TechPaula/LT6502/Case/LT6502_DisplayFront.3mf

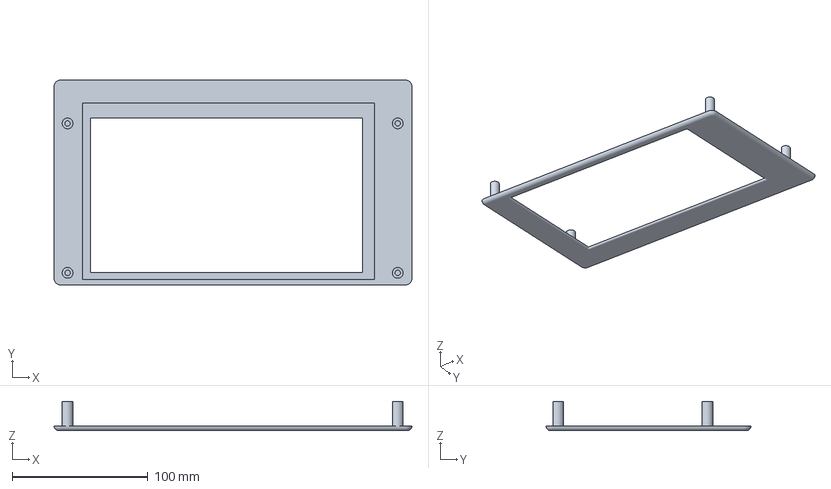
[picture p1: CAD file, 2026-02-14, last stored version]
Case/LT6502_DisplayFront.3mf
263.5 x 151.0 x 21.7 mm
