TechPaula/LT6502/Schematics/EXP-TRANSPUTER/EXP-TRANSPUTER.step

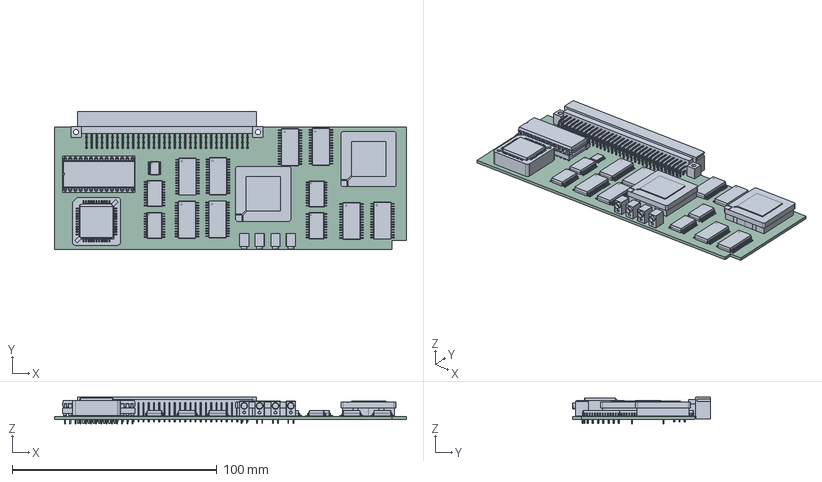
[picture p2: CAD file, 2025-12-27, last stored version]
Schematics/EXP-TRANSPUTER/EXP-TRANSPUTER.step
172.0 x 67.6 x 13.1 mm
SOIC-20W_7.5x12.8mm_P1.27mm x 4
SOP-28_8.4x18.16mm_P1.27mm x 8
PinSocket_1x10_P2.54mm_Vertical x 4
PinSocket_2x03_P2.54mm_Vertical x 8
PinSocket_2x10_P2.54mm_Vertical x 4
Tnn_PGA84 x 2
LTL-4221NHBP x 4
DIN41612_C_3x32_Male_Horizontal_THT
TSSOP-20_4.4x6.5mm_P0.65mm
PLCC-44-AT
plcc44
DIP-28_W15.24mm
DIP-28_W15.24mm_Socket
EXP-TRANSPUTER_PCB
