TechPaula/LT6502/Schematics/Keybed/LT6502_KEYBED.step

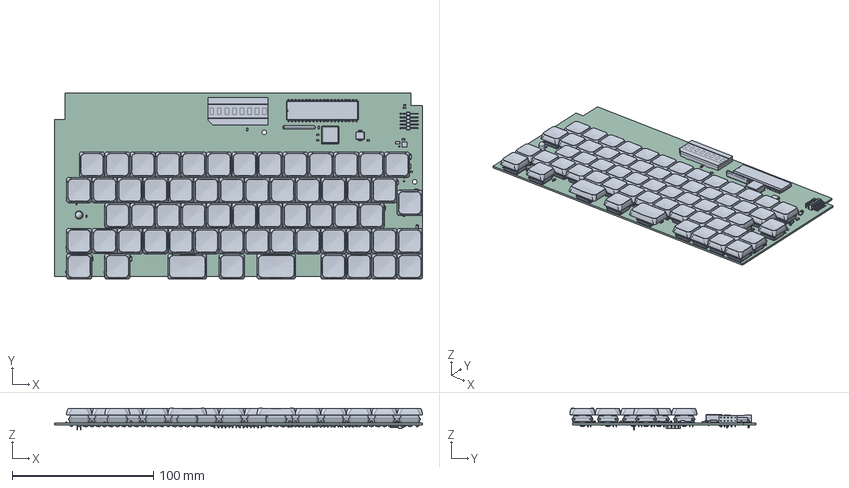
[picture p3: CAD file, 2025-12-19, last stored version]
Schematics/Keybed/LT6502_KEYBED.step
260.5 x 132.0 x 15.3 mm
Kailh Choc FunkMonk 1u x 59
D_SOD-123 x 58
SSOP-16_5.3x6.2mm_P0.65mm
LED_0603_1608Metric x 11
C_0805_2012Metric x 7
R_0603_1608Metric x 14
C_1206_3216Metric x 2
PinHeader_2x05_P2.54mm_Horizontal
Kailh Choc FunkMonk 1.5u x 2
LED_D5.0mm
R_Array_SIP9
HDSP-2502
R_0402_1005Metric
STL9P3LLH6
Oscillator_DIP-8
DIP-40_W15.24mm
PinHeader_1x04_P2.54mm_Horizontal
LT6502_KEYBED_PCB
