TechPaula/LT6502/Schematics/LT6502/LT6502_SIMPLE.step

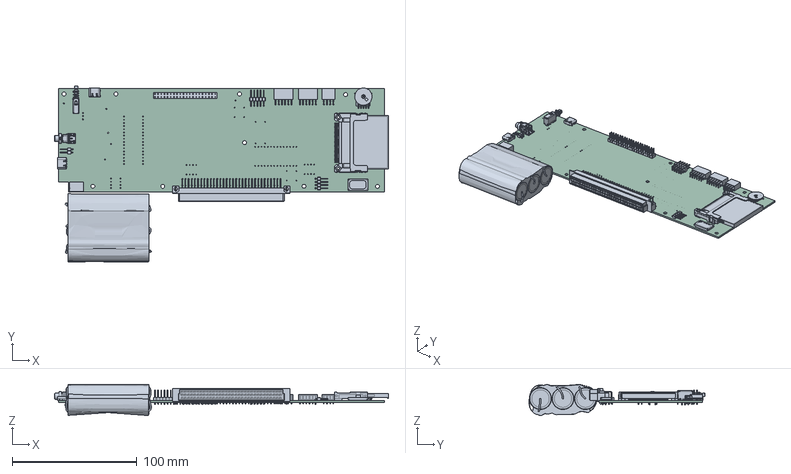
[picture p4: CAD file, 2025-12-17, last stored version]
Schematics/LT6502/LT6502_SIMPLE.step
267.5 x 140.8 x 25.0 mm
LC1258EENP
PinHeader_1x02_P2.54mm_Horizontal
86094648813H55V1LF
CMS-160925-078SP-67
RK10J12R0A0B
PinSocket_2x06_P2.54mm_Horizontal x 2
LeadsArray
3S BMS
Kapton
TL1250F180RQRCLR
UJ20-C-H-G-SMT-1-P16-TR x 2
693120035011_PATTE x 2
693120035011_PIN_HAUT_COURTE
693120035011_PIN_BAS_LONGUE x 3
693120035011_PIN_HAUT_LONGUE x 2
693120035011_PIN_BAS x 22
693120035011_PIN_HAUT x 22
CompactFlash (CF) Memory Card
PinHeader_1x04_P2.54mm_Horizontal
PinSocket_2x04_P2.54mm_Horizontal
PinHeader_2x20_P2.54mm_Vertical
PinHeader_2x05_P2.54mm_Horizontal
LT6502_PCB
