TechPaula/LT6502/Schematics/Multi-Ex/Expansion-Template.step

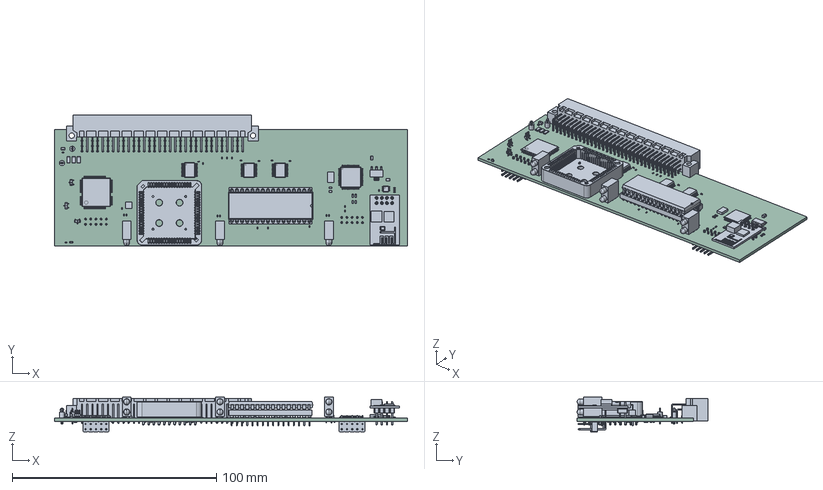
[picture p5: CAD file, 2026-02-22, last stored version]
Schematics/Multi-Ex/Expansion-Template.step
173.0 x 64.2 x 17.0 mm
R_0603_1608Metric x 6
PinHeader_1x03_P1.00mm_Vertical_SMD_Pin1Left x 3
STL9P3LLH6
R_0402_1005Metric x 25
C_0402_1005Metric x 29
SSOP-20_5.3x7.2mm_P0.65mm x 3
TestPoint_Loop_D1.80mm_Drill1.0mm_Beaded x 2
TQFP-44_10x10mm_P0.8mm
PinsArrayLR
PinsArrayTB
LED_0603_1608Metric
C_0805_2012Metric x 3
DIP-32_W15.24mm
DIP-32_W15.24mm_Socket
R_1206_3216Metric x 3
ESP8266-01_ESP-01
LTL-42D1NMHDP1 x 3
SSOP-8_2.95x2.8mm_P0.65mm
SOT-223
Pins
PLCC-68-AT
PinHeader_2x05_P2.54mm_Horizontal x 2
Multi-Ex_PCB
