TechPaula/LT6502/Case/HingeParts.3mf

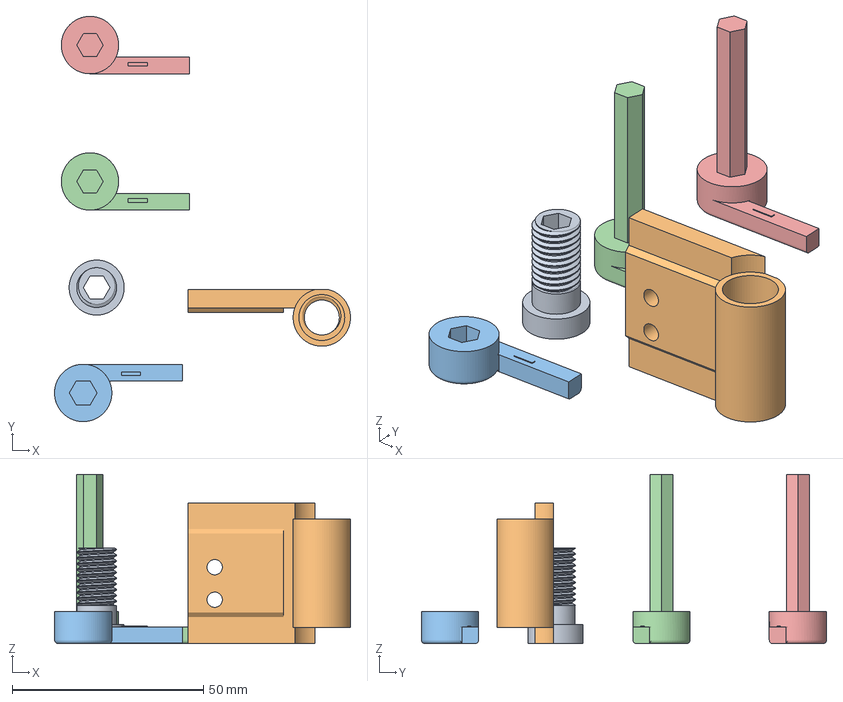
[picture p6: CAD file, 2026-02-14, last stored version]
Case/HingeParts.3mf
77.4 x 105.9 x 44.3 mm
Hinge_ThreadedHollowHex.stl
Hinge_LidPart.stl
Hinge_Base_RHS.stl
Hinge_Base_LHS.stl x 2
