TechPaula/LT6502/Case/Hinge_LidPart.stl

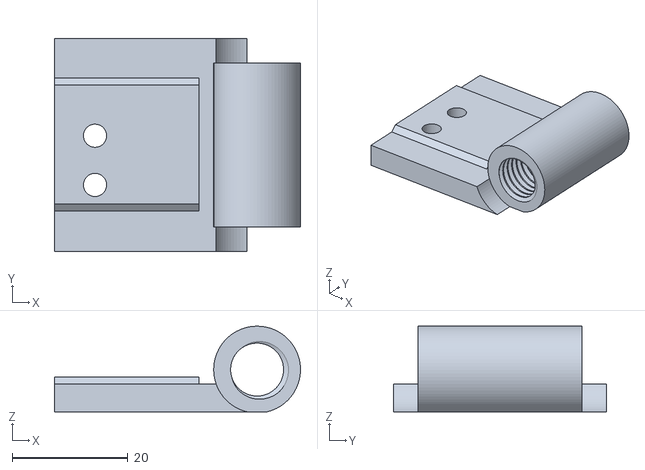
[picture p7: CAD file, 2026-02-11, last stored version]
Case/Hinge_LidPart.stl
42.5 x 36.8 x 14.8
