TechPaula/LT6502/Case/Hinge_Base_RHS.stl

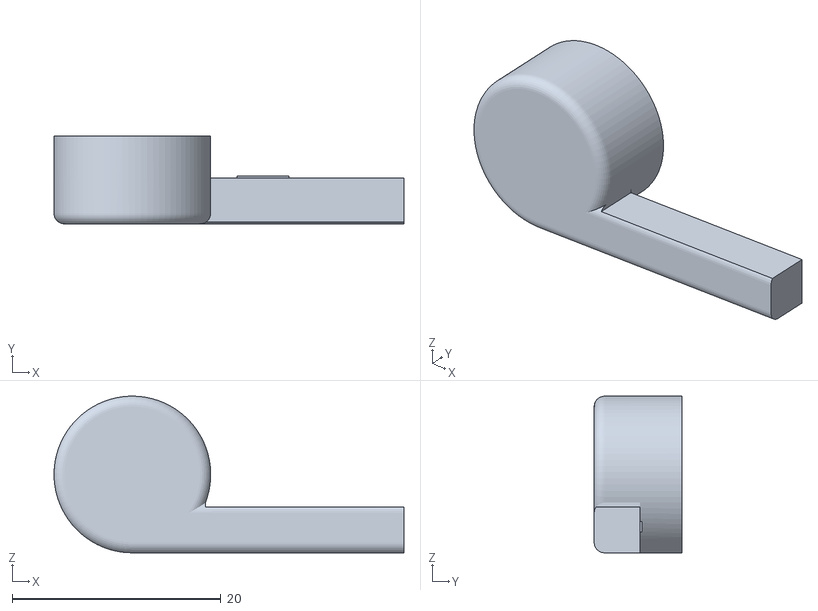
[picture p8: CAD file, 2026-02-11, last stored version]
Case/Hinge_Base_RHS.stl
33.5 x 8.40 x 15.0
