TechPaula/LT6502/Case/Hinge_Base_LHS.stl

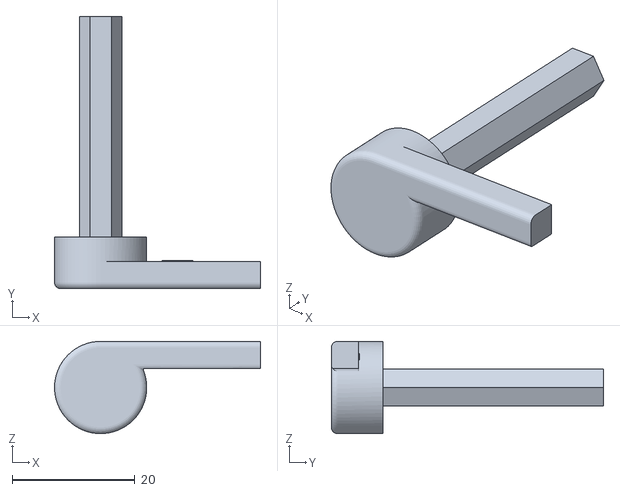
[picture p9: CAD file, 2026-02-11, last stored version]
Case/Hinge_Base_LHS.stl
33.5 x 44.3 x 15.0
