TechPaula/LT6502/Case/Hinge_ThreadedHollowHex.stl

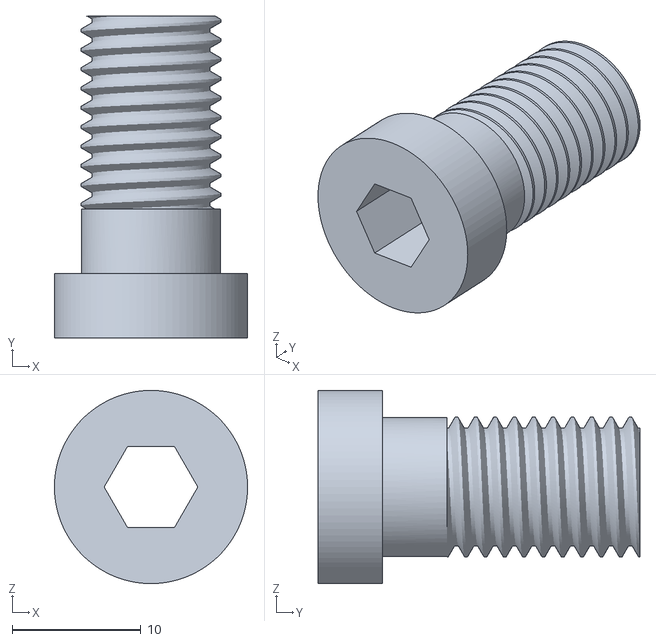
[picture p10: CAD file, 2026-02-11, last stored version]
Case/Hinge_ThreadedHollowHex.stl
15.0 x 25.0 x 15.0
