TechPaula/LT6502/Case/LT6502_DisplayBack.3mf

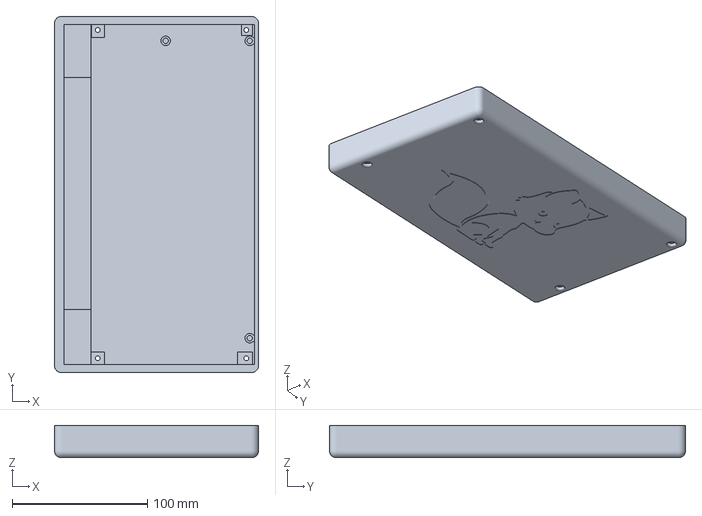
[picture p11: CAD file, 2026-02-08, last stored version]
Case/LT6502_DisplayBack.3mf
151.0 x 263.5 x 24.0 mm
