TechPaula/LT6502/Case/LT6502_BASE_TOP.3mf

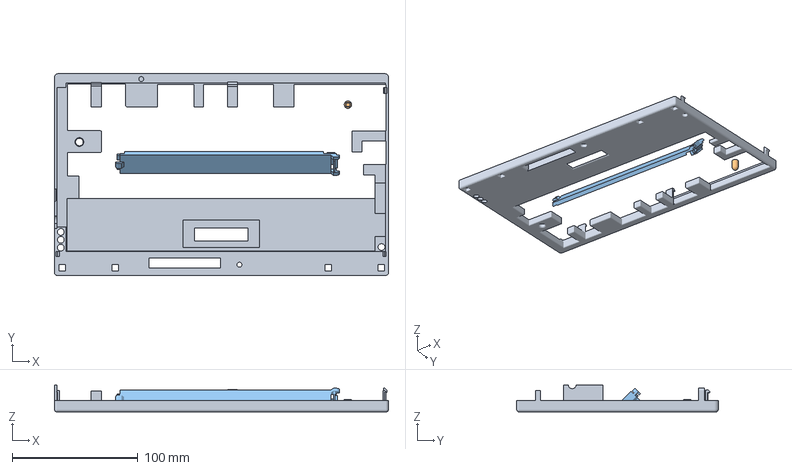
[picture p12: CAD file, 2026-02-08, last stored version]
Case/LT6502_BASE_TOP.3mf
265.5 x 160.4 x 21.5 mm
LT6502_BASE_TOP.stl
PowerButton.stl
ExpansionCover.stl
