TechPaula/LT6502/Case/PowerButton.stl

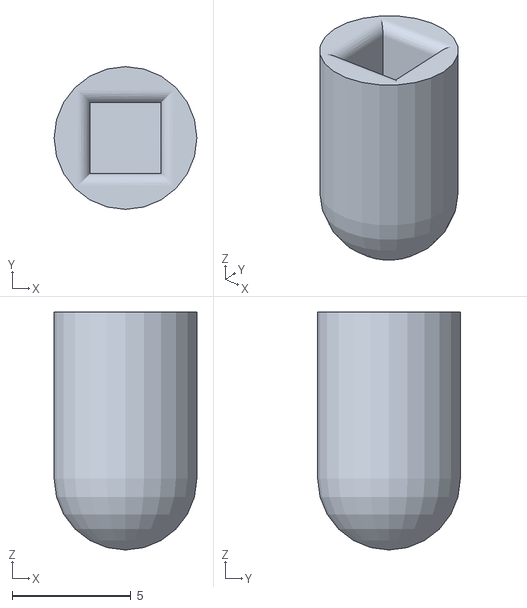
[picture p13: CAD file, 2026-02-04, last stored version]
Case/PowerButton.stl
6.00 x 6.00 x 10.0
