TechPaula/LT6502/Case/ExpansionCover.stl

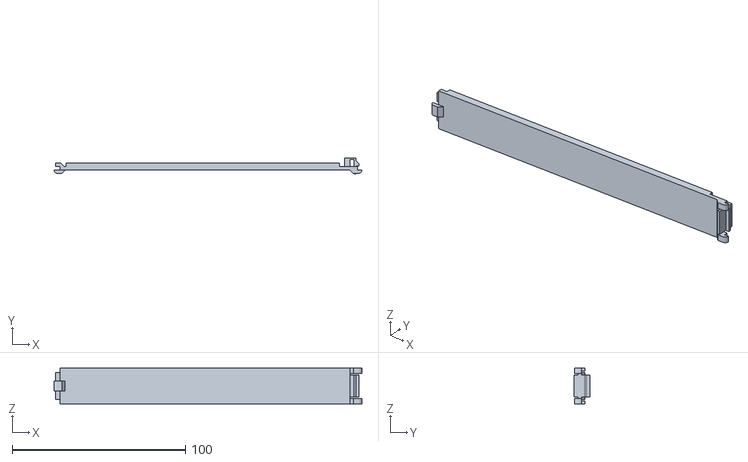
[picture p14: CAD file, 2026-02-04, last stored version]
Case/ExpansionCover.stl
178.0 x 9.50 x 20.7
