TechPaula/LT6502/Case/LT6502_BASE_LOWER.3mf

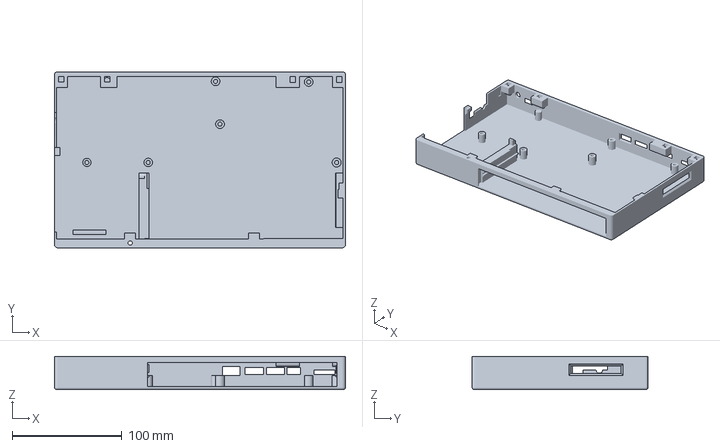
[picture p15: CAD file, 2026-02-02, last stored version]
Case/LT6502_BASE_LOWER.3mf
265.6 x 160.4 x 30.5 mm
