TechPaula/LT6502/Case/LT6502_HINGES_COVERS.3mf

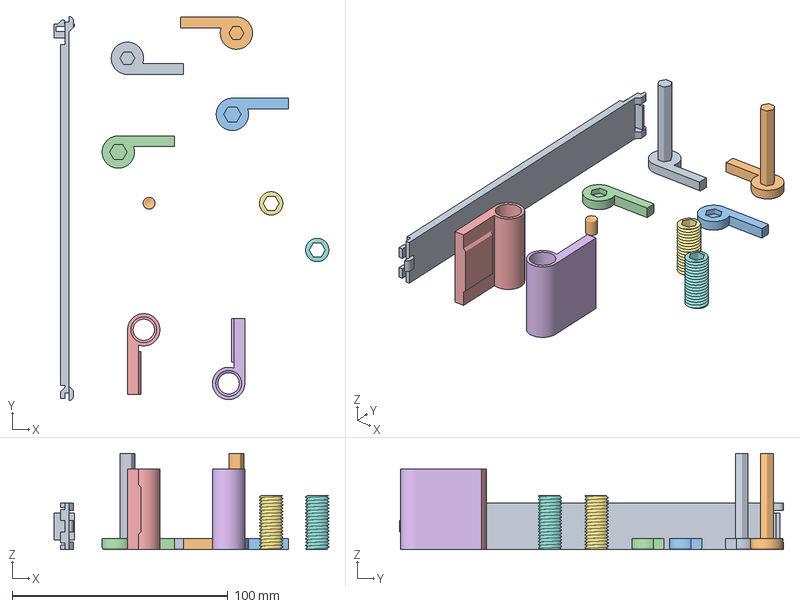
[picture p16: CAD file, 2026-01-03, last stored version]
Case/LT6502_HINGES_COVERS.3mf
127.4 x 178.0 x 44.5 mm
Hinge_Base_LHS.stl x 2
Hinge_Base_RHS.stl x 2
Hinge_LidPart.stl x 2
Hinge_ThreadedHollowHex.stl x 2
ExpansionCover.stl
PowerButton.stl
