TechPaula/LT6502/Case/LT6502_BASETOP_HINGES_COVERS.3mf

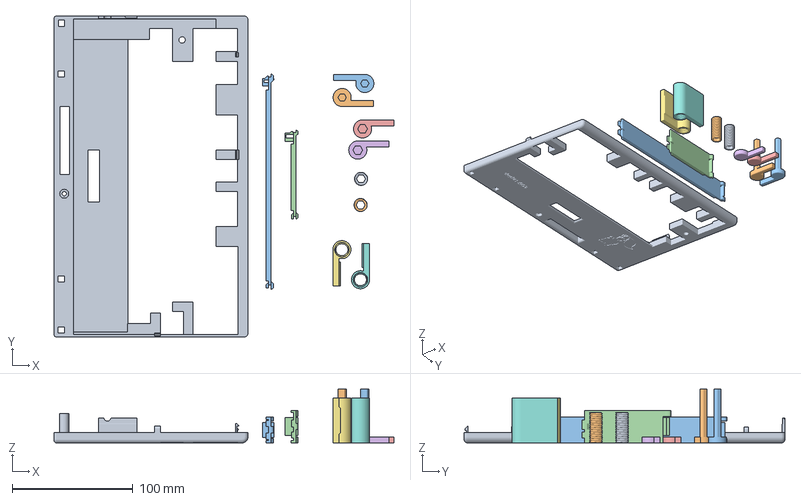
[picture p17: CAD file, 2025-12-30, last stored version]
Case/LT6502_BASETOP_HINGES_COVERS.3mf
281.2 x 265.5 x 44.5 mm
LT6502_BASE_TOP.stl
Hinge_Base_LHS.stl x 2
BatteryCover.stl
Hinge_Base_RHS.stl x 2
Hinge_LidPart.stl x 2
Hinge_ThreadedHollowHex.stl x 2
ExpansionCover.stl
