TechPaula/LT6502/Case/LT6502_DISPLAY_CASE.3mf

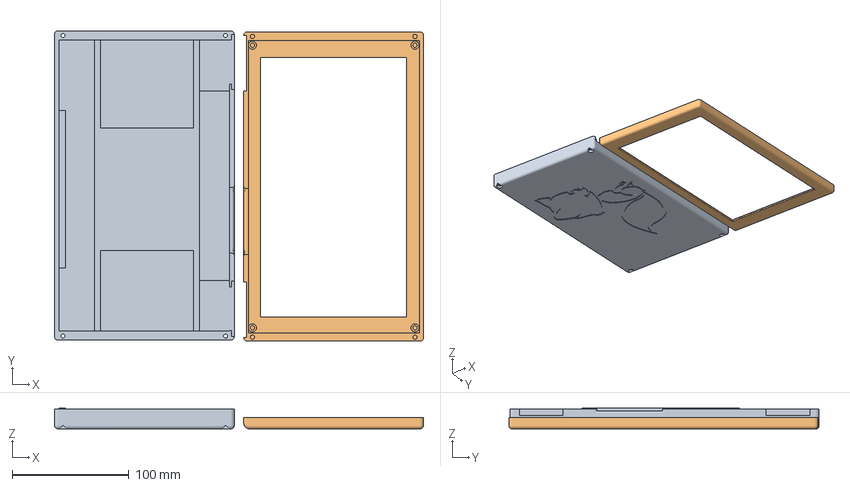
[picture p18: CAD file, 2025-12-30, last stored version]
Case/LT6502_DISPLAY_CASE.3mf
316.6 x 266.4 x 17.9 mm
LT6502_DISPLAY_REAR.stl
LT6502_DISPLAY_FRONT.stl
