TechPaula/LT6502/Case/LT6502_BASE_HINGES_COVERS.3mf

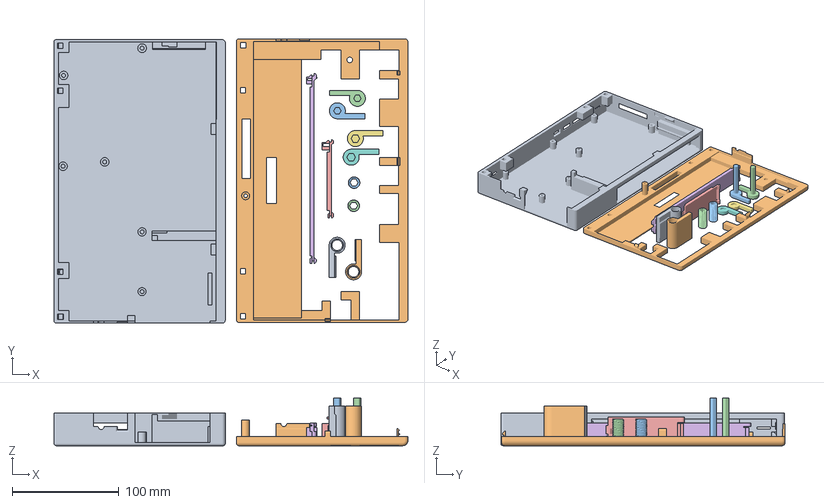
[picture p19: CAD file, 2025-12-28, last stored version]
Case/LT6502_BASE_HINGES_COVERS.3mf
331.5 x 266.3 x 44.5 mm
LT6502_BASE.stl
LT6502_BASE_TOP.stl
Hinge_Base_LHS.stl x 2
BatteryCover.stl
ExpansionCover.stl
Hinge_Base_RHS.stl x 2
Hinge_LidPart.stl x 2
Hinge_ThreadedHollowHex.stl x 2
