TechPaula/LT6502/Case/LT6502_DISPLAY_REAR.stl

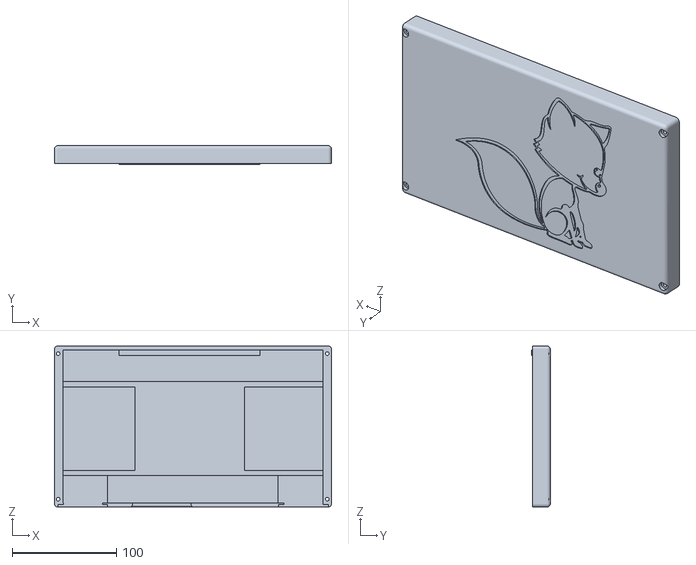
[picture p20: CAD file, 2025-12-27, last stored version]
Case/LT6502_DISPLAY_REAR.stl
265.5 x 17.9 x 154.3
