TechPaula/LT6502/Case/BatteryCover.stl

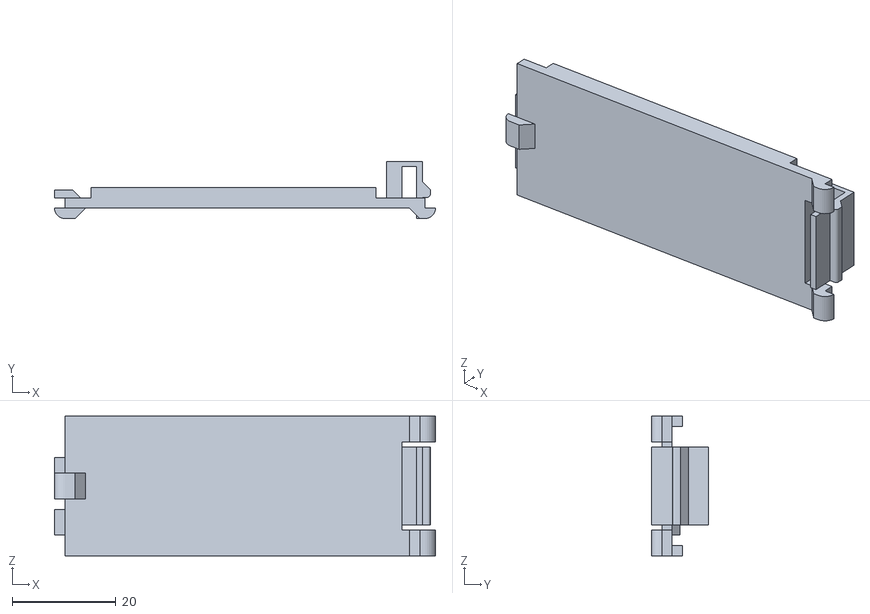
[picture p21: CAD file, 2025-12-27, last stored version]
Case/BatteryCover.stl
73.5 x 11.0 x 27.0
