TechPaula/LT6502/Case/LT6502_HINGE_RHS.stl

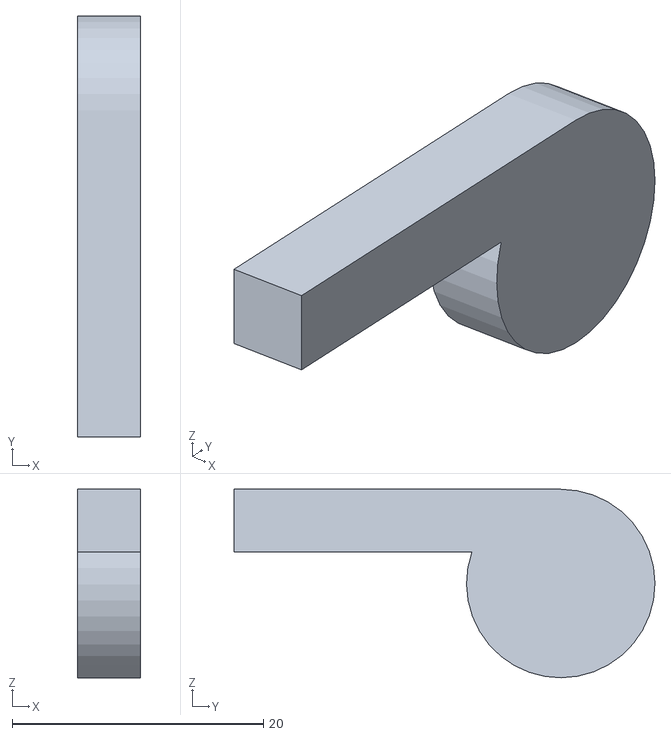
[picture p22: CAD file, 2025-12-26, last stored version]
Case/LT6502_HINGE_RHS.stl
5.00 x 33.5 x 15.0
