TechPaula/LT6502/Case/LT6502_HINGE_LID.stl

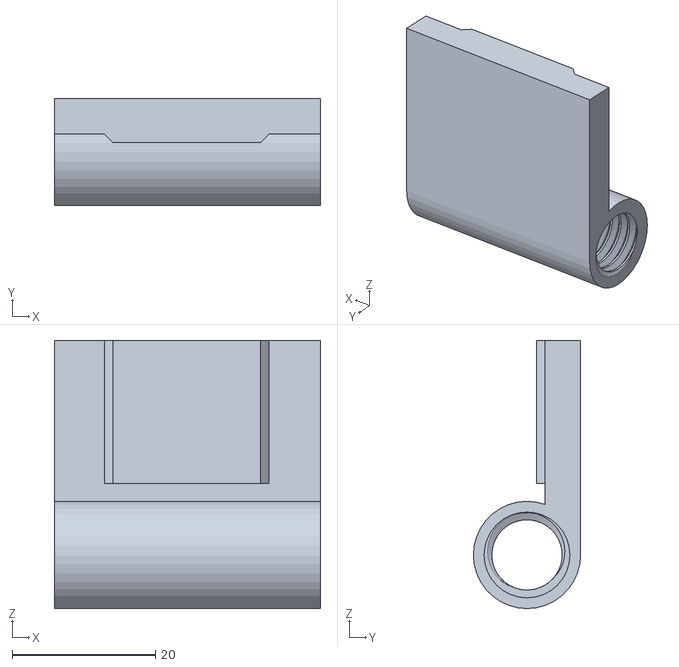
[picture p23: CAD file, 2025-12-26, last stored version]
Case/LT6502_HINGE_LID.stl
37.2 x 15.0 x 37.5
