TechPaula/LT6502/Case/LT6502_THREAD_BARREL.stl

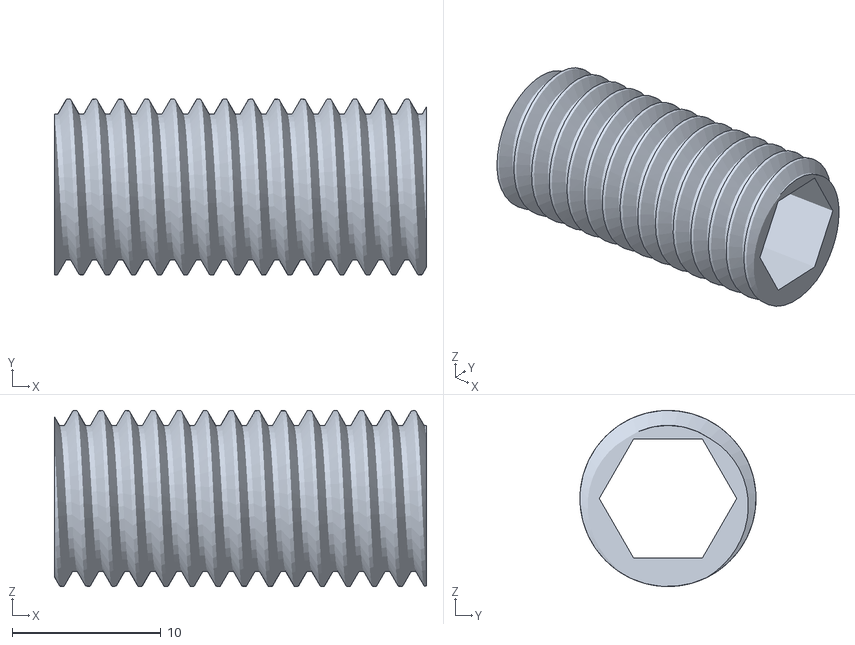
[picture p24: CAD file, 2025-12-26, last stored version]
Case/LT6502_THREAD_BARREL.stl
25.0 x 11.8 x 11.8
