TechPaula/LT6502/Case/LT6502_HINGE_LHS.stl

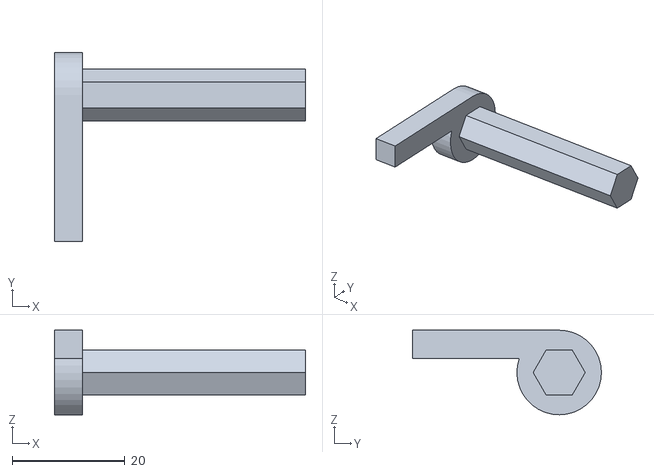
[picture p25: CAD file, 2025-12-26, last stored version]
Case/LT6502_HINGE_LHS.stl
44.5 x 33.5 x 15.0
