TechPaula/LT6502/Case/HingeBody_ptD.stl

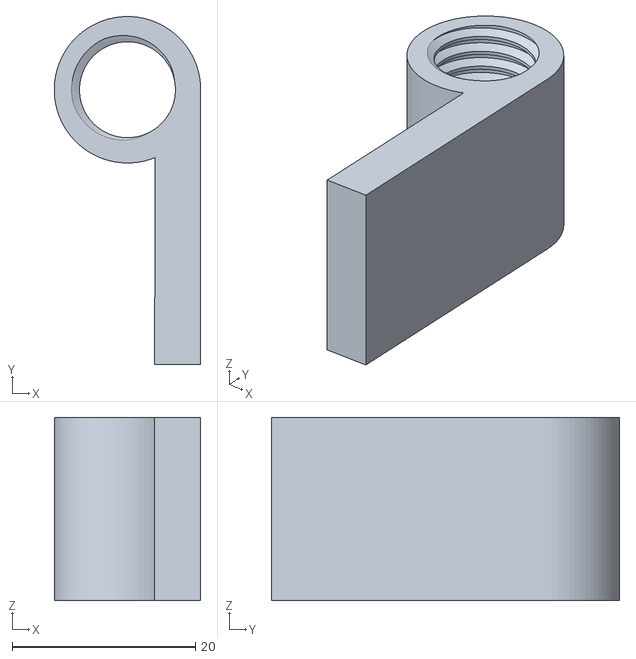
[picture p26: CAD file, 2025-12-26, last stored version]
Case/HingeBody_ptD.stl
16.0 x 38.0 x 20.0
