TechPaula/LT6502/Case/HingeSeatB.stl

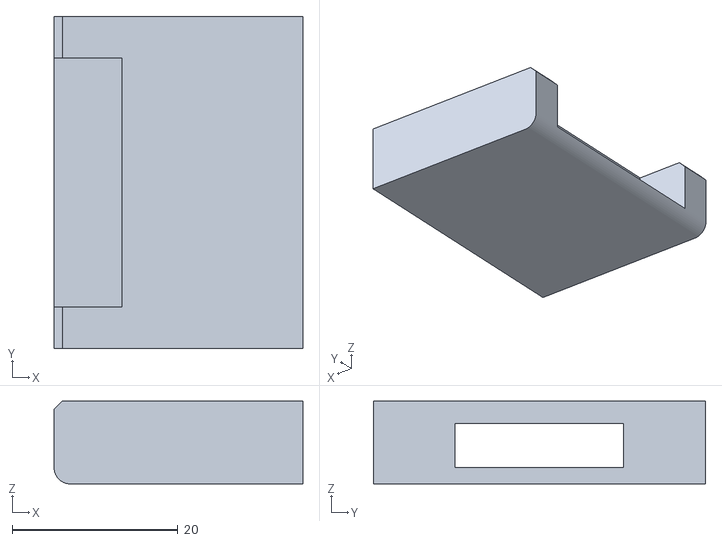
[picture p27: CAD file, 2025-12-26, last stored version]
Case/HingeSeatB.stl
30.0 x 40.0 x 10.0
