TechPaula/LT6502/Case/HingeBody_ptC.stl

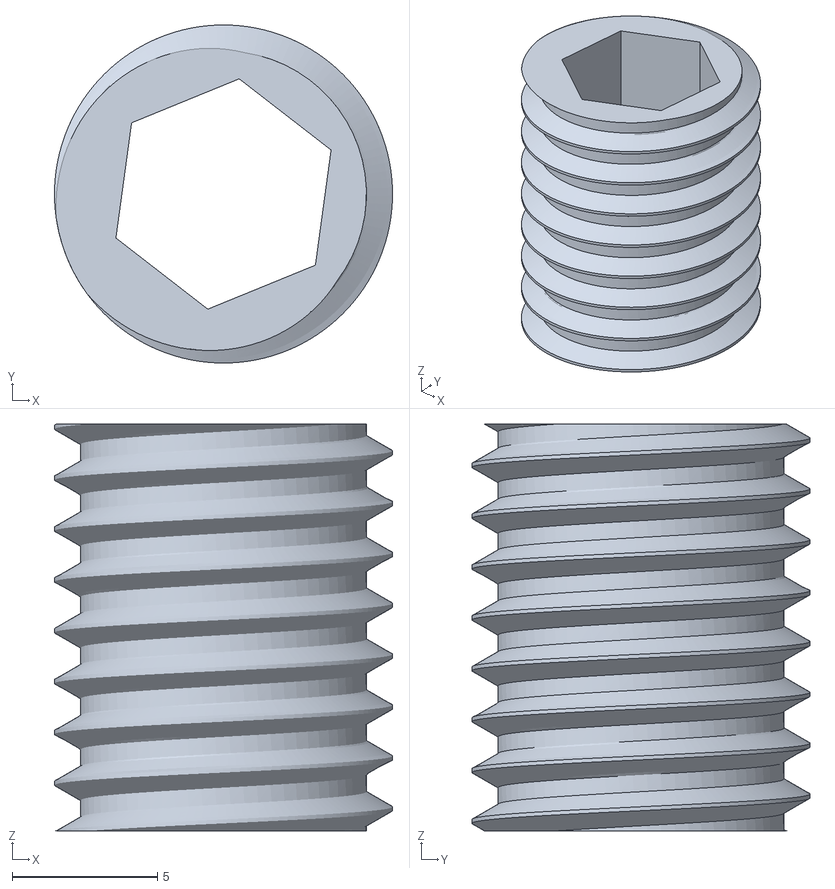
[picture p28: CAD file, 2025-12-26, last stored version]
Case/HingeBody_ptC.stl
11.6 x 11.6 x 14.0
