TechPaula/LT6502/Case/HighBody_ptB.stl

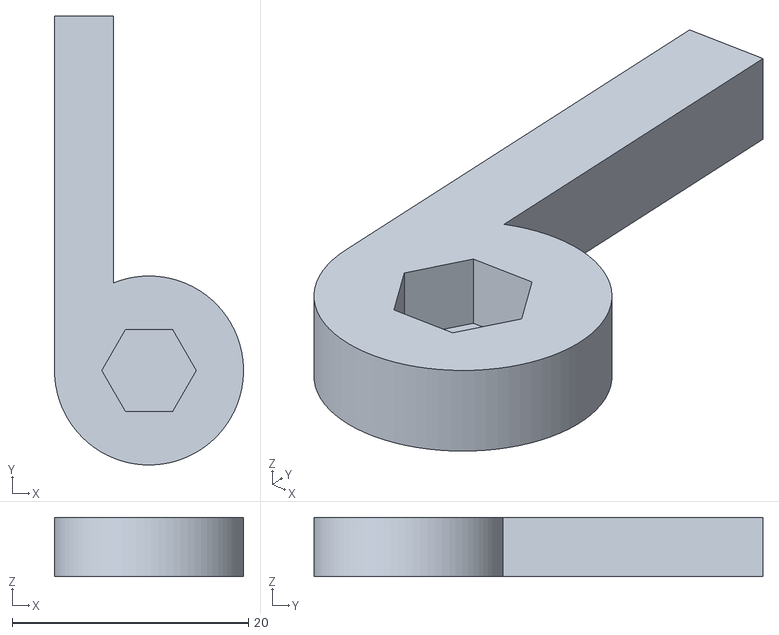
[picture p29: CAD file, 2025-12-26, last stored version]
Case/HighBody_ptB.stl
16.0 x 38.0 x 5.00
