TechPaula/LT6502/Case/HingeSeatA.stl

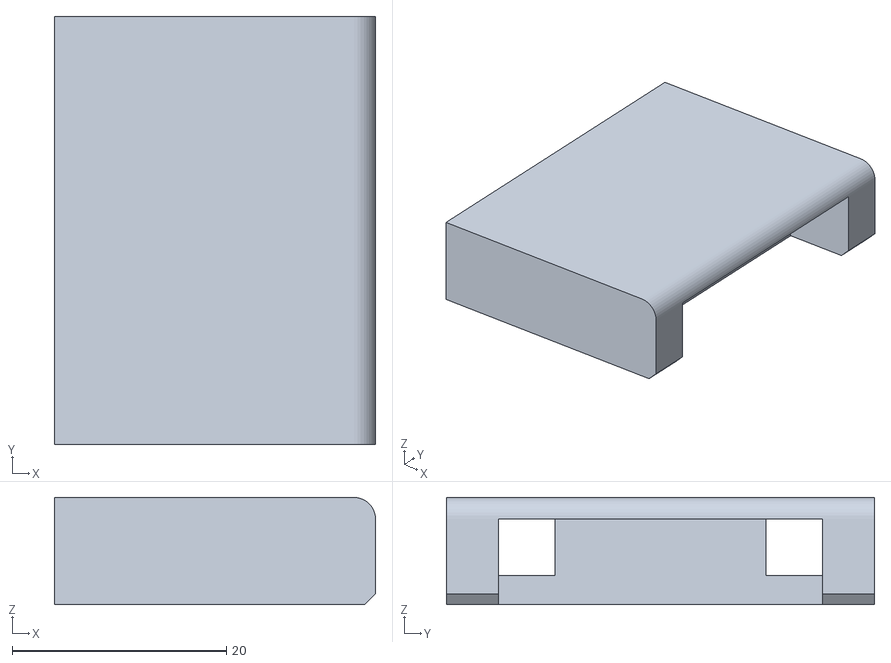
[picture p30: CAD file, 2025-12-26, last stored version]
Case/HingeSeatA.stl
30.0 x 40.0 x 10.0
