TechPaula/LT6502/Case/HingeBody_ptA.stl

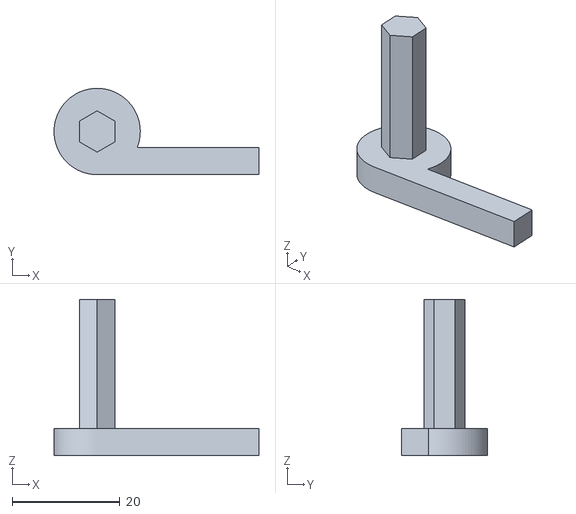
[picture p31: CAD file, 2025-12-26, last stored version]
Case/HingeBody_ptA.stl
38.0 x 16.0 x 29.0
