TechPaula/LT6502/Case/TestHinge.3mf

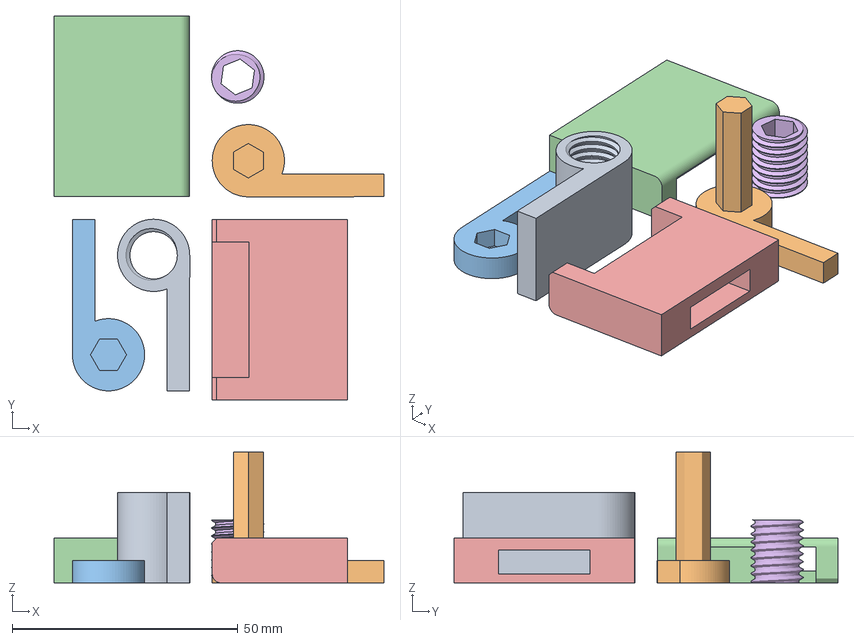
[picture p32: CAD file, 2025-12-26, last stored version]
Case/TestHinge.3mf
73.0 x 85.0 x 29.0 mm
