TechPaula/LT6502/Case/LT6502_Display_Back_20251226.stl

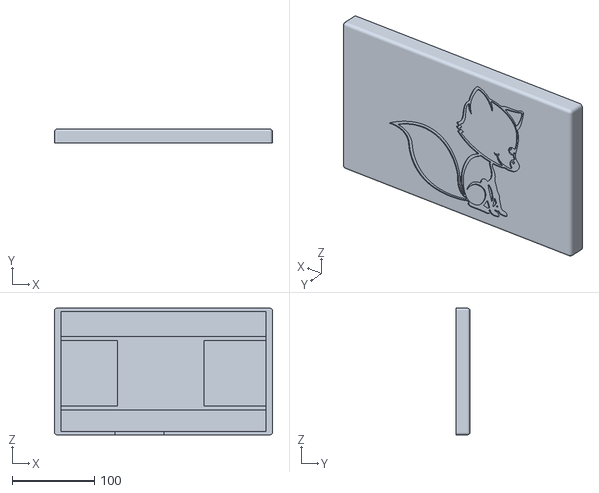
[picture p34: CAD file, 2025-12-26, last stored version]
Case/LT6502_Display_Back_20251226.stl
265.5 x 16.9 x 154.3
