TechPaula/LT6502/Case/LT6502_BaseTop_20251219.stl

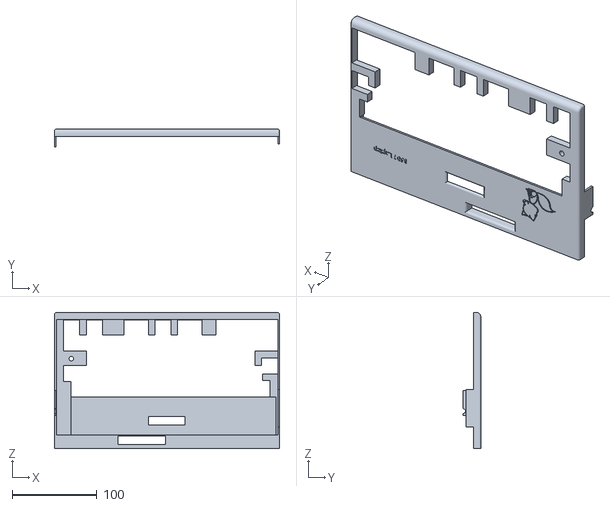
[picture p35: CAD file, 2025-12-19, last stored version]
Case/LT6502_BaseTop_20251219.stl
265.5 x 20.8 x 160.5
