TechPaula/LT6502/Case/LT6502_base_20251219.stl

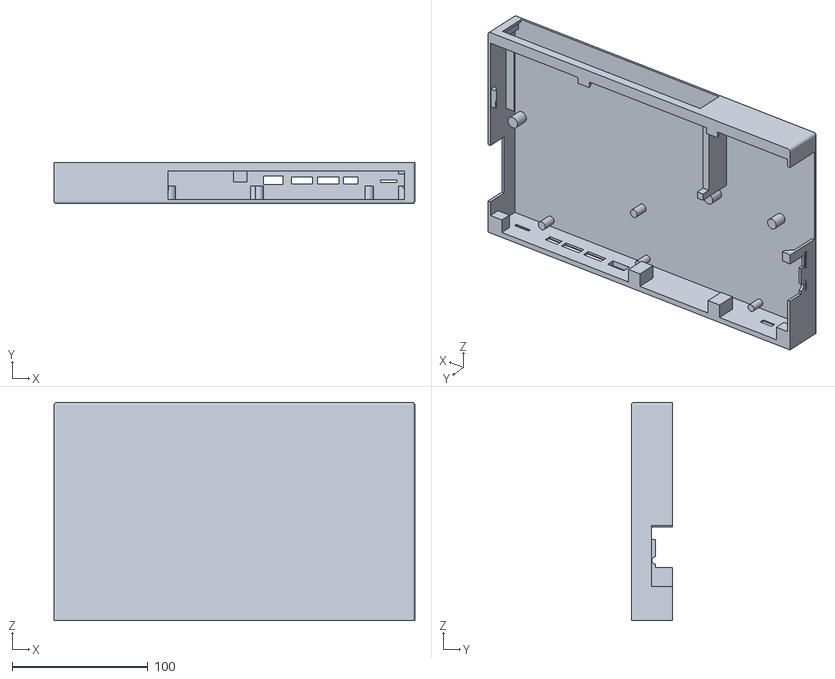
[picture p36: CAD file, 2025-12-19, last stored version]
Case/LT6502_base_20251219.stl
265.6 x 30.5 x 160.4
