TechPaula/LT6502/(list of files, cad)

Other CAD files:
Case/LT6502_BASE.3mf
Case/LT6502_BASE.stl
Case/LT6502_BASETOP.3mf
Case/LT6502_BASE_LOWER.stl
Case/LT6502_BASE_TOP.stl
Case/LT6502_DISPLAY_FRONT.stl
Case/LT6502_DisplayBack.stl
Case/LT6502_DisplayFront.stl
