TechPaula/LT6502/Schematics/Multi-Ex/Multi-Ex.kicad_pcb

## KiCad design Schematics/Multi-Ex/Multi-Ex.kicad_pcb (2026-02-22, last stored version)

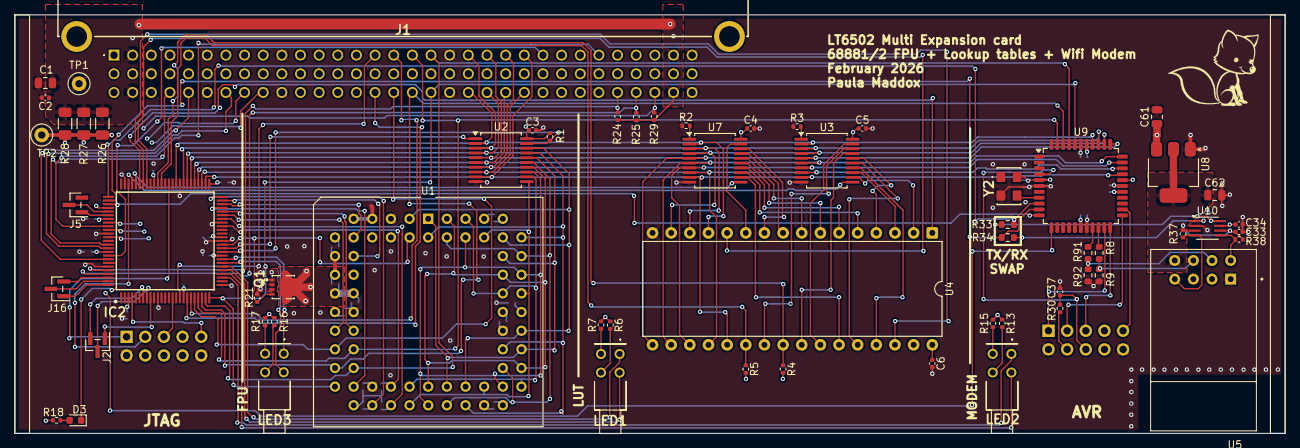
[picture p37: board Multi-Ex.kicad_pcb from above]

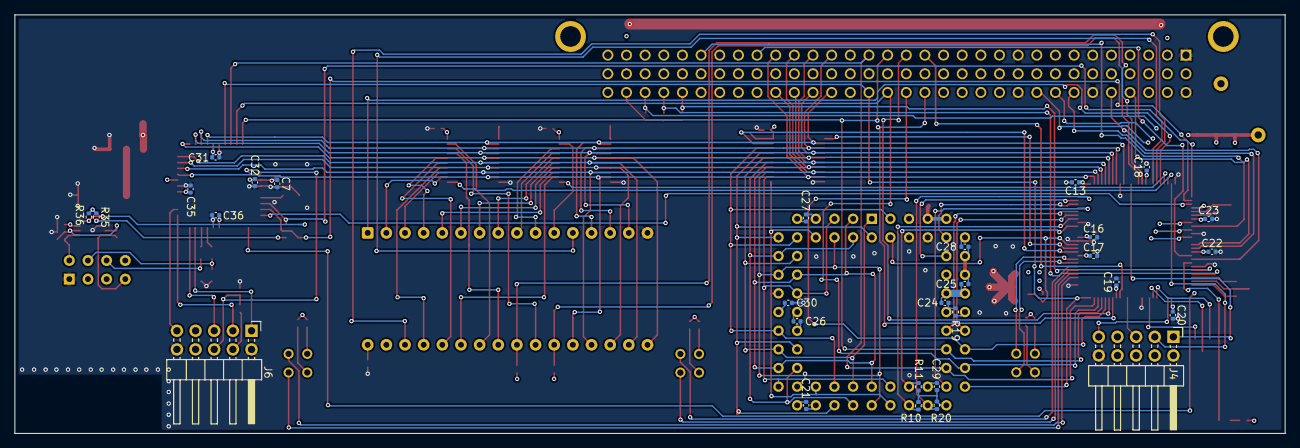
[picture p38: board Multi-Ex.kicad_pcb from below]

Board: 4 copper layers, 173.0 x 57.0 mm, 91 parts (29 on the bottom side), 120 nets.

Parts:
C1: 22uF 25V; C_0805_2012Metric
C2, C3, C4, C5, C6, C7, C13, C16, C17, C18, C19, C20, C21, C22, C23, C24, C25, C26, C27, C28, C29, C30, C31, C32, C33, C34, C35, C36, C37: 100nF; C_0402_1005Metric
C61, C62: 10uF NP; C_0805_2012Metric
D3: LED; LED_0603_1608Metric
FOX1: SYM_Flash_Large; Fox_avatar_18mm
IC2: ATF1508AS-7AX100; QFP50P1600X1600X120-100N
J1: DIN41612_02x32_AC(CAPS); 86093967113745ELF
J2, J5, J16: Conn_01x03; PinHeader_1x03_P1.00mm_Vertical_SMD_Pin1Left
J4, J6: Conn_02x05_Odd_Even; PinHeader_2x05_P2.54mm_Horizontal
LED1, LED2, LED3: LTL-42D1NMHDP1; LTL42D1NMHDP1
Q1: STL9P3LLH6; STL20N6F7
R1, R4, R5, R10, R11, R20, R24, R25, R29, R30, R35, R36, R37, R38: 10K; R_0402_1005Metric
R2, R3, R19: 0R; R_0402_1005Metric
R6, R7, R13, R15, R16, R17, R18: 470R; R_0402_1005Metric
R8, R91: 1K8; R_0603_1608Metric
R9, R92: 3K3; R_0603_1608Metric
R21: 100K; R_0402_1005Metric
R26, R27, R28: 0R; R_1206_3216Metric_Pad1.30x1.75mm_HandSolder
R33, R34: 0R; R_0603_1608Metric
TP1, TP2: TestPoint; TestPoint_Loop_D1.80mm_Drill1.0mm_Beaded
U1: MC68882_PLCC_68; PLCC-68_THT-Socket
U2: 74HC245; SSOP-20_5.3x7.2mm_P0.65mm
U3, U7: 74LS573; SSOP-20_5.3x7.2mm_P0.65mm
U4: SST39SF040; DIP-32_W15.24mm
U5: ESP8266-01_ESP-01; XCVR_ESP8266-01_ESP-01
U8: AMS1117-3.3; SOT-223-3_TabPin2
U9: ATmega644P-20A; TQFP-44_10x10mm_P0.8mm
U10: TXS0102DCT; SSOP-8_2.95x2.8mm_P0.65mm
Y2: ECS-3961-200-AU-TR; ECS3961200AUTR

Connections:
+3.3V: C33.1, C62.1, R37.1, R38.1, U5.8 (VCC), U8.2 (VO), U10.3 (VCCA), U10.6 (OE)
+5V: C3.1, C4.1, C5.1, C6.1, C7.1, C13.1, C16.1, C17.1, C18.1, C19.1, C20.1, C22.1, C23.1, C31.1, C32.1, C34.1, C35.1, C36.1, C61.1, IC2.3 (VCCIO_1), IC2.18 (VCCIO_2), IC2.34 (VCCIO_3), IC2.39 (VCCINT_1), IC2.51 (VCCIO_4), IC2.66 (VCCIO_5), IC2.82 (VCCIO_6), IC2.91 (VCCINT_2), J4.4, J6.4, Q1.1 (S_1), Q1.2 (S_2), Q1.3 (S_3), R1.2, R4.2, R5.2, R6.1, R7.2, R13.1, R15.2, R16.1, R17.2, R18.2, R21.1, R26.2, R27.2, R28.2, R30.1, R35.1, R36.1, TP2.1, U2.20 (VCC), U3.20 (VCC), U4.32 (VCC), U7.20 (VCC), U8.3 (VI), U9.5 (VCC), U9.17 (VCC), U9.27 (AVCC), U9.29 (AREF), U9.38 (VCC), U10.7 (VCCB), Y2.4 (VDD)
/Connector/A0: IC2.25 (I/O_19), J1.C18, U1.26 (A0), U9.40 (PB0)
/Connector/A1: IC2.24 (I/O_18), J1.A18, U1.25 (A1), U9.41 (PB1)
/Connector/A2: IC2.23 (I/O_17), J1.C17, U1.24 (A2), U9.42 (PB2)
/Connector/A3: IC2.22 (I/O_16), J1.A17, U1.23 (A3), U9.43 (PB3)
/Connector/A4: IC2.21 (I/O_15), J1.C16, U1.22 (A4)
/Connector/A5: IC2.20 (I/O_14), J1.A16
/Connector/A6: IC2.19 (I/O_13), J1.C15
/Connector/A7: IC2.17 (I/O_12), J1.A15
/Connector/CLK: IC2.87 (INPUT/GCLK1), J1.C9
/Connector/CLK/2: IC2.85 (I/O/GCLK3), J1.C8
/Connector/CPU_CLK: IC2.90 (INPUT/OE2/GCLK2), J1.C7
/Connector/D0: IC2.60 (I/O_46), J1.C20, U2.2 (A0), U3.2 (D0), U4.13 (D0), U7.2 (D0), U9.37 (PA0)
/Connector/D1: IC2.58 (I/O_45), J1.A20, U2.3 (A1), U3.3 (D1), U4.14 (D1), U7.3 (D1), U9.36 (PA1)
/Connector/D2: IC2.57 (I/O_44), J1.C21, U2.4 (A2), U3.4 (D2), U4.15 (D2), U7.4 (D2), U9.35 (PA2)
/Connector/D3: IC2.56 (I/O_43), J1.A21, U2.5 (A3), U3.5 (D3), U4.17 (D3), U7.5 (D3), U9.34 (PA3)
/Connector/D4: IC2.55 (I/O_42), J1.C22, U2.6 (A4), U3.6 (D4), U4.18 (D4), U7.6 (D4), U9.33 (PA4)
/Connector/D5: IC2.54 (I/O_41), J1.A22, U2.7 (A5), U3.7 (D5), U4.19 (D5), U7.7 (D5), U9.32 (PA5)
/Connector/D6: IC2.53 (I/O_40), J1.C23, U2.8 (A6), U3.8 (D6), U4.20 (D6), U7.8 (D6), U9.31 (PA6)
/Connector/D7: IC2.52 (I/O_39), J1.A23, U2.9 (A7), U3.9 (D7), U4.21 (D7), U7.9 (D7), U9.30 (PA7)
/Connector/EXP_nSEL: IC2.83 (I/O_64), J1.C30, R29.2
/Connector/RDY: IC2.92 (I/O_66), J1.A24
/Connector/RnW: IC2.89 (INPUT/GCLR), J1.C4
/Connector/nIRQ: IC2.84 (I/O_65), J1.A27
/Connector/nRES: IC2.93 (I/O_67), J1.C5
/Connector/nSLOW0: IC2.96 (I/O_69), J1.C28, R24.2
/Connector/nSLOW1: IC2.97 (I/O_70), J1.C29, R25.2
/FPU/Dint0: U1.3 (D0), U1.40 (D24), U1.50 (D16), U1.62 (D8), U2.18 (B0)
/FPU/Dint1: U1.2 (D1), U1.39 (D25), U1.49 (D17), U1.60 (D9), U2.17 (B1)
/FPU/Dint2: U1.1 (D2), U1.38 (D26), U1.48 (D18), U1.59 (D10), U2.16 (B2)
/FPU/Dint3: U1.37 (D27), U1.47 (D19), U1.58 (D11), U1.68 (D3), U2.15 (B3)
/FPU/Dint4: U1.36 (D28), U1.46 (D20), U1.57 (D12), U1.67 (D4), U2.14 (B4)
/FPU/Dint5: U1.35 (D29), U1.45 (D21), U1.56 (D13), U1.66 (D5), U2.13 (B5)
/FPU/Dint6: U1.34 (D30), U1.44 (D22), U1.55 (D14), U1.65 (D6), U2.12 (B6)
/FPU/Dint7: U1.33 (D31), U1.42 (D23), U1.54 (D15), U1.64 (D7), U2.11 (B7)
/FPU/FPU_BUF_DIR: IC2.36 (I/O_28), U2.1 (A->B)
/FPU/FPU_CLK: IC2.48 (I/O_36), U1.11 (CLK)
/FPU/FPU_RnW: IC2.47 (I/O_35), U1.28 (R/*W)
/FPU/FPU_nAS: IC2.46 (I/O_34), U1.21 (*AS)
/FPU/FPU_nBUFEN: IC2.35 (I/O_27), R1.1, U2.19 (CE)
/FPU/FPU_nCS: IC2.50 (I/O_38), R20.2, U1.29 (*CS)
/FPU/FPU_nDS: IC2.45 (I/O_33), U1.20 (*DS)
/FPU/FPU_nDSACK0: IC2.44 (I/O_32), R10.2, U1.31 (*DSACK0)
/FPU/FPU_nDSACK1: IC2.42 (I/O_31), R11.2, U1.32 (*DSACK1)
/FPU/FPU_nRESET: IC2.49 (I/O_37), U1.13 (*RESET)
/GLUE/LUT_BYTE0: IC2.71 (I/O_55), U7.11 (Load)
/GLUE/LUT_BYTE1: IC2.72 (I/O_56), U3.11 (Load)
/GLUE/LUT_FUNC0: IC2.69 (I/O_53), U4.30 (A17)
/GLUE/LUT_FUNC1: IC2.70 (I/O_54), U4.1 (A18)
/GLUE/LUT_RES_HnL: IC2.68 (I/O_52), U4.12 (A0)
/GLUE/LUT_nCS: IC2.64 (I/O_49), R5.1, U4.22 (CE)
/GLUE/LUT_nOE: IC2.65 (I/O_50), R4.1, U4.24 (OE)
/GLUE/MODEM_RX_LED: IC2.29 (I/O_22), LED2.3 (K_2)
/GLUE/MODEM_RnW: IC2.79 (I/O_61), U9.12 (PD3)
/GLUE/MODEM_TX_LED: IC2.28 (I/O_21), LED2.1 (K_1)
/GLUE/MODEM_nCS: IC2.78 (I/O_60), U9.11 (PD2)
/LookUpTable/LUT0: U4.11 (A1), U7.19 (Q0)
/LookUpTable/LUT1: U4.10 (A2), U7.18 (Q1)
/LookUpTable/LUT2: U4.9 (A3), U7.17 (Q2)
/LookUpTable/LUT3: U4.8 (A4), U7.16 (Q3)
/LookUpTable/LUT4: U4.7 (A5), U7.15 (Q4)
/LookUpTable/LUT5: U4.6 (A6), U7.14 (Q5)
/LookUpTable/LUT6: U4.5 (A7), U7.13 (Q6)
/LookUpTable/LUT7: U4.27 (A8), U7.12 (Q7)
/LookUpTable/LUT8: U3.19 (Q0), U4.26 (A9)
/LookUpTable/LUT9: U3.18 (Q1), U4.23 (A10)
/LookUpTable/LUT10: U3.17 (Q2), U4.25 (A11)
/LookUpTable/LUT11: U3.16 (Q3), U4.4 (A12)
/LookUpTable/LUT12: U3.15 (Q4), U4.28 (A13)
/LookUpTable/LUT13: U3.14 (Q5), U4.29 (A14)
/LookUpTable/LUT14: U3.13 (Q6), U4.3 (A15)
/LookUpTable/LUT15: U3.12 (Q7), U4.2 (A16)
/Modem/ESP01_EN: R91.1, U9.19 (PC0)
/Modem/ESP01_nRST: R8.1, U9.20 (PC1)
/Modem/RX_3V3: R37.2, U5.4 (RXD), U10.4 (A2)
/Modem/RX_5V: IC2.76 (I/O_58), R33.2, U9.9 (PD0)
/Modem/TX_3V3: R38.2, U5.5 (TXD), U10.5 (A1)
/Modem/TX_5V: IC2.77 (I/O_59), R34.2, U9.10 (PD1)
AVR_TCK: J6.1, U9.21 (PC2)
AVR_TDI: J6.9, U9.24 (PC5)
AVR_TDO: J6.3, U9.23 (PC4)
AVR_TMS: J6.5, U9.22 (PC3)
AVR_nRST: C37.1, J6.6, R30.2, U9.4 (~RESET)
CONN_5V: C1.1, C2.1, J1.A2, J1.A31, J1.C2, J1.C31, R24.1, R25.1, R26.1, R27.1, R28.1, R29.1, TP1.1
FPU_5V: C21.1, C24.1, C25.1, C26.1, C27.1, C28.1, C29.1, C30.1, Q1.5 (D), Q1.6 (D), Q1.7 (D), R10.1, R11.1, R20.1, U1.10 (VCC), U1.16 (VCC), U1.17 (VCC), U1.27 (VCC), U1.43 (VCC), U1.52 (VCC), U1.53 (VCC), U1.61 (VCC)
FPU_LED0: IC2.33 (I/O_26), LED3.1 (K_1)
FPU_LED1: IC2.32 (I/O_25), LED3.3 (K_2)
FPU_nSENSE: IC2.37 (I/O_29), Q1.4 (G), R21.2, U1.4 (*SENSE)
GND: C1.2, C2.2, C3.2, C4.2, C5.2, C6.2, C7.2, C13.2, C16.2, C17.2, C18.2, C19.2, C20.2, C21.2, C22.2, C23.2, C24.2, C25.2, C26.2, C27.2, C28.2, C29.2, C30.2, C31.2, C32.2, C33.2, C34.2, C35.2, C36.2, C37.2, C61.2, C62.2, IC2.11 (GND_1), IC2.26 (GND_2), IC2.38 (GND_3), IC2.43 (GND_4), IC2.59 (GND_5), IC2.74 (GND_6), IC2.86 (GND_7), IC2.95 (GND_8), J1.A1, J1.A6, J1.A10, J1.A19, J1.A32, J1.C1, J1.C6, J1.C10, J1.C19, J1.C32, J4.2, J4.10, J6.2, J6.10, R2.1, R3.1, R9.2, R19.1, R92.2, U1.5 (GND), U1.6 (GND), U1.7 (GND), U1.8 (GND), U1.9 (GND), U1.12 (GND), U1.14 (GND), U1.19 (GND), U1.30 (GND), U1.41 (GND), U1.51 (GND), U1.63 (GND), U2.10 (GND), U3.10 (GND), U4.16 (GND), U5.1 (GND), U7.10 (GND), U8.1 (GND), U9.6 (GND), U9.18 (GND), U9.28 (GND), U9.39 (GND), U10.2 (GND), Y2.2 (GROUND)
LUT_LED0: IC2.31 (I/O_24), LED1.1 (K_1)
LUT_LED1: IC2.30 (I/O_23), LED1.3 (K_2)
unnamed: D3.2 (A), R18.1
unnamed: D3.1 (K), IC2.94 (I/O_68)
unnamed: IC2.7 (I/O_4), J2.3
unnamed: IC2.8 (I/O_5), J2.2
unnamed: IC2.9 (I/O_6), J2.1
unnamed: IC2.80 (I/O_62), J5.2
unnamed: IC2.81 (I/O_63), J5.1
unnamed: IC2.98 (I/O_71), J16.3
unnamed: IC2.99 (I/O_72), J16.2
unnamed: IC2.100 (I/O_73), J16.1
unnamed: LED1.2 (A_1), R7.1
unnamed: LED1.4 (A_2), R6.2
unnamed: LED2.2 (A_1), R15.1
unnamed: LED2.4 (A_2), R13.2
unnamed: LED3.2 (A_1), R17.1
unnamed: LED3.4 (A_2), R16.2
unnamed: R19.2, U1.18 (SIZE)
unnamed: R3.2, U3.1 (OE)
unnamed: R91.2, R92.1, U5.6 (EN)
unnamed: R8.2, R9.1, U5.7 (~RST)
unnamed: R2.2, U7.1 (OE)
unnamed: U9.8 (XTAL1), Y2.3 (OUTPUT)
unnamed: R33.1, R36.2, U10.8 (B1)
unnamed: R34.1, R35.2, U10.1 (B2)
TCK: IC2.62 (I/O/TCK), J4.1
TDI: IC2.4 (I/O/TDI), J4.9
TDO: IC2.73 (I/O/TDO), J4.3
TMS: IC2.15 (I/O/TMS), J4.5
