TechPaula/LT6502/Schematics/LT6502/LT6502.kicad_pcb

## KiCad design Schematics/LT6502/LT6502.kicad_pcb (continued)

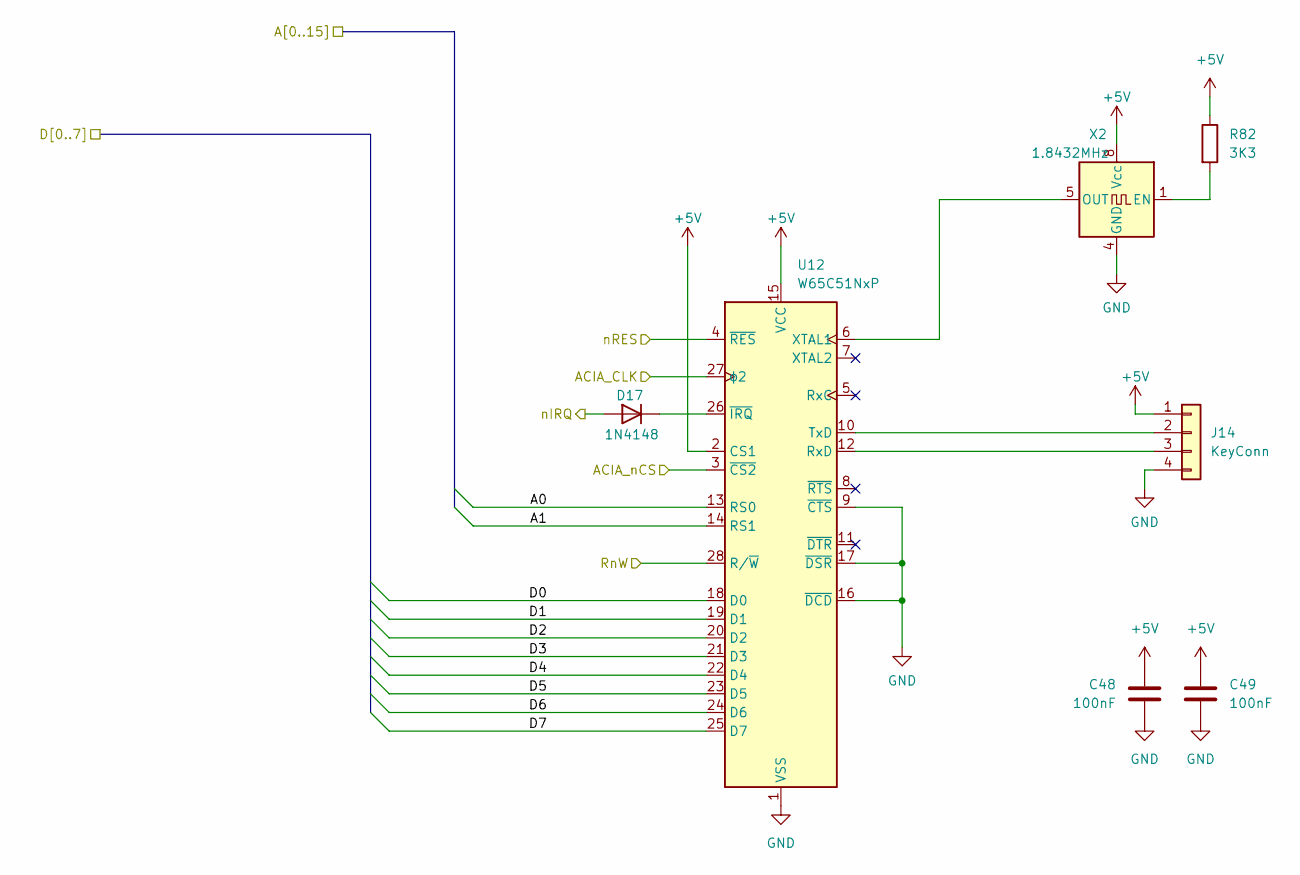
[picture p42: schematic KeyboardIF.kicad_sch]

Parts:
C48, C49: 100nF; C_0603_1608Metric; LCSC C113803
D17: 1N4148; D_DO-35_SOD27_P7.62mm_Horizontal; LCSC DNF
J14: KeyConn; PinHeader_1x04_P2.54mm_Horizontal; LCSC DNF
R82: 3K3; R_0402_1005Metric; LCSC C25890
U12: W65C51NxP; DIP-28_W15.24mm; LCSC DNF
X2: 1.8432MHz; Oscillator_DIP-8; Mouser Part Number 774-MXO45HST-3C-1.8; LCSC DNF

Connections:
+5V: C48.1, C49.1, J14.1, R82.1, U12.2 (CS1), U12.15 (VCC), X2.8 (Vcc); also elsewhere on the board
/A0: U12.13 (RS0); also elsewhere on the board
/A1: U12.14 (RS1); also elsewhere on the board
/D0: U12.18 (D0); also elsewhere on the board
/D1: U12.19 (D1); also elsewhere on the board
/D2: U12.20 (D2); also elsewhere on the board
/D3: U12.21 (D3); also elsewhere on the board
/D4: U12.22 (D4); also elsewhere on the board
/D5: U12.23 (D5); also elsewhere on the board
/D6: U12.24 (D6); also elsewhere on the board
/D7: U12.25 (D7); also elsewhere on the board
ACIA_nCS: U12.3 (~CS2); also elsewhere on the board
CLK: U12.27 (ϕ2); also elsewhere on the board
GND: C48.2, C49.2, J14.4, U12.1 (VSS), U12.9 (~CTS), U12.16 (~DCD), U12.17 (~DSR), X2.4 (GND); also elsewhere on the board
unnamed: D17.1 (K), U12.26 (~IRQ)
unnamed: J14.2, U12.10 (TxD)
unnamed: J14.3, U12.12 (RxD)
unnamed: U12.6 (XTAL1), X2.5 (OUT)
unnamed: R82.2, X2.1 (EN)
RnW: U12.28 (R/~W); also elsewhere on the board
nIRQ: D17.2 (A); also elsewhere on the board
nRES: U12.4 (~RES); also elsewhere on the board

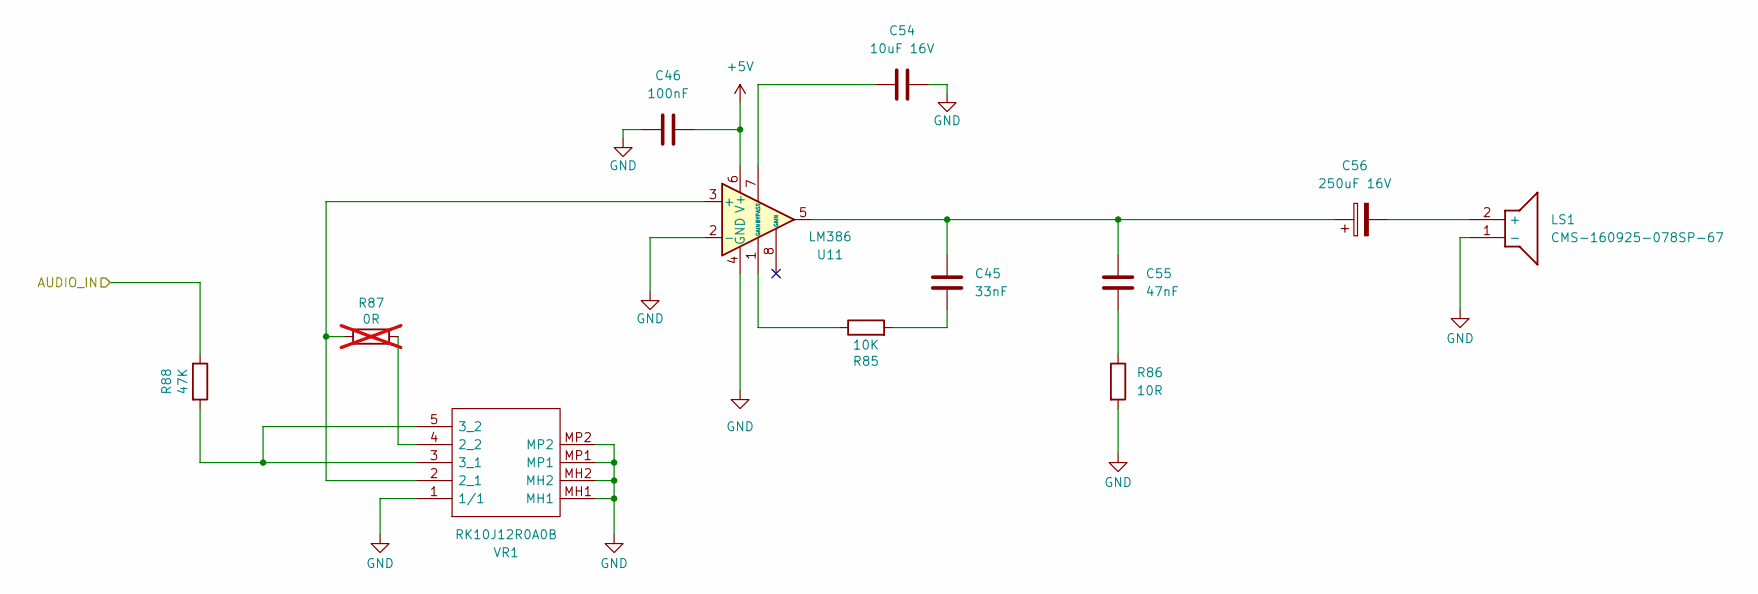
[picture p43: schematic Audio.kicad_sch]

Parts:
C45: 33nF; C_0603_1608Metric; LCSC C21117
C46: 100nF; C_0603_1608Metric; LCSC C113803
C54: 10uF 16V; C_0805_2012Metric; LCSC C15850
C55: 47nF; C_0603_1608Metric; LCSC C1622
C56: 250uF 16V; CP_Elec_10x12.5; Mouser Part Number 667-EEV-FK1V681Q
LS1: CMS-160925-078SP-67; CMS160925078SP67; Mouser Part Number 490-CMS160925078SP67
R85: 10K; R_0402_1005Metric; LCSC C25744
R86: 10R; R_0805_2012Metric; LCSC C844598
R87: 0R; R_0402_1005Metric; LCSC DNF; not fitted
R88: 47K; R_0402_1005Metric; LCSC DNF
U11: LM386; DIP-8_W7.62mm; Mouser Part Number 926-LM386N-3/NOPB
VR1: RK10J12R0A0B; Mouser Part Number 688-RK10J12R0A0B

Connections:
+5V: C46.2, U11.6 (V+); also elsewhere on the board
AUDIO: R88.1; also elsewhere on the board
GND: C46.1, C54.1, LS1.1 (-), R86.2, U11.2 (-), U11.4 (GND), VR1.1 (1/1), VR1.MH1, VR1.MH2, VR1.MP1, VR1.MP2; also elsewhere on the board
unnamed: C45.1, C55.1, C56.1, U11.5
unnamed: C45.2, R85.2
unnamed: C55.2, R86.1
unnamed: C56.2, LS1.2 (+)
unnamed: R85.1, U11.1 (GAIN)
unnamed: R87.2, U11.3 (+), VR1.2 (2_1)
unnamed: C54.2, U11.7 (BYPASS)
unnamed: R87.1, VR1.4 (2_2)
unnamed: R88.2, VR1.3 (3_1), VR1.5 (3_2)

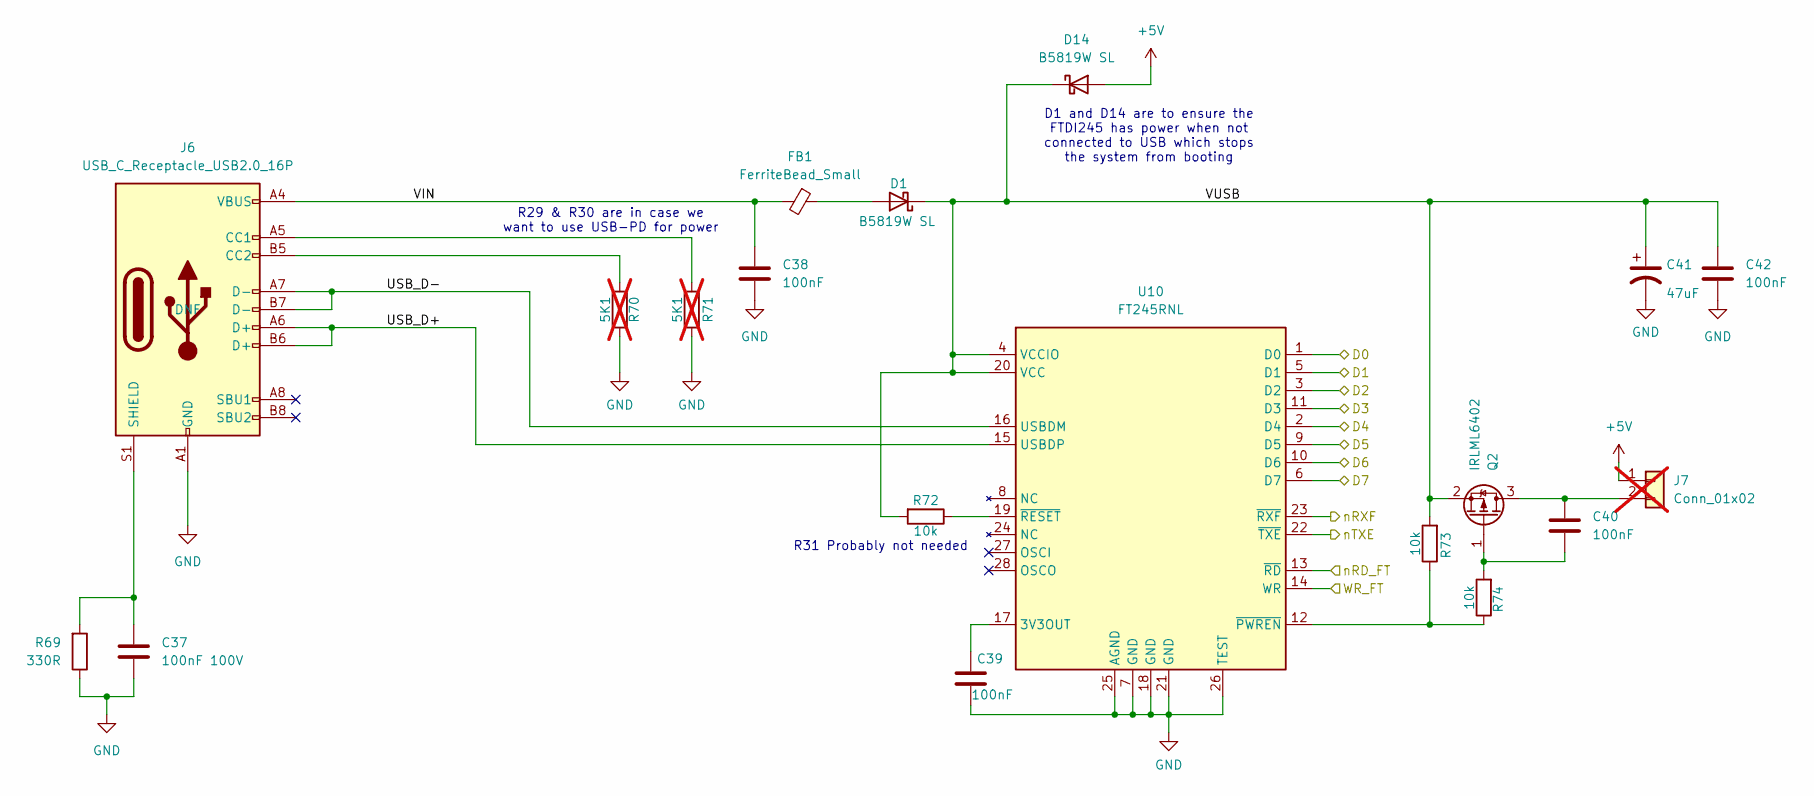
[picture p44: schematic 60FAKE50.kicad_sch]

Parts:
C37: 100nF 100V; C_0603_1608Metric; LCSC C113803
C38, C42: 100nF; C_0805_2012Metric; LCSC C49678
C39, C40: 100nF; C_0603_1608Metric; LCSC C113803
C41: 47uF; C_1206_3216Metric; LCSC C22367835
D1, D14: B5819W SL; D_SOD-123; LCSC C8598
FB1: FerriteBead_Small; L_0805_2012Metric_Pad1.05x1.20mm_HandSolder; LCSC DNF
J6: USB_C_Receptacle_USB2.0_16P; USB_C_Receptacle_HCTL_HC-TYPE-C-16P-01A; LCSC DNF
J7: Conn_01x02; PinHeader_1x02_P2.54mm_Horizontal; LCSC DNF; not fitted
Q2: IRLML6402; SOT-23; Mouser Part Number 942-IRLML6402TRPBF; LCSC C2593
R69: 330R; R_0402_1005Metric; LCSC C25104
R70, R71: 5K1; R_0402_1005Metric; LCSC DNF; not fitted
R72, R73, R74: 10k; R_0402_1005Metric; LCSC C25744
U10: FT245RNL; SSOP-28_5.3x10.2mm_P0.65mm; Mouser Part Number 895-FT245RNL-REEL; LCSC DNF

Connections:
+5V: D14.2 (A), J7.1; also elsewhere on the board
/60FAKE50/USB_D+: J6.A6 (D+), J6.B6 (D+), U10.15 (USBDP)
/60FAKE50/USB_D-: J6.A7 (D-), J6.B7 (D-), U10.16 (USBDM)
/60FAKE50/VIN: C38.1, FB1.2, J6.A4 (VBUS), J6.A9 (VBUS), J6.B4 (VBUS), J6.B9 (VBUS)
/60FAKE50/VUSB: C41.1, C42.1, D1.1 (K), D14.1 (K), Q2.2 (S), R72.2, R73.2, U10.4 (VCCIO), U10.20 (VCC)
/D0: U10.1 (D0); also elsewhere on the board
/D1: U10.5 (D1); also elsewhere on the board
/D2: U10.3 (D2); also elsewhere on the board
/D3: U10.11 (D3); also elsewhere on the board
/D4: U10.2 (D4); also elsewhere on the board
/D5: U10.9 (D5); also elsewhere on the board
/D6: U10.10 (D6); also elsewhere on the board
/D7: U10.6 (D7); also elsewhere on the board
GND: C37.2, C38.2, C39.2, C41.2, C42.2, J6.A1 (GND), J6.A12 (GND), J6.B1 (GND), J6.B12 (GND), R69.1, R70.1, R71.1, U10.7 (GND), U10.18 (GND), U10.21 (GND), U10.25 (AGND), U10.26 (TEST); also elsewhere on the board
unnamed: D1.2 (A), FB1.1
unnamed: J6.A5 (CC1), R71.2
unnamed: J6.B5 (CC2), R70.2
unnamed: C37.1, J6.S1 (SHIELD), R69.2
unnamed: C40.1, J7.2, Q2.3 (D)
unnamed: C40.2, Q2.1 (G), R74.2
unnamed: C39.1, U10.17 (3V3OUT)
unnamed: R73.1, R74.1, U10.12 (~PWREN)
unnamed: R72.1, U10.19 (~RESET)
WR_FT: U10.14 (WR); also elsewhere on the board
nRD_FT: U10.13 (~RD); also elsewhere on the board
nRXF: U10.23 (~RXF); also elsewhere on the board
nTXE: U10.22 (~TXE); also elsewhere on the board

Notes on the sheet:
D1 and D14 are to ensure the FTDI245 has power when not connected to USB which stops the system from booting
R31 Probably not needed
R29 & R30 are in case we want to use USB-PD for power

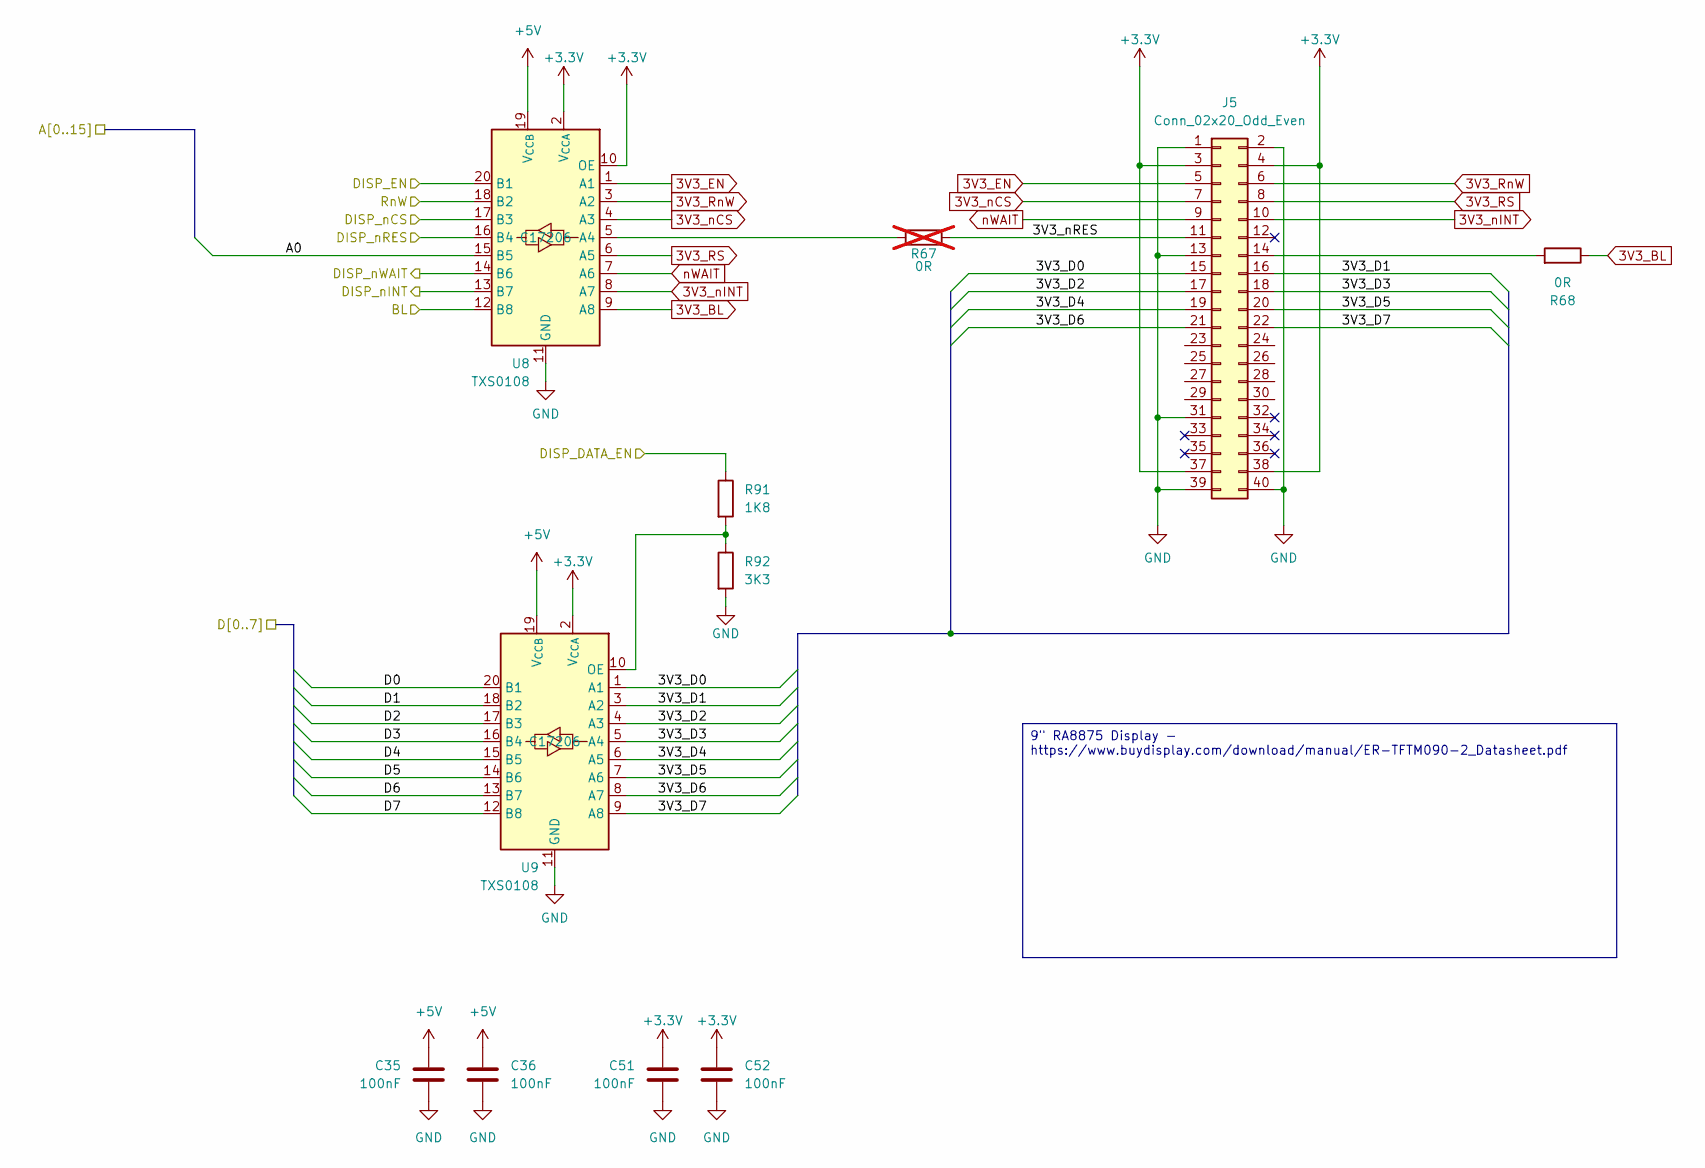
[picture p45: schematic DisplayConnector.kicad_sch]

Parts:
C35, C36, C51, C52: 100nF; C_0603_1608Metric; LCSC C113803
J5: Conn_02x20_Odd_Even; PinHeader_2x20_P2.54mm_Vertical; LCSC DNF
R67: 0R; R_0402_1005Metric; LCSC DNF; not fitted
R68: 0R; R_0402_1005Metric; LCSC DNF
R91: 1K8; R_0603_1608Metric; LCSC C25890
R92: 3K3; R_0603_1608Metric; LCSC C25890
U8, U9: TXS0108; TSSOP-20_4.4x6.5mm_P0.65mm; Mouser Part Number 595-TXB0108PWR; LCSC C17206

Connections:
3V3_BL: R68.1, U8.9 (A8)
3V3_EN: J5.5, U8.1 (A1)
3V3_RS: J5.8, U8.6 (A5)
3V3_RnW: J5.6, U8.3 (A2)
3V3_nCS: J5.7, U8.4 (A3)
3V3_nINT: J5.10, U8.8 (A7)
+3.3V: C51.1, C52.1, J5.3, J5.4, J5.37, J5.38, U8.2 (V_{CCA}), U8.10 (OE), U9.2 (V_{CCA}); also elsewhere on the board
+5V: C35.1, C36.1, U8.19 (V_{CCB}), U9.19 (V_{CCB}); also elsewhere on the board
/A0: U8.15 (B5); also elsewhere on the board
/D0: U9.20 (B1); also elsewhere on the board
/D1: U9.18 (B2); also elsewhere on the board
/D2: U9.17 (B3); also elsewhere on the board
/D3: U9.16 (B4); also elsewhere on the board
/D4: U9.15 (B5); also elsewhere on the board
/D5: U9.14 (B6); also elsewhere on the board
/D6: U9.13 (B7); also elsewhere on the board
/D7: U9.12 (B8); also elsewhere on the board
/Display Connector/3V3_D0: J5.15, U9.1 (A1)
/Display Connector/3V3_D1: J5.16, U9.3 (A2)
/Display Connector/3V3_D2: J5.17, U9.4 (A3)
/Display Connector/3V3_D3: J5.18, U9.5 (A4)
/Display Connector/3V3_D4: J5.19, U9.6 (A5)
/Display Connector/3V3_D5: J5.20, U9.7 (A6)
/Display Connector/3V3_D6: J5.21, U9.8 (A7)
/Display Connector/3V3_D7: J5.22, U9.9 (A8)
/Display Connector/3V3_nRES: J5.11, R67.2
/Display Connector/BL: U8.12 (B8); also elsewhere on the board
/Display Connector/DISP_DATA_EN: R91.1; also elsewhere on the board
/Display Connector/DISP_EN: U8.20 (B1); also elsewhere on the board
/Display Connector/DISP_nCS: U8.17 (B3); also elsewhere on the board
/Display Connector/DISP_nINT: U8.13 (B7); also elsewhere on the board
/Display Connector/DISP_nRES: U8.16 (B4); also elsewhere on the board
/Display Connector/DISP_nWAIT: U8.14 (B6); also elsewhere on the board
GND: C35.2, C36.2, C51.2, C52.2, J5.1, J5.2, J5.13, J5.31, J5.39, J5.40, R92.2, U8.11 (GND), U9.11 (GND); also elsewhere on the board
unnamed: J5.14, R68.2
unnamed: R67.1, U8.5 (A4)
unnamed: R91.2, R92.1, U9.10 (OE)
RnW: U8.18 (B2); also elsewhere on the board
nWAIT: J5.9, U8.7 (A6)

Notes on the sheet:
9" RA8875 Display - https://www.buydisplay.com/download/manual/ER-TFTM090-2_Datasheet.pdf

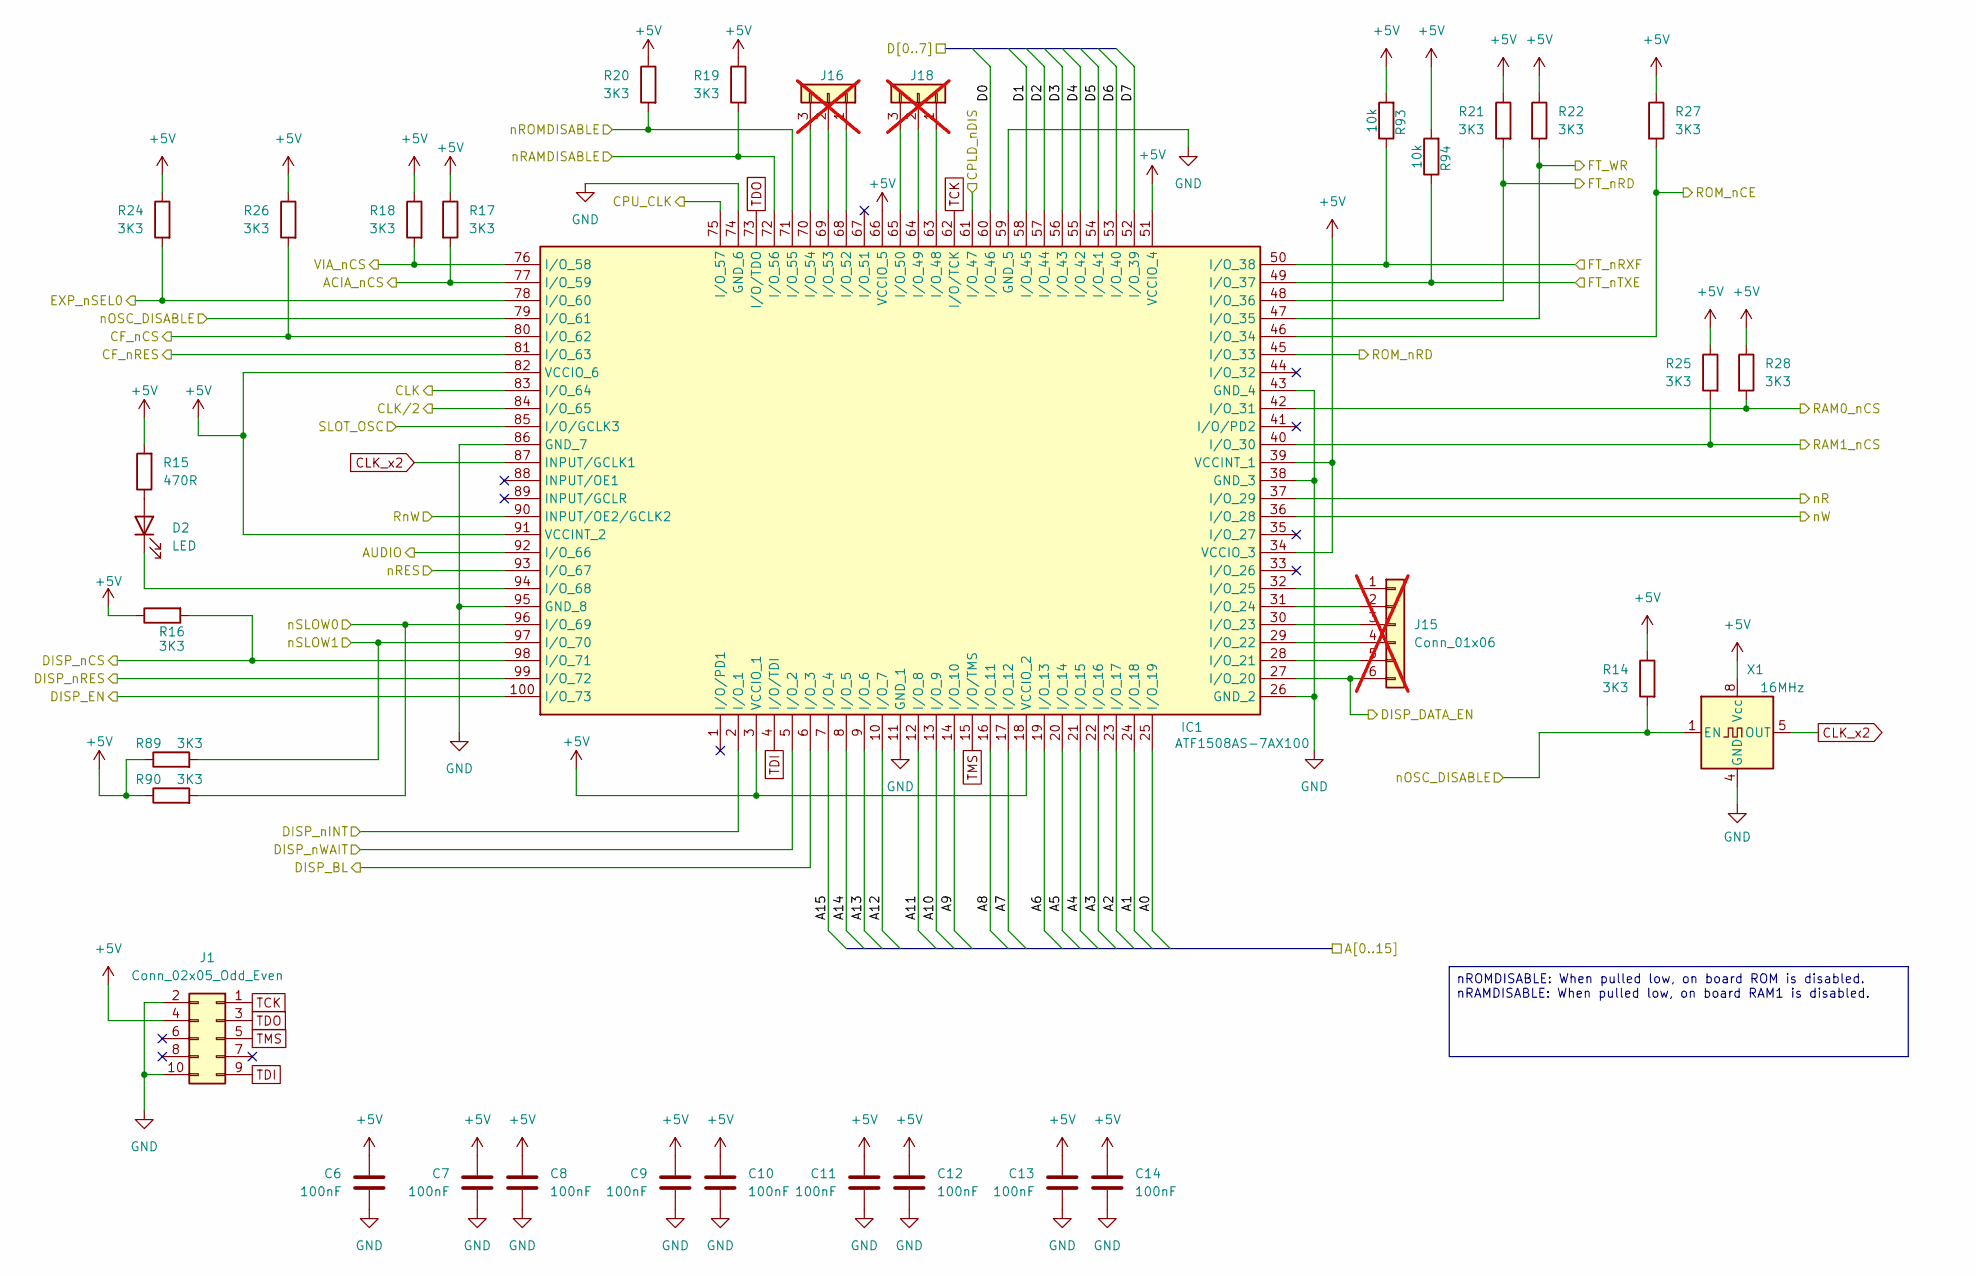
[picture p46: schematic Glue_Addr.kicad_sch]

Parts:
C6, C7, C8, C9, C11, C12, C13, C14: 100nF; C_0603_1608Metric; LCSC C113803
C10: 100nF; C_0402_1005Metric; LCSC C1581
D2: LED; LED_0603_1608Metric; LCSC DNF
IC1: ATF1508AS-7AX100; QFP50P1600X1600X120-100N; Mouser Part Number 556-AF1508AS7AX100
J1: Conn_02x05_Odd_Even; PinHeader_2x05_P2.54mm_Horizontal; LCSC DNF
J15: Conn_01x06; PinHeader_1x06_P1.00mm_Vertical_SMD_Pin1Left; LCSC DNF; not fitted
J16, J18: Conn_01x03; PinHeader_1x03_P1.00mm_Vertical_SMD_Pin1Left; LCSC DNF; not fitted
R14, R16, R17, R18, R19, R20, R21, R22, R24, R25, R26, R27, R28, R89, R90: 3K3; R_0402_1005Metric; LCSC C25890
R15: 470R; R_0402_1005Metric; LCSC C25117
R93, R94: 10k; R_0402_1005Metric; LCSC C25744
X1: 16MHz; Oscillator_DIP-8; Mouser Part Number 520-2100AX-283.2; LCSC DNF

Connections:
+5V: C6.1, C7.1, C8.1, C9.1, C10.1, C11.1, C12.1, C13.1, C14.1, IC1.3 (VCCIO_1), IC1.18 (VCCIO_2), IC1.34 (VCCIO_3), IC1.39 (VCCINT_1), IC1.51 (VCCIO_4), IC1.66 (VCCIO_5), IC1.82 (VCCIO_6), IC1.91 (VCCINT_2), J1.4, R14.1, R15.2, R16.1, R17.1, R18.1, R19.1, R20.1, R21.1, R22.1, R24.1, R25.1, R26.1, R27.1, R28.1, R89.1, R90.1, R93.2, R94.2, X1.8 (Vcc); also elsewhere on the board
/A0: IC1.25 (I/O_19); also elsewhere on the board
/A1: IC1.24 (I/O_18); also elsewhere on the board
/A2: IC1.23 (I/O_17); also elsewhere on the board
/A3: IC1.22 (I/O_16); also elsewhere on the board
/A4: IC1.21 (I/O_15); also elsewhere on the board
/A5: IC1.20 (I/O_14); also elsewhere on the board
/A6: IC1.19 (I/O_13); also elsewhere on the board
/A7: IC1.17 (I/O_12); also elsewhere on the board
/A8: IC1.16 (I/O_11); also elsewhere on the board
/A9: IC1.14 (I/O_10); also elsewhere on the board
/A10: IC1.13 (I/O_9); also elsewhere on the board
/A11: IC1.12 (I/O_8); also elsewhere on the board
/A12: IC1.10 (I/O_7); also elsewhere on the board
/A13: IC1.9 (I/O_6); also elsewhere on the board
/A14: IC1.8 (I/O_5); also elsewhere on the board
/A15: IC1.7 (I/O_4); also elsewhere on the board
/D0: IC1.60 (I/O_46); also elsewhere on the board
/D1: IC1.58 (I/O_45); also elsewhere on the board
/D2: IC1.57 (I/O_44); also elsewhere on the board
/D3: IC1.56 (I/O_43); also elsewhere on the board
/D4: IC1.55 (I/O_42); also elsewhere on the board
/D5: IC1.54 (I/O_41); also elsewhere on the board
/D6: IC1.53 (I/O_40); also elsewhere on the board
/D7: IC1.52 (I/O_39); also elsewhere on the board
/Display Connector/BL: IC1.6 (I/O_3); also elsewhere on the board
/Display Connector/DISP_DATA_EN: IC1.27 (I/O_20), J15.6; also elsewhere on the board
/Display Connector/DISP_EN: IC1.100 (I/O_73); also elsewhere on the board
/Display Connector/DISP_nCS: IC1.98 (I/O_71), R16.2; also elsewhere on the board
/Display Connector/DISP_nINT: IC1.2 (I/O_1); also elsewhere on the board
/Display Connector/DISP_nRES: IC1.99 (I/O_72); also elsewhere on the board
/Display Connector/DISP_nWAIT: IC1.5 (I/O_2); also elsewhere on the board
/ExpansionSlot0/CPLD_nDIS: IC1.61 (I/O_47); also elsewhere on the board
ACIA_nCS: IC1.77 (I/O_59), R17.2; also elsewhere on the board
AUDIO: IC1.92 (I/O_66); also elsewhere on the board
CFnRES: IC1.80 (I/O_62), R26.2; also elsewhere on the board
CLK: IC1.83 (I/O_64); also elsewhere on the board
CLK_x2: IC1.87 (INPUT/GCLK1), X1.5 (OUT)
CLK/2: IC1.84 (I/O_65); also elsewhere on the board
CPU_CLK: IC1.75 (I/O_57); also elsewhere on the board
EXP_nSEL0: IC1.78 (I/O_60), R24.2; also elsewhere on the board
GND: C6.2, C7.2, C8.2, C9.2, C10.2, C11.2, C12.2, C13.2, C14.2, IC1.11 (GND_1), IC1.26 (GND_2), IC1.38 (GND_3), IC1.43 (GND_4), IC1.59 (GND_5), IC1.74 (GND_6), IC1.86 (GND_7), IC1.95 (GND_8), J1.2, J1.10, X1.4 (GND); also elsewhere on the board
unnamed: D2.2 (A), R15.1
unnamed: D2.1 (K), IC1.94 (I/O_68)
unnamed: IC1.28 (I/O_21), J15.5
unnamed: IC1.29 (I/O_22), J15.4
unnamed: IC1.30 (I/O_23), J15.3
unnamed: IC1.31 (I/O_24), J15.2
unnamed: IC1.32 (I/O_25), J15.1
unnamed: IC1.63 (I/O_48), J18.1
unnamed: IC1.64 (I/O_49), J18.2
unnamed: IC1.65 (I/O_50), J18.3
unnamed: IC1.68 (I/O_52), J16.1
unnamed: IC1.69 (I/O_53), J16.2
unnamed: IC1.70 (I/O_54), J16.3
ROM_nCE: IC1.46 (I/O_34), R27.2; also elsewhere on the board
ROM_nR: IC1.45 (I/O_33); also elsewhere on the board
RnW: IC1.90 (INPUT/OE2/GCLK2); also elsewhere on the board
SLOT_OSC: IC1.85 (I/O/GCLK3); also elsewhere on the board
TCK: IC1.62 (I/O/TCK), J1.1
TDI: IC1.4 (I/O/TDI), J1.9
TDO: IC1.73 (I/O/TDO), J1.3
TMS: IC1.15 (I/O/TMS), J1.5
VIA_nCS: IC1.76 (I/O_58), R18.2; also elsewhere on the board
WR_FT: IC1.47 (I/O_35), R22.2; also elsewhere on the board
nCF_CS0: IC1.81 (I/O_63); also elsewhere on the board
nOSC_DISABLE: IC1.79 (I/O_61), R14.2, X1.1 (EN); also elsewhere on the board
nR: IC1.37 (I/O_29); also elsewhere on the board
nRAM0_CS: IC1.42 (I/O_31), R28.2; also elsewhere on the board
nRAM1_CS: IC1.40 (I/O_30), R25.2; also elsewhere on the board
nRAMDISABLE: IC1.72 (I/O_56), R19.2; also elsewhere on the board
nRD_FT: IC1.48 (I/O_36), R21.2; also elsewhere on the board
nRES: IC1.93 (I/O_67); also elsewhere on the board
nROMDISABLE: IC1.71 (I/O_55), R20.2; also elsewhere on the board
nRXF: IC1.49 (I/O_37), R94.1; also elsewhere on the board
nSLOW0: IC1.96 (I/O_69), R90.2; also elsewhere on the board
nSLOW1: IC1.97 (I/O_70), R89.2; also elsewhere on the board
nTXE: IC1.50 (I/O_38), R93.1; also elsewhere on the board
nW: IC1.36 (I/O_28); also elsewhere on the board

Notes on the sheet:
nROMDISABLE: When pulled low, on board ROM is disabled. nRAMDISABLE: When pulled low, on board RAM1 is disabled.

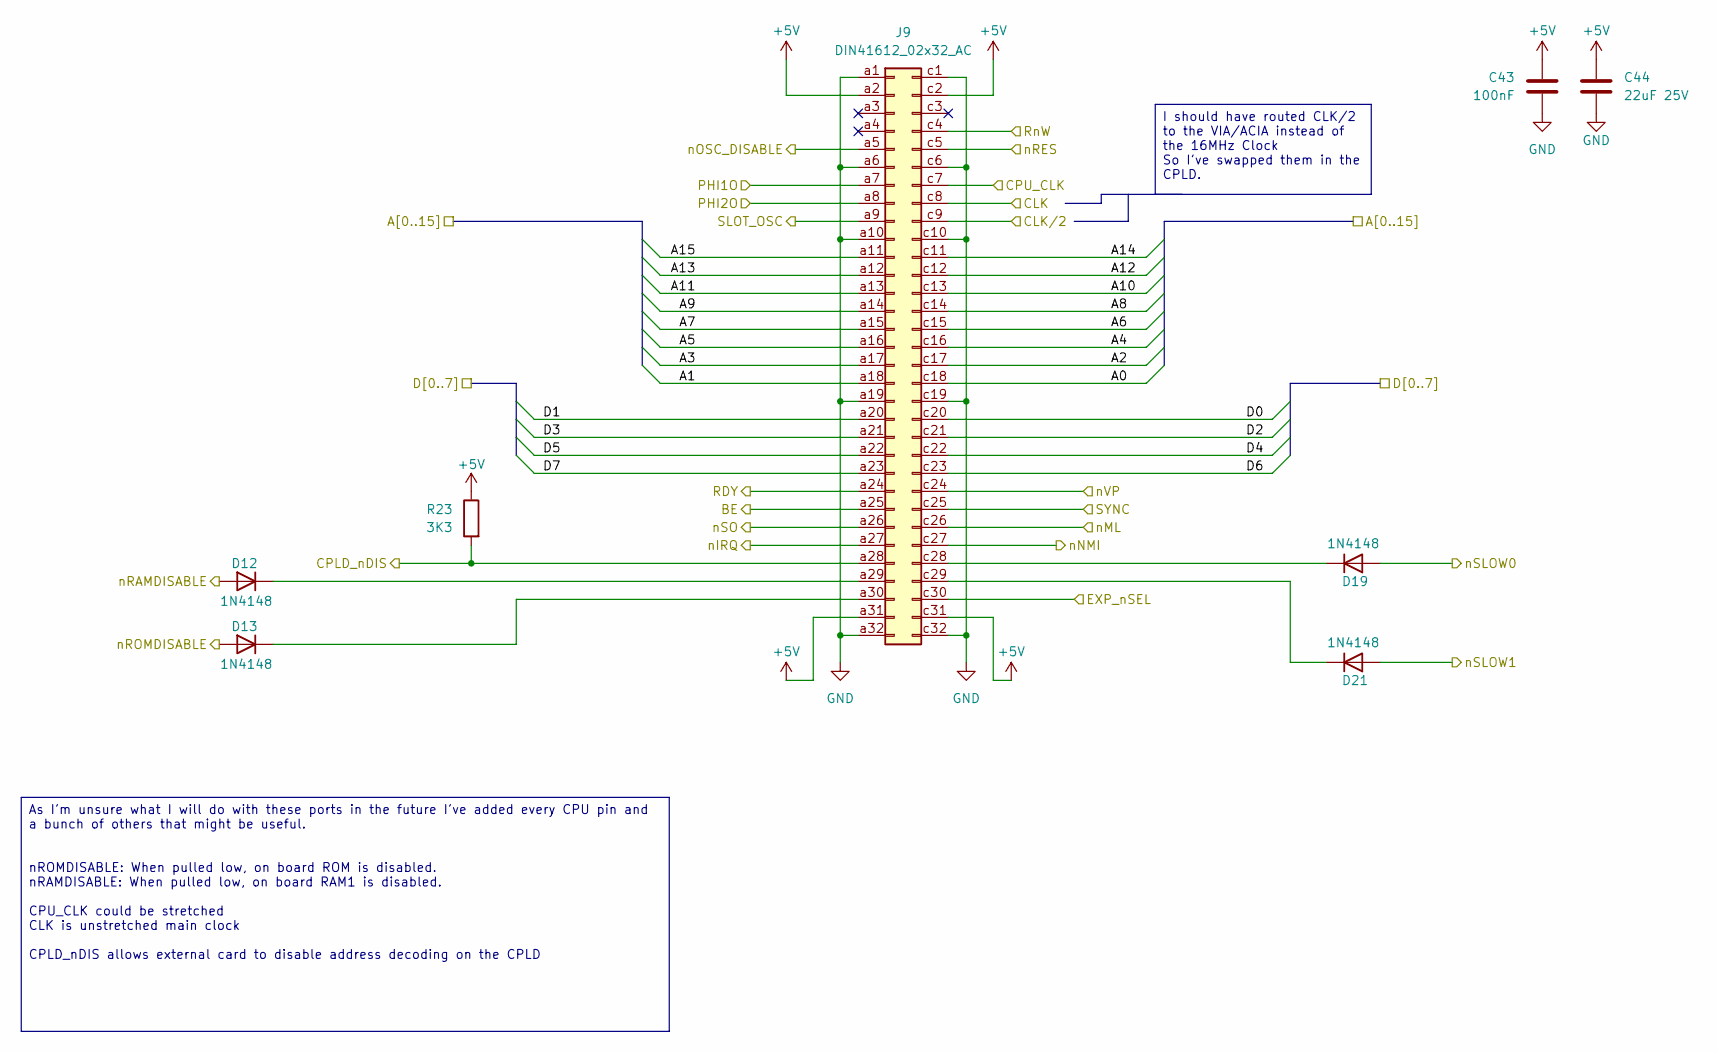
[picture p47: schematic Expansion.kicad_sch]

Parts:
C43: 100nF; C_0603_1608Metric; LCSC C113803
C44: 22uF 25V; C_0805_2012Metric; LCSC C45783
D12, D13, D19, D21: 1N4148; D_DO-35_SOD27_P7.62mm_Horizontal; LCSC DNF
J9: DIN41612_02x32_AC; DIN41612_R_2x32_Female_Horizontal_THT; Mouser Part Number 649-864648813H55V1LF
R23: 3K3; R_0402_1005Metric; LCSC C25890

Connections:
+5V: C43.1, C44.1, J9.a2, J9.a31, J9.c2, J9.c31, R23.1; also elsewhere on the board
/A0: J9.c18; also elsewhere on the board
/A1: J9.a18; also elsewhere on the board
/A2: J9.c17; also elsewhere on the board
/A3: J9.a17; also elsewhere on the board
/A4: J9.c16; also elsewhere on the board
/A5: J9.a16; also elsewhere on the board
/A6: J9.c15; also elsewhere on the board
/A7: J9.a15; also elsewhere on the board
/A8: J9.c14; also elsewhere on the board
/A9: J9.a14; also elsewhere on the board
/A10: J9.c13; also elsewhere on the board
/A11: J9.a13; also elsewhere on the board
/A12: J9.c12; also elsewhere on the board
/A13: J9.a12; also elsewhere on the board
/A14: J9.c11; also elsewhere on the board
/A15: J9.a11; also elsewhere on the board
/D0: J9.c20; also elsewhere on the board
/D1: J9.a20; also elsewhere on the board
/D2: J9.c21; also elsewhere on the board
/D3: J9.a21; also elsewhere on the board
/D4: J9.c22; also elsewhere on the board
/D5: J9.a22; also elsewhere on the board
/D6: J9.c23; also elsewhere on the board
/D7: J9.a23; also elsewhere on the board
/ExpansionSlot0/CPLD_nDIS: J9.a28, R23.2; also elsewhere on the board
BE: J9.a25; also elsewhere on the board
CLK: J9.c8; also elsewhere on the board
CLK/2: J9.c9; also elsewhere on the board
CPU_CLK: J9.c7; also elsewhere on the board
EXP_nSEL0: J9.c30; also elsewhere on the board
GND: C43.2, C44.2, J9.a1, J9.a6, J9.a10, J9.a19, J9.a32, J9.c1, J9.c6, J9.c10, J9.c19, J9.c32; also elsewhere on the board
unnamed: D12.1 (K), J9.a29
unnamed: D13.1 (K), J9.a30
unnamed: D19.1 (K), J9.c28
unnamed: D21.1 (K), J9.c29
PHI1O: J9.a7; also elsewhere on the board
PHI2O: J9.a8; also elsewhere on the board
RDY: J9.a24; also elsewhere on the board
RnW: J9.c4; also elsewhere on the board
SLOT_OSC: J9.a9; also elsewhere on the board
SYNQ: J9.c25; also elsewhere on the board
nIRQ: J9.a27; also elsewhere on the board
nML: J9.c26; also elsewhere on the board
nNMI: J9.c27; also elsewhere on the board
nOSC_DISABLE: J9.a5; also elsewhere on the board
nRAMDISABLE: D12.2 (A); also elsewhere on the board
nRES: J9.c5; also elsewhere on the board
nROMDISABLE: D13.2 (A); also elsewhere on the board
nSLOW0: D19.2 (A); also elsewhere on the board
nSLOW1: D21.2 (A); also elsewhere on the board
nSO: J9.a26; also elsewhere on the board
nVP: J9.c24; also elsewhere on the board

Notes on the sheet:
I should have routed CLK/2 to the VIA/ACIA instead of the 16MHz Clock So I've swapped them in the CPLD.
As I'm unsure what I will do with these ports in the future I've added every CPU pin and a bunch of others that might be useful. nROMDISABLE: When pulled low, on board ROM is disabled. nRAMDISABLE: When pulled low, on board RAM1 is disabled. CPU_CLK could be stretched CLK is unstretched main clock 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

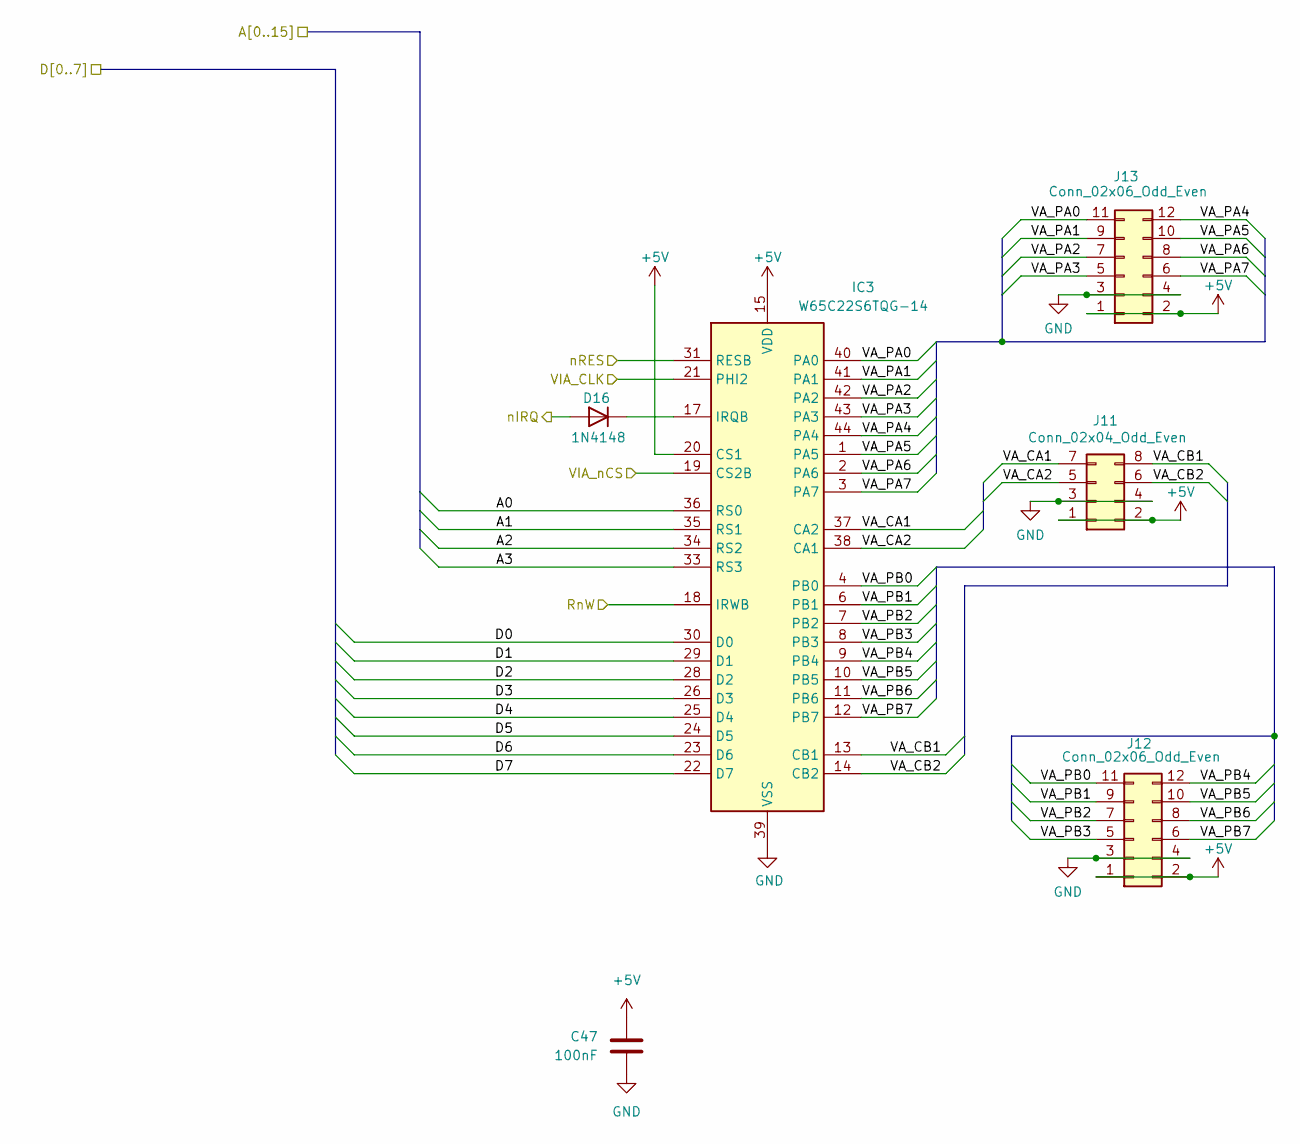
[picture p48: schematic VIA.kicad_sch]

Parts:
C47: 100nF; C_0603_1608Metric; LCSC C113803
D16: 1N4148; D_DO-35_SOD27_P7.62mm_Horizontal; LCSC DNF
IC3: W65C22S6TQG-14; QFP80P1320X1320X270-44N; Mouser Part Number 955-W65C22S6TQG-14
J11: Conn_02x04_Odd_Even; PinSocket_2x04_P2.54mm_Horizontal; LCSC DNF
J12, J13: Conn_02x06_Odd_Even; PinSocket_2x06_P2.54mm_Horizontal; LCSC DNF

Connections:
+5V: C47.1, IC3.15 (VDD), IC3.20 (CS1), J11.1, J11.2, J12.1, J12.2, J13.1, J13.2; also elsewhere on the board
/A0: IC3.36 (RS0); also elsewhere on the board
/A1: IC3.35 (RS1); also elsewhere on the board
/A2: IC3.34 (RS2); also elsewhere on the board
/A3: IC3.33 (RS3); also elsewhere on the board
/D0: IC3.30 (D0); also elsewhere on the board
/D1: IC3.29 (D1); also elsewhere on the board
/D2: IC3.28 (D2); also elsewhere on the board
/D3: IC3.26 (D3); also elsewhere on the board
/D4: IC3.25 (D4); also elsewhere on the board
/D5: IC3.24 (D5); also elsewhere on the board
/D6: IC3.23 (D6); also elsewhere on the board
/D7: IC3.22 (D7); also elsewhere on the board
/VIA/VA_CA1: IC3.37 (CA2), J11.7
/VIA/VA_CA2: IC3.38 (CA1), J11.5
/VIA/VA_CB1: IC3.13 (CB1), J11.8
/VIA/VA_CB2: IC3.14 (CB2), J11.6
/VIA/VA_PA0: IC3.40 (PA0), J13.11
/VIA/VA_PA1: IC3.41 (PA1), J13.9
/VIA/VA_PA2: IC3.42 (PA2), J13.7
/VIA/VA_PA3: IC3.43 (PA3), J13.5
/VIA/VA_PA4: IC3.44 (PA4), J13.12
/VIA/VA_PA5: IC3.1 (PA5), J13.10
/VIA/VA_PA6: IC3.2 (PA6), J13.8
/VIA/VA_PA7: IC3.3 (PA7), J13.6
/VIA/VA_PB0: IC3.4 (PB0), J12.11
/VIA/VA_PB1: IC3.6 (PB1), J12.9
/VIA/VA_PB2: IC3.7 (PB2), J12.7
/VIA/VA_PB3: IC3.8 (PB3), J12.5
/VIA/VA_PB4: IC3.9 (PB4), J12.12
/VIA/VA_PB5: IC3.10 (PB5), J12.10
/VIA/VA_PB6: IC3.11 (PB6), J12.8
/VIA/VA_PB7: IC3.12 (PB7), J12.6
CLK: IC3.21 (PHI2); also elsewhere on the board
GND: C47.2, IC3.39 (VSS), J11.3, J11.4, J12.3, J12.4, J13.3, J13.4; also elsewhere on the board
unnamed: D16.1 (K), IC3.17 (IRQB)
RnW: IC3.18 (IRWB); also elsewhere on the board
VIA_nCS: IC3.19 (CS2B); also elsewhere on the board
nIRQ: D16.2 (A); also elsewhere on the board
nRES: IC3.31 (RESB); also elsewhere on the board
