TechPaula/LT6502/Schematics/LT6502/LT6502.kicad_pcb

## KiCad design Schematics/LT6502/LT6502.kicad_pcb (continued)

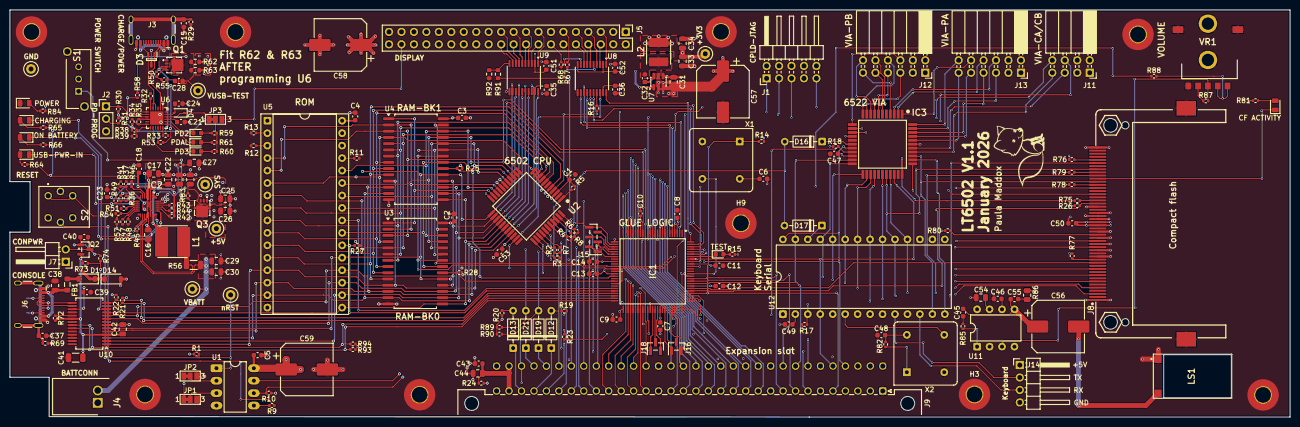
[picture p49: board LT6502.kicad_pcb from above]

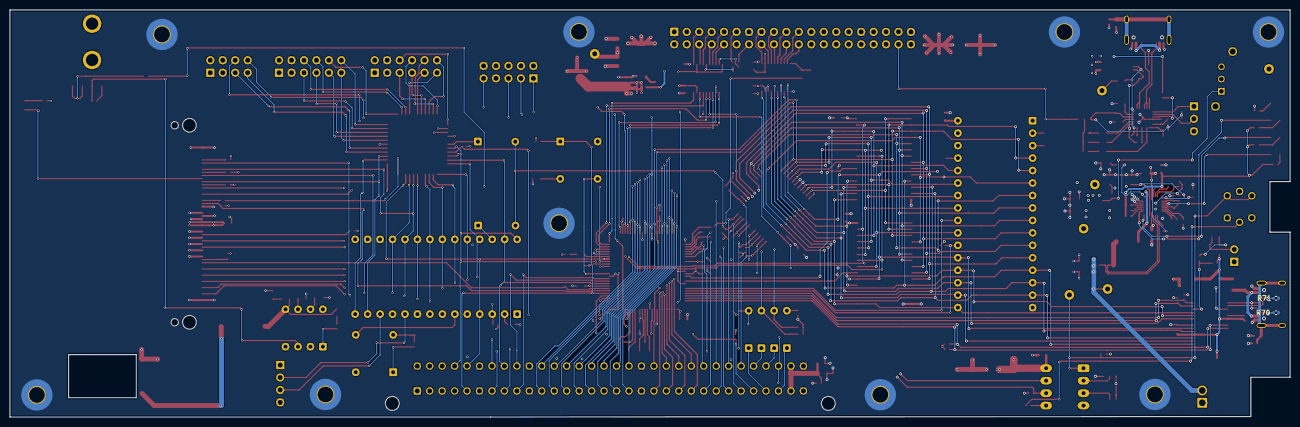
[picture p50: board LT6502.kicad_pcb from below]

Board: 4 copper layers, 261.0 x 83.0 mm, 235 parts (2 on the bottom side), 232 nets.
