TechPaula/LT6502/Schematics/EXP-TRANSPUTER/EXP-TRANSPUTER.kicad_pcb

## KiCad design Schematics/EXP-TRANSPUTER/EXP-TRANSPUTER.kicad_pcb (2026-01-18, last stored version)

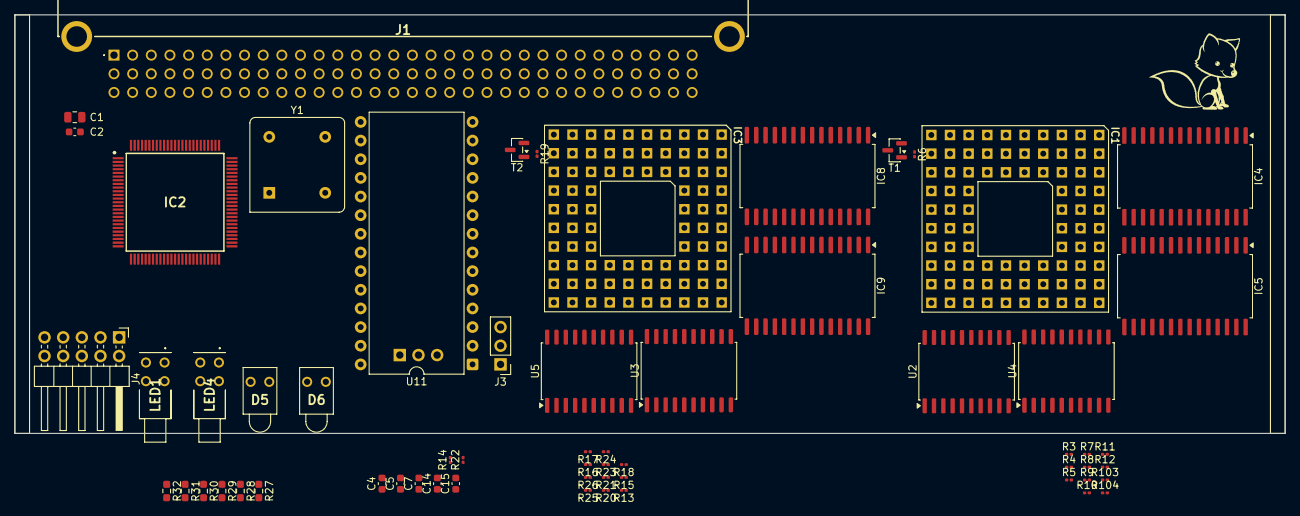
[picture p51: board EXP-TRANSPUTER.kicad_pcb from above]

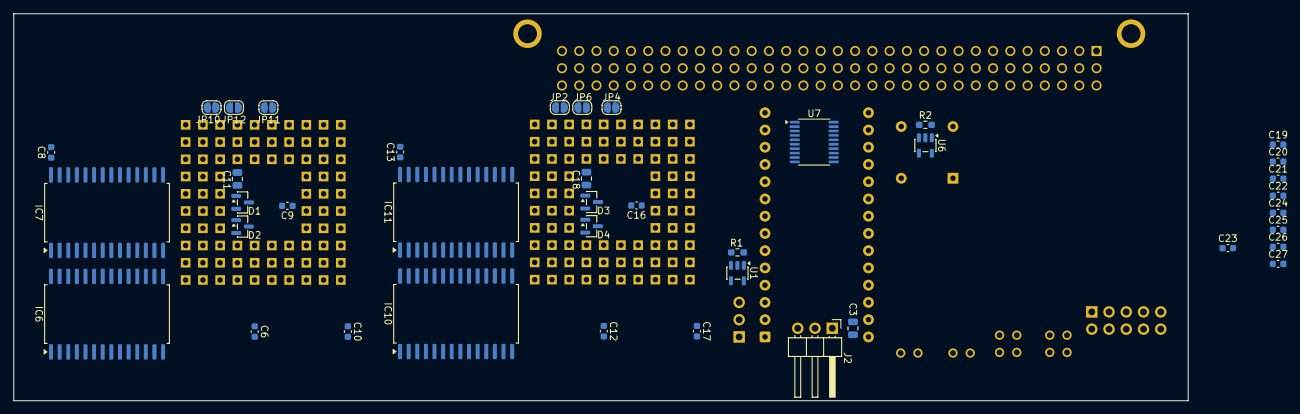
[picture p52: board EXP-TRANSPUTER.kicad_pcb from below]

Board: 2 copper layers, 173.0 x 57.0 mm, 102 parts (40 on the bottom side), 177 nets, no tracks yet.

Parts:
C1: 22uF 25V; C_0805_2012Metric
C2, C4, C5, C7, C14, C15, C19, C20, C21, C22, C23, C24, C25, C26, C27: 100nF; C_0603_1608Metric
C3: 1uF 10V; C_0805_2012Metric
C6, C8, C9, C10, C12, C13, C16, C17: 100n; C_0603_1608Metric
C11, C18: 1u; C_0805_2012Metric
D1, D2, D3, D4: BAV70; SOT-23
D5, D6: LED; LTL4221NHBP
FOX1: SYM_Flash_Large; Fox_avatar_18mm
IC1, IC3: IMST800; PGA84
IC2: ATF1508AS-7AX100; QFP50P1600X1600X120-100N
IC4, IC5, IC6, IC7, IC8, IC9, IC10, IC11: CY62256N; SOP-28_8.4x18.16mm_P1.27mm
J1: DIN41612_02x32_AC(CAPS); 86093967113745ELF
J2: Conn_01x03; PinHeader_1x03_P2.54mm_Horizontal
J3: Conn_01x03; PinHeader_1x03_P2.54mm_Vertical
J4: Conn_02x05_Odd_Even; PinHeader_2x05_P2.54mm_Horizontal
JP2, JP4, JP6, JP10, JP11, JP12: Jumper_2_Open; SolderJumper-2_P1.3mm_Open_RoundedPad1.0x1.5mm
LED1, LED4: LTL-42D1NMHDP1; LTL42D1NMHDP1
R1, R2: 10K; R_0603_1608Metric_Pad0.98x0.95mm_HandSolder
R3, R4, R5, R6, R7, R8, R13, R15, R16, R17, R18, R19, R20, R21, R103, R104: 10k; R_0201_0603Metric
R9, R10, R11, R12, R23, R24, R25, R26: 56; R_0201_0603Metric
R14: 10K; R_0201_0603Metric
R22: 3K3; R_0201_0603Metric
R27, R28, R29, R30, R31, R32: 470R; R_0603_1608Metric_Pad0.98x0.95mm_HandSolder
T1, T2: BC847; SOT-23
U1, U6: SN74LVC1G125DBV; SOT-23-5
U2, U3, U4, U5: 74HC373; SOIC-20W_7.5x12.8mm_P1.27mm
U7: SN74LV245APW; TSSOP-20_4.4x6.5mm_P0.65mm
U11: IMSC011; DIP-28_W15.24mm
Y1: CXO_DIP8; Oscillator_DIP-8

Connections:
5MHz_INT: U6.2, U11.15 (ClockIn), Y1.5 (OUT)
+5V: C1.1, C2.1, C3.1, C4.1, C5.1, C6.1, C7.1, C8.1, C9.1, C10.1, C12.1, C13.1, C14.1, C15.1, C16.1, C17.1, C19.1, C20.1, C21.1, C22.1, C23.1, C24.1, C25.1, C26.1, C27.1, D1.3 (C), D2.3 (C), D3.3 (C), D4.3 (C), IC1.A2 (LINKSPECIAL), IC1.C2 (VCC@0), IC1.C5 (VCC@1), IC1.E10 (VCC@2), IC1.H4 (VCC@3), IC3.A2 (LINKSPECIAL), IC3.C2 (VCC@0), IC3.C5 (VCC@1), IC3.E10 (VCC@2), IC3.H4 (VCC@3), IC4.28 (VCC), IC5.28 (VCC), IC6.28 (VCC), IC7.28 (VCC), IC8.28 (VCC), IC9.28 (VCC), IC10.28 (VCC), IC11.28 (VCC), J1.A2, J1.A31, J1.C2, J1.C31, J2.1, J4.4, R8.1, R16.1, R17.1, R21.1, R22.1, R29.1, R30.2, R31.1, R32.2, R103.1, R104.1, U1.5 (VCC), U2.20 (VCC), U3.20 (VCC), U4.20 (VCC), U5.20 (VCC), U6.5 (VCC), U7.20 (VCC), U11.28 (VCC), Y1.8 (Vcc)
/Connector/A0: J1.C18, U11.5 (RS0)
/Connector/A1: J1.A18, U11.6 (RS1)
/Connector/D0: J1.C20, U7.2 (A1)
/Connector/D1: J1.A20, U7.3 (A2)
/Connector/D2: J1.C21, U7.4 (A3)
/Connector/D3: J1.A21, U7.5 (A4)
/Connector/D4: J1.C22, U7.6 (A5)
/Connector/D5: J1.A22, U7.7 (A6)
/Connector/D6: J1.C23, U7.8 (A7)
/Connector/D7: J1.A23, U7.9 (A8)
/LinkAdapter/5MHz_OUT: IC1.B2 (CLKIN), IC3.B2 (CLKIN), U6.4
/LinkAdapter/LINKADAP_nCS: R22.2, U7.19 (~OE), U11.25 (notCS)
/LinkAdapter/SPEED_OUT: IC1.A4 (LINKSPEED123), IC1.B4 (LINKSPEED0), IC3.A4 (LINKSPEED123), IC3.B4 (LINKSPEED0), J2.2, U11.17 (LinkSpeed)
/TRAMOnBoard1/A2: IC8.10 (A0), IC9.10 (A0), IC10.10 (A0), IC11.10 (A0), U3.2 (O0)
/TRAMOnBoard1/A3: IC8.9 (A1), IC9.9 (A1), IC10.9 (A1), IC11.9 (A1), U3.12 (O4)
/TRAMOnBoard1/A4: IC8.8 (A2), IC9.8 (A2), IC10.8 (A2), IC11.8 (A2), U5.16 (O6)
/TRAMOnBoard1/A5: IC8.7 (A3), IC9.7 (A3), IC10.7 (A3), IC11.7 (A3), U3.6 (O2)
/TRAMOnBoard1/A6: IC8.6 (A4), IC9.6 (A4), IC10.6 (A4), IC11.6 (A4), U3.9 (O3)
/TRAMOnBoard1/A7: IC8.5 (A5), IC9.5 (A5), IC10.5 (A5), IC11.5 (A5), U3.19 (O7)
/TRAMOnBoard1/A8: IC8.4 (A6), IC9.4 (A6), IC10.4 (A6), IC11.4 (A6), U3.16 (O6)
/TRAMOnBoard1/A9: IC8.3 (A7), IC9.3 (A7), IC10.3 (A7), IC11.3 (A7), U3.15 (O5)
/TRAMOnBoard1/A10: IC8.25 (A8), IC9.25 (A8), IC10.25 (A8), IC11.25 (A8), U3.5 (O1)
/TRAMOnBoard1/A11: IC8.24 (A9), IC9.24 (A9), IC10.24 (A9), IC11.24 (A9), U5.15 (O5)
/TRAMOnBoard1/A12: IC8.21 (A10), IC9.21 (A10), IC10.21 (A10), IC11.21 (A10), U5.2 (O0)
/TRAMOnBoard1/A13: IC8.23 (A11), IC9.23 (A11), IC10.23 (A11), IC11.23 (A11), U5.5 (O1)
/TRAMOnBoard1/A14: IC8.2 (A12), IC9.2 (A12), IC10.2 (A12), IC11.2 (A12), U5.12 (O4)
/TRAMOnBoard1/A15: IC8.26 (A13), IC9.26 (A13), IC10.26 (A13), IC11.26 (A13), U5.6 (O2)
/TRAMOnBoard1/A16: IC8.1 (A14), IC9.1 (A14), IC10.1 (A14), IC11.1 (A14), U5.9 (O3)
/TRAMOnBoard1/AD0: IC3.G8 (NOTMEMWRD0), IC8.17 (I/O5)
/TRAMOnBoard1/AD1: IC3.H10 (NOTMEMRFD1), IC8.13 (I/O2)
/TRAMOnBoard1/AD2: IC3.J10 (MEMAD2), IC8.12 (I/O1), U3.3 (D0)
/TRAMOnBoard1/AD3: IC3.H9 (MEMAD3), IC8.18 (I/O6), U3.13 (D4)
/TRAMOnBoard1/AD4: IC3.H8 (MEMAD4), IC8.15 (I/O3), U5.17 (D6)
/TRAMOnBoard1/AD5: IC3.J9 (MEMAD5), IC8.19 (I/O7), U3.7 (D2)
/TRAMOnBoard1/AD6: IC3.J8 (MEMAD6), IC8.16 (I/O4), U3.8 (D3)
/TRAMOnBoard1/AD7: IC3.K10 (MEMAD7), IC8.11 (I/O0), U3.18 (D7)
/TRAMOnBoard1/AD8: IC3.C8 (MEMCONFIG), IC3.H7 (MEMAD8), IC9.11 (I/O0), U3.17 (D6)
/TRAMOnBoard1/AD9: IC3.K9 (MEMAD9), IC9.13 (I/O2), U3.14 (D5)
/TRAMOnBoard1/AD10: IC3.K8 (MEMAD10), IC9.12 (I/O1), U3.4 (D1)
/TRAMOnBoard1/AD11: IC3.K7 (MEMAD11), IC9.15 (I/O3), U5.14 (D5)
/TRAMOnBoard1/AD12: IC3.H6 (MEMAD12), IC9.16 (I/O4), U5.3 (D0)
/TRAMOnBoard1/AD13: IC3.J6 (MEMAD13), IC9.17 (I/O5), U5.4 (D1)
/TRAMOnBoard1/AD14: IC3.K6 (MEMAD14), IC9.18 (I/O6), U5.13 (D4)
/TRAMOnBoard1/AD15: IC3.K5 (MEMAD15), IC9.19 (I/O7), U5.7 (D2)
/TRAMOnBoard1/AD16: IC3.H5 (MEMAD16), IC10.12 (I/O1), U5.8 (D3)
/TRAMOnBoard1/AD17: IC3.J5 (MEMAD17), IC10.11 (I/O0)
/TRAMOnBoard1/AD18: IC3.K4 (MEMAD18), IC10.13 (I/O2)
/TRAMOnBoard1/AD19: IC3.J4 (MEMAD19), IC10.19 (I/O7)
/TRAMOnBoard1/AD20: IC3.K3 (MEMAD20), IC10.16 (I/O4)
/TRAMOnBoard1/AD21: IC3.K2 (MEMAD21), IC10.15 (I/O3)
/TRAMOnBoard1/AD22: IC3.J3 (MEMAD22), IC10.17 (I/O5)
/TRAMOnBoard1/AD23: IC3.H3 (MEMAD23), IC10.18 (I/O6)
/TRAMOnBoard1/AD24: IC3.J2 (MEMAD24), IC11.11 (I/O0)
/TRAMOnBoard1/AD25: IC3.H2 (MEMAD25), IC11.12 (I/O1)
/TRAMOnBoard1/AD26: IC3.K1 (MEMAD26), IC11.15 (I/O3)
/TRAMOnBoard1/AD27: IC3.G3 (MEMAD27), IC11.13 (I/O2)
/TRAMOnBoard1/AD28: IC3.J1 (MEMAD28), IC11.16 (I/O4)
/TRAMOnBoard1/AD29: IC3.H1 (MEMAD29), IC11.17 (I/O5)
/TRAMOnBoard1/AD30: IC3.G1 (MEMAD30), IC11.18 (I/O6)
/TRAMOnBoard1/AD31: IC3.F3 (MEMAD31), IC11.19 (I/O7)
/TRAMOnBoard1/E: IC3.E9 (NOTMEMS0), IC8.20 (~CS), IC9.20 (~CS), IC10.20 (~CS), IC11.20 (~CS)
/TRAMOnBoard1/LINK1_IN: D4.1 (A1), IC3.C6 (LINKIN1), R15.2
/TRAMOnBoard1/LINK2_IN: D4.2 (A2), IC3.A7 (LINKIN2), R20.2
/TRAMOnBoard1/LINK3_IN: D3.2 (A2), IC3.C7 (LINKIN3), R18.2
/TRAMOnBoard1/RD: IC3.E8 (NOTMEMRD), IC8.22 (~OE), IC9.22 (~OE), IC10.22 (~OE), IC11.22 (~OE)
/TRAMOnBoard1/WR0: IC3.D10 (NOTMEMWRB0), IC8.27 (~WE)
/TRAMOnBoard1/WR1: IC3.C10 (NOTMEMWRB1), IC9.27 (~WE)
/TRAMOnBoard1/WR2: IC3.D9 (NOTMEMWRB2), IC10.27 (~WE)
/TRAMOnBoard1/WR3: IC3.B10 (NOTMEMWRB3), IC11.27 (~WE)
/TRAMOnBoard/A2: IC4.10 (A0), IC5.10 (A0), IC6.10 (A0), IC7.10 (A0), U4.2 (O0)
/TRAMOnBoard/A3: IC4.9 (A1), IC5.9 (A1), IC6.9 (A1), IC7.9 (A1), U4.12 (O4)
/TRAMOnBoard/A4: IC4.8 (A2), IC5.8 (A2), IC6.8 (A2), IC7.8 (A2), U2.16 (O6)
/TRAMOnBoard/A5: IC4.7 (A3), IC5.7 (A3), IC6.7 (A3), IC7.7 (A3), U4.6 (O2)
/TRAMOnBoard/A6: IC4.6 (A4), IC5.6 (A4), IC6.6 (A4), IC7.6 (A4), U4.9 (O3)
/TRAMOnBoard/A7: IC4.5 (A5), IC5.5 (A5), IC6.5 (A5), IC7.5 (A5), U4.19 (O7)
/TRAMOnBoard/A8: IC4.4 (A6), IC5.4 (A6), IC6.4 (A6), IC7.4 (A6), U4.16 (O6)
/TRAMOnBoard/A9: IC4.3 (A7), IC5.3 (A7), IC6.3 (A7), IC7.3 (A7), U4.15 (O5)
/TRAMOnBoard/A10: IC4.25 (A8), IC5.25 (A8), IC6.25 (A8), IC7.25 (A8), U4.5 (O1)
/TRAMOnBoard/A11: IC4.24 (A9), IC5.24 (A9), IC6.24 (A9), IC7.24 (A9), U2.15 (O5)
/TRAMOnBoard/A12: IC4.21 (A10), IC5.21 (A10), IC6.21 (A10), IC7.21 (A10), U2.2 (O0)
/TRAMOnBoard/A13: IC4.23 (A11), IC5.23 (A11), IC6.23 (A11), IC7.23 (A11), U2.5 (O1)
/TRAMOnBoard/A14: IC4.2 (A12), IC5.2 (A12), IC6.2 (A12), IC7.2 (A12), U2.12 (O4)
/TRAMOnBoard/A15: IC4.26 (A13), IC5.26 (A13), IC6.26 (A13), IC7.26 (A13), U2.6 (O2)
/TRAMOnBoard/A16: IC4.1 (A14), IC5.1 (A14), IC6.1 (A14), IC7.1 (A14), U2.9 (O3)
/TRAMOnBoard/AD0: IC1.G8 (NOTMEMWRD0), IC4.17 (I/O5)
/TRAMOnBoard/AD1: IC1.H10 (NOTMEMRFD1), IC4.13 (I/O2)
/TRAMOnBoard/AD2: IC1.J10 (MEMAD2), IC4.12 (I/O1), U4.3 (D0)
/TRAMOnBoard/AD3: IC1.H9 (MEMAD3), IC4.18 (I/O6), U4.13 (D4)
/TRAMOnBoard/AD4: IC1.H8 (MEMAD4), IC4.15 (I/O3), U2.17 (D6)
/TRAMOnBoard/AD5: IC1.J9 (MEMAD5), IC4.19 (I/O7), U4.7 (D2)
/TRAMOnBoard/AD6: IC1.J8 (MEMAD6), IC4.16 (I/O4), U4.8 (D3)
/TRAMOnBoard/AD7: IC1.K10 (MEMAD7), IC4.11 (I/O0), U4.18 (D7)
/TRAMOnBoard/AD8: IC1.C8 (MEMCONFIG), IC1.H7 (MEMAD8), IC5.11 (I/O0), U4.17 (D6)
/TRAMOnBoard/AD9: IC1.K9 (MEMAD9), IC5.13 (I/O2), U4.14 (D5)
/TRAMOnBoard/AD10: IC1.K8 (MEMAD10), IC5.12 (I/O1), U4.4 (D1)
/TRAMOnBoard/AD11: IC1.K7 (MEMAD11), IC5.15 (I/O3), U2.14 (D5)
/TRAMOnBoard/AD12: IC1.H6 (MEMAD12), IC5.16 (I/O4), U2.3 (D0)
/TRAMOnBoard/AD13: IC1.J6 (MEMAD13), IC5.17 (I/O5), U2.4 (D1)
/TRAMOnBoard/AD14: IC1.K6 (MEMAD14), IC5.18 (I/O6), U2.13 (D4)
/TRAMOnBoard/AD15: IC1.K5 (MEMAD15), IC5.19 (I/O7), U2.7 (D2)
/TRAMOnBoard/AD16: IC1.H5 (MEMAD16), IC6.12 (I/O1), U2.8 (D3)
/TRAMOnBoard/AD17: IC1.J5 (MEMAD17), IC6.11 (I/O0)
/TRAMOnBoard/AD18: IC1.K4 (MEMAD18), IC6.13 (I/O2)
/TRAMOnBoard/AD19: IC1.J4 (MEMAD19), IC6.19 (I/O7)
/TRAMOnBoard/AD20: IC1.K3 (MEMAD20), IC6.16 (I/O4)
/TRAMOnBoard/AD21: IC1.K2 (MEMAD21), IC6.15 (I/O3)
/TRAMOnBoard/AD22: IC1.J3 (MEMAD22), IC6.17 (I/O5)
/TRAMOnBoard/AD23: IC1.H3 (MEMAD23), IC6.18 (I/O6)
/TRAMOnBoard/AD24: IC1.J2 (MEMAD24), IC7.11 (I/O0)
/TRAMOnBoard/AD25: IC1.H2 (MEMAD25), IC7.12 (I/O1)
/TRAMOnBoard/AD26: IC1.K1 (MEMAD26), IC7.15 (I/O3)
/TRAMOnBoard/AD27: IC1.G3 (MEMAD27), IC7.13 (I/O2)
/TRAMOnBoard/AD28: IC1.J1 (MEMAD28), IC7.16 (I/O4)
/TRAMOnBoard/AD29: IC1.H1 (MEMAD29), IC7.17 (I/O5)
/TRAMOnBoard/AD30: IC1.G1 (MEMAD30), IC7.18 (I/O6)
/TRAMOnBoard/AD31: IC1.F3 (MEMAD31), IC7.19 (I/O7)
/TRAMOnBoard/E: IC1.E9 (NOTMEMS0), IC4.20 (~CS), IC5.20 (~CS), IC6.20 (~CS), IC7.20 (~CS)
/TRAMOnBoard/LINK2_IN: D2.2 (A2), IC1.A7 (LINKIN2), R7.2
/TRAMOnBoard/LINK3_IN: D1.2 (A2), IC1.C7 (LINKIN3), R5.2
/TRAMOnBoard/RD: IC1.E8 (NOTMEMRD), IC4.22 (~OE), IC5.22 (~OE), IC6.22 (~OE), IC7.22 (~OE)
/TRAMOnBoard/WR0: IC1.D10 (NOTMEMWRB0), IC4.27 (~WE)
/TRAMOnBoard/WR1: IC1.C10 (NOTMEMWRB1), IC5.27 (~WE)
/TRAMOnBoard/WR2: IC1.D9 (NOTMEMWRB2), IC6.27 (~WE)
/TRAMOnBoard/WR3: IC1.B10 (NOTMEMWRB3), IC7.27 (~WE)
GND: C1.2, C2.2, C4.2, C5.2, C6.2, C7.2, C8.2, C9.2, C10.2, C12.2, C13.2, C14.2, C15.2, C16.2, C17.2, C19.2, C20.2, C21.2, C22.2, C23.2, C24.2, C25.2, C26.2, C27.2, IC1.A9 (GND@0), IC1.A10 (MEMWAIT), IC1.B8 (EVENTREQ), IC1.B9 (MEMREQ), IC1.C1 (GND@1), IC1.D3 (ERRIN), IC1.E1 (DISABLEINTRAM), IC1.E2 (BOOTFROMROM), IC1.G2 (GND@2), IC1.G9 (GND@3), IC1.J7 (GND@4), IC3.A9 (GND@0), IC3.A10 (MEMWAIT), IC3.B8 (EVENTREQ), IC3.B9 (MEMREQ), IC3.C1 (GND@1), IC3.D3 (ERRIN), IC3.E1 (DISABLEINTRAM), IC3.E2 (BOOTFROMROM), IC3.G2 (GND@2), IC3.G9 (GND@3), IC3.J7 (GND@4), IC4.14 (VSS), IC5.14 (VSS), IC6.14 (VSS), IC7.14 (VSS), IC8.14 (VSS), IC9.14 (VSS), IC10.14 (VSS), IC11.14 (VSS), J1.A1, J1.A6, J1.A10, J1.A19, J1.A32, J1.C1, J1.C6, J1.C10, J1.C19, J1.C32, J2.3, J3.1, J4.2, J4.10, JP2.2 (B), JP4.2 (B), JP6.2 (B), JP10.2 (B), JP11.2 (B), JP12.2 (B), R1.2, R2.2, R3.1, R4.1, R5.1, R7.1, R13.1, R14.2, R15.1, R18.1, R20.1, T1.2 (E), T2.2 (E), U1.3 (GND), U2.1 (OE), U2.10 (GND), U2.18 (D7), U3.1 (OE), U3.10 (GND), U4.1 (OE), U4.10 (GND), U5.1 (OE), U5.10 (GND), U5.18 (D7), U6.3 (GND), U7.10 (GND), U11.11 (HoldToGND), U11.14 (GND), U11.16 (SeparateIQ), Y1.4 (GND)
LA_LINK_IN: J3.2, R9.2, R14.1, U11.2 (LinkIn)
LA_LINK_OUT: D1.1 (A1), IC1.A5 (LINKIN0), J3.3, R3.2, U1.4
LA_TRAM0_IN: D2.1 (A1), IC1.C6 (LINKIN1), R4.2, R23.2
LA_TRAM0_OUT: D3.1 (A1), IC3.A5 (LINKIN0), R10.2, R13.2
unnamed: D5.2 (A), R27.1
unnamed: D6.2 (A), R28.1
unnamed: C11.1, IC1.C4 (CAP+)
unnamed: C11.2, IC1.C3 (CAP-)
unnamed: IC1.D1 (ERROUT), R6.1
unnamed: IC1.B5 (LINKOUT0), R9.1
unnamed: IC1.A6 (LINKOUT1), R10.1
unnamed: IC1.B6 (LINKOUT2), R11.1
unnamed: IC1.B7 (LINKOUT3), R12.1
unnamed: IC1.G10 (NOTMEMS1), U2.11 (LE), U4.11 (LE)
unnamed: IC1.B1 (PROCSPEED0), JP10.1 (A), R103.2
unnamed: IC1.F1 (PROCSPEED1), JP11.1 (A), R104.2
unnamed: IC1.D2 (PROCSPEED2), JP12.1 (A), R8.2
unnamed: C18.1, IC3.C4 (CAP+)
unnamed: C18.2, IC3.C3 (CAP-)
unnamed: IC3.D1 (ERROUT), R19.1
unnamed: IC3.B5 (LINKOUT0), R23.1
unnamed: IC3.A6 (LINKOUT1), R24.1
unnamed: IC3.B6 (LINKOUT2), R25.1
unnamed: IC3.B7 (LINKOUT3), R26.1
unnamed: IC3.G10 (NOTMEMS1), U3.11 (LE), U5.11 (LE)
unnamed: IC3.B1 (PROCSPEED0), JP2.1 (A), R16.2
unnamed: IC3.F1 (PROCSPEED1), JP4.1 (A), R17.2
unnamed: IC3.D2 (PROCSPEED2), JP6.1 (A), R21.2
unnamed: LED1.2 (A_1), R32.1
unnamed: LED1.4 (A_2), R31.2
unnamed: LED4.2 (A_1), R30.1
unnamed: LED4.4 (A_2), R29.2
unnamed: R1.1, U1.1
unnamed: R2.1, U6.1
unnamed: R27.2, R28.2
unnamed: R6.2, T1.1 (B)
unnamed: R19.2, T2.1 (B)
unnamed: C3.2, U11.27 (CapMinus)
unnamed: U7.18 (B1), U11.24 (D0)
unnamed: U7.17 (B2), U11.23 (D1)
unnamed: U7.16 (B3), U11.22 (D2)
unnamed: U7.15 (B4), U11.8 (D3)
unnamed: U7.14 (B5), U11.20 (D4)
unnamed: U7.13 (B6), U11.10 (D5)
unnamed: U7.12 (B7), U11.18 (D6)
unnamed: U7.11 (B8), U11.12 (D7)
unnamed: U1.2, U11.1 (LinkOut)
TRAM_nANALYSE: D6.1 (K), IC1.F2 (ANALYSE), IC3.F2 (ANALYSE)
TRAM_nERROR: D5.1 (K), T1.3 (C), T2.3 (C)
TRAM_nRESET: IC1.E3 (RESET), IC3.E3 (RESET)
