TechPaula/LT6502/Schematics/Expansion-Template/Expansion-Template.kicad_pcb

## KiCad design Schematics/Expansion-Template/Expansion-Template.kicad_pcb (2026-01-05, last stored version)

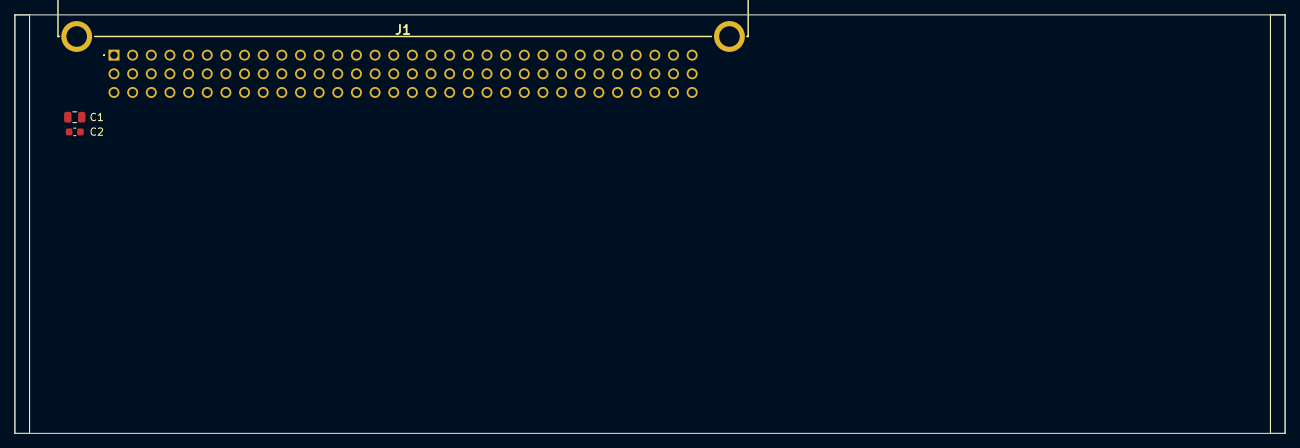
[picture p53: board Expansion-Template.kicad_pcb from above]

Board: 2 copper layers, 173.0 x 57.0 mm, 3 parts (0 on the bottom side), 2 nets, no tracks yet.

Parts:
C1: 22uF 25V; C_0805_2012Metric
C2: 100nF; C_0603_1608Metric
J1: DIN41612_02x32_AC(CAPS); 86093967113745ELF

Connections:
+5V: C1.1, C2.1, J1.A2, J1.A31, J1.C2, J1.C31
GND: C1.2, C2.2, J1.A1, J1.A6, J1.A10, J1.A19, J1.A32, J1.C1, J1.C6, J1.C10, J1.C19, J1.C32
