TechPaula/LT6502/Schematics/Keybed/LT6502_KEYBED.kicad_pcb

## KiCad design Schematics/Keybed/LT6502_KEYBED.kicad_pcb (2025-12-20, last stored version)

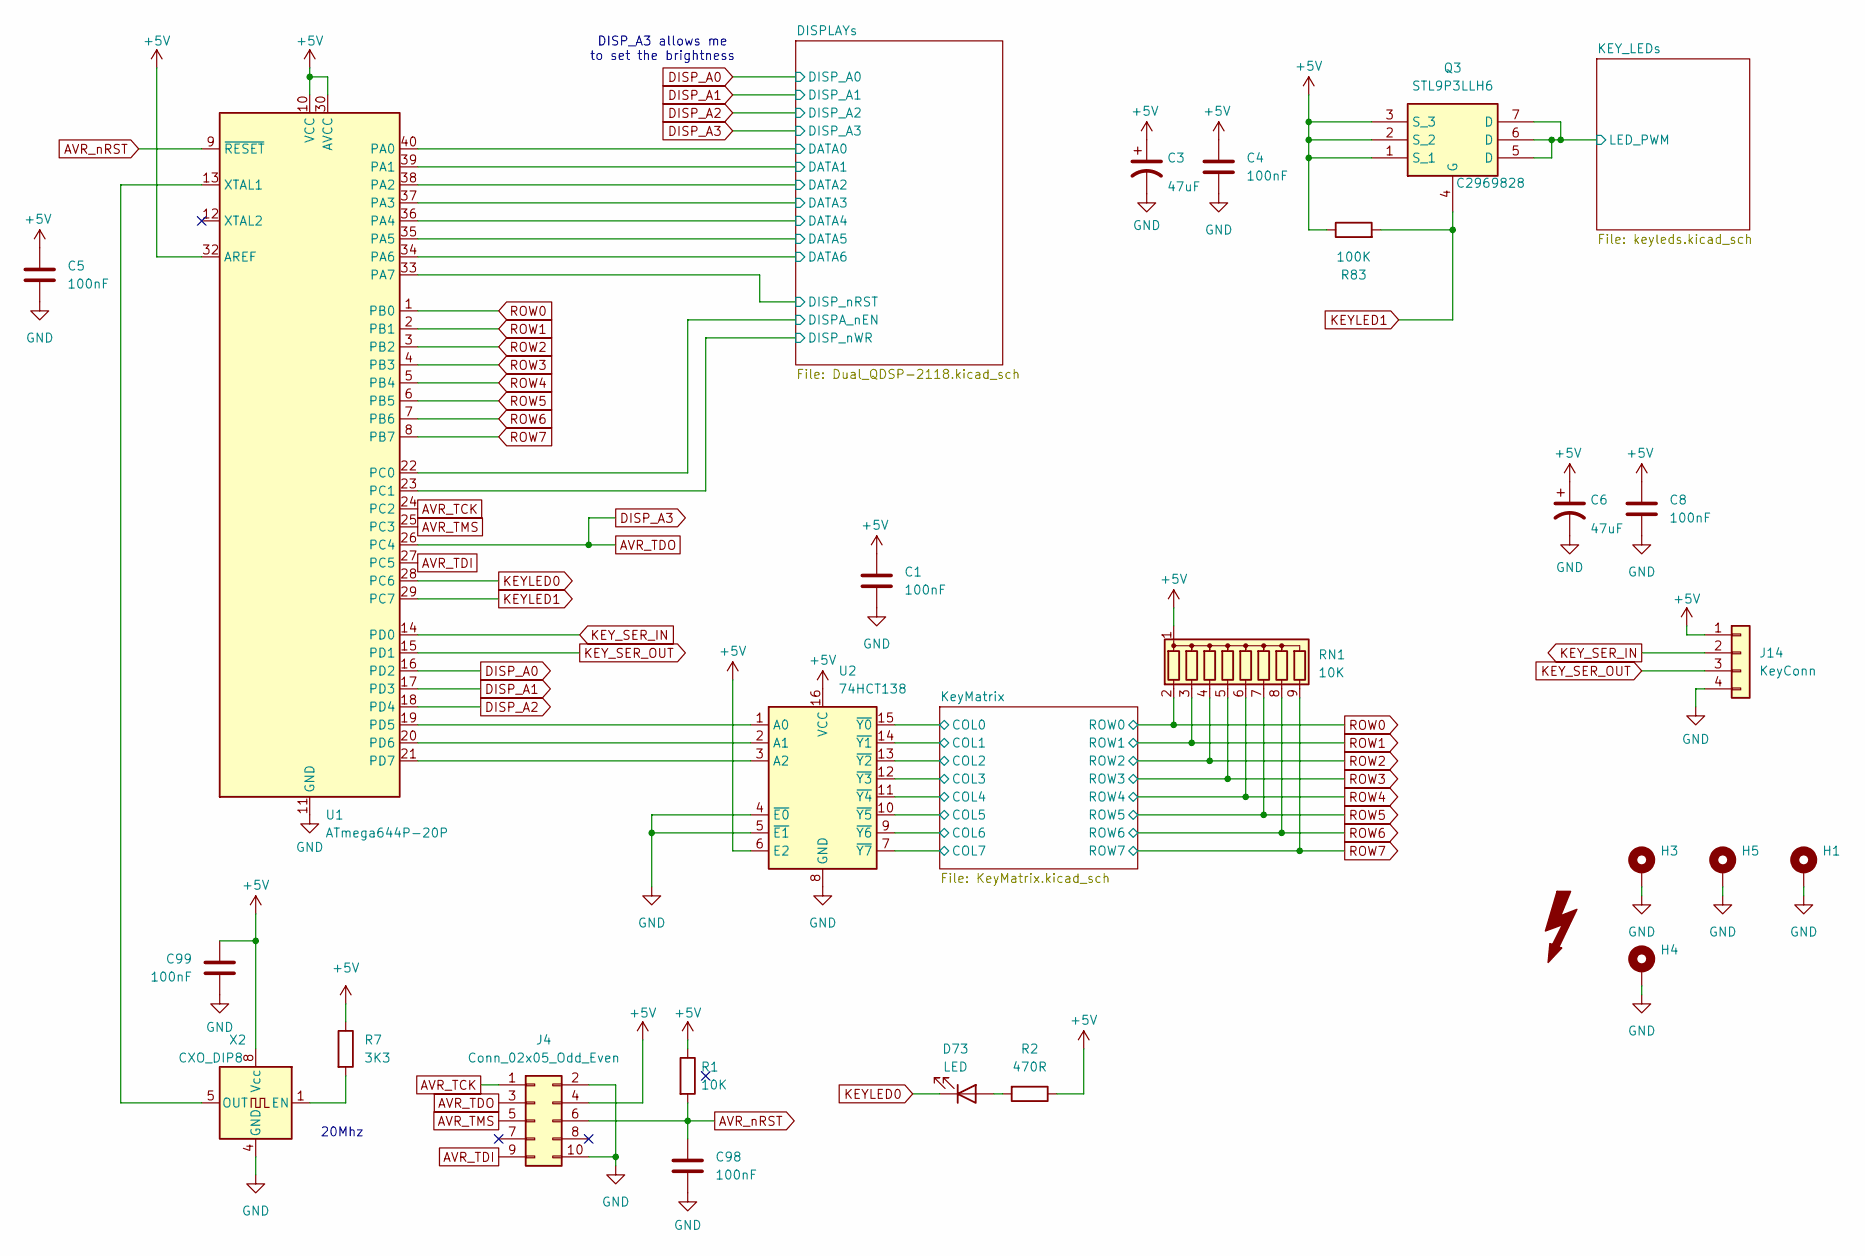
[picture p54: schematic LT6502_KEYBED.kicad_sch]

Parts:
C1, C4, C5, C8, C98, C99: 100nF; C_0805_2012Metric; LCSC C49678
C3, C6: 47uF; C_1206_3216Metric; LCSC C96123
D73: LED; LED_D5.0mm; LCSC DNF
FOX1: SYM_Flash_Large; Fox_avatar_18mm; LCSC DNF
H1, H3, H4, H5: MountingHole_Pad; MountingHole_3.2mm_M3_Pad_TopBottom; LCSC DNF
J4: Conn_02x05_Odd_Even; PinHeader_2x05_P2.54mm_Horizontal; LCSC DNF
J14: KeyConn; PinHeader_1x04_P2.54mm_Horizontal; LCSC DNF
Q3: STL9P3LLH6; STL20N6F7; Manufacturer_Part_Number STL9P3LLH6; Mouser Part Number 511-STL9P3LLH6
R1: 10K; R_0603_1608Metric_Pad0.98x0.95mm_HandSolder; LCSC DNF
R2: 470R; R_0603_1608Metric_Pad0.98x0.95mm_HandSolder; LCSC DNF
R7: 3K3; R_0603_1608Metric_Pad0.98x0.95mm_HandSolder; LCSC DNF
R83: 100K; R_0402_1005Metric; LCSC DNF
RN1: 10K; R_Array_SIP9; LCSC DNF
U1: ATmega644P-20P; DIP-40_W15.24mm; LCSC DNF
U2: 74HCT138; SSOP-16_5.3x6.2mm_P0.65mm; LCSC C8115
X2: CXO_DIP8; Oscillator_DIP-8; LCSC DNF

Connections:
+5V: C1.1, C3.1, C4.1, C5.1, C6.1, C8.1, C99.1, J4.4, J14.1, Q3.1 (S_1), Q3.2 (S_2), Q3.3 (S_3), R1.1, R2.1, R7.1, R83.1, RN1.1 (common), U1.10 (VCC), U1.30 (AVCC), U1.32 (AREF), U2.6 (E2), U2.16 (VCC), X2.8 (Vcc); also elsewhere on the board
/DISPLAYs/DATA0: U1.40 (PA0); also elsewhere on the board
/DISPLAYs/DATA1: U1.39 (PA1); also elsewhere on the board
/DISPLAYs/DATA2: U1.38 (PA2); also elsewhere on the board
/DISPLAYs/DATA3: U1.37 (PA3); also elsewhere on the board
/DISPLAYs/DATA4: U1.36 (PA4); also elsewhere on the board
/DISPLAYs/DATA5: U1.35 (PA5); also elsewhere on the board
/DISPLAYs/DATA6: U1.34 (PA6); also elsewhere on the board
/DISPLAYs/DISPA_nEN: U1.22 (PC0); also elsewhere on the board
/DISPLAYs/DISP_nRST: U1.33 (PA7); also elsewhere on the board
/DISPLAYs/DISP_nWR: U1.23 (PC1); also elsewhere on the board
/KEY_LEDs/LED_PWM: Q3.5 (D), Q3.6 (D), Q3.7 (D); also elsewhere on the board
/KeyMatrix/COL0: U2.15 (~Y0); also elsewhere on the board
/KeyMatrix/COL1: U2.14 (~Y1); also elsewhere on the board
/KeyMatrix/COL2: U2.13 (~Y2); also elsewhere on the board
/KeyMatrix/COL3: U2.12 (~Y3); also elsewhere on the board
/KeyMatrix/COL4: U2.11 (~Y4); also elsewhere on the board
/KeyMatrix/COL5: U2.10 (~Y5); also elsewhere on the board
/KeyMatrix/COL6: U2.9 (~Y6); also elsewhere on the board
/KeyMatrix/COL7: U2.7 (~Y7); also elsewhere on the board
AVR_TCK: J4.1, U1.24 (PC2)
AVR_TDI: J4.9, U1.27 (PC5)
AVR_TDO: J4.3, U1.26 (PC4); also elsewhere on the board
AVR_TMS: J4.5, U1.25 (PC3)
AVR_nRST: C98.1, J4.6, R1.2, U1.9 (~RESET)
DISP_A0: U1.16 (PD2); also elsewhere on the board
DISP_A1: U1.17 (PD3); also elsewhere on the board
DISP_A2: U1.18 (PD4); also elsewhere on the board
GND: C1.2, C3.2, C4.2, C5.2, C6.2, C8.2, C98.2, C99.2, H1.1, H3.1, H4.1, H5.1, J4.2, J4.10, J14.4, U1.11 (GND), U1.31 (GND), U2.4 (~E0), U2.5 (~E1), U2.8 (GND), X2.4 (GND); also elsewhere on the board
KEYLED0: D73.1 (K), U1.28 (PC6)
KEYLED1: Q3.4 (G), R83.2, U1.29 (PC7)
KEY_SER_IN: J14.2, U1.14 (PD0)
KEY_SER_OUT: J14.3, U1.15 (PD1)
unnamed: D73.2 (A), R2.2
unnamed: U1.19 (PD5), U2.1 (A0)
unnamed: U1.20 (PD6), U2.2 (A1)
unnamed: U1.21 (PD7), U2.3 (A2)
unnamed: U1.13 (XTAL1), X2.5 (OUT)
unnamed: R7.2, X2.1 (EN)
ROW0: RN1.2 (R1), U1.1 (PB0); also elsewhere on the board
ROW1: RN1.3 (R2), U1.2 (PB1); also elsewhere on the board
ROW2: RN1.4 (R3), U1.3 (PB2); also elsewhere on the board
ROW3: RN1.5 (R4), U1.4 (PB3); also elsewhere on the board
ROW4: RN1.6 (R5), U1.5 (PB4); also elsewhere on the board
ROW5: RN1.7 (R6), U1.6 (PB5); also elsewhere on the board
ROW6: RN1.8 (R7), U1.7 (PB6); also elsewhere on the board
ROW7: RN1.9 (R8), U1.8 (PB7); also elsewhere on the board

Notes on the sheet:
20Mhz
DISP_A3 allows me to set the brightness

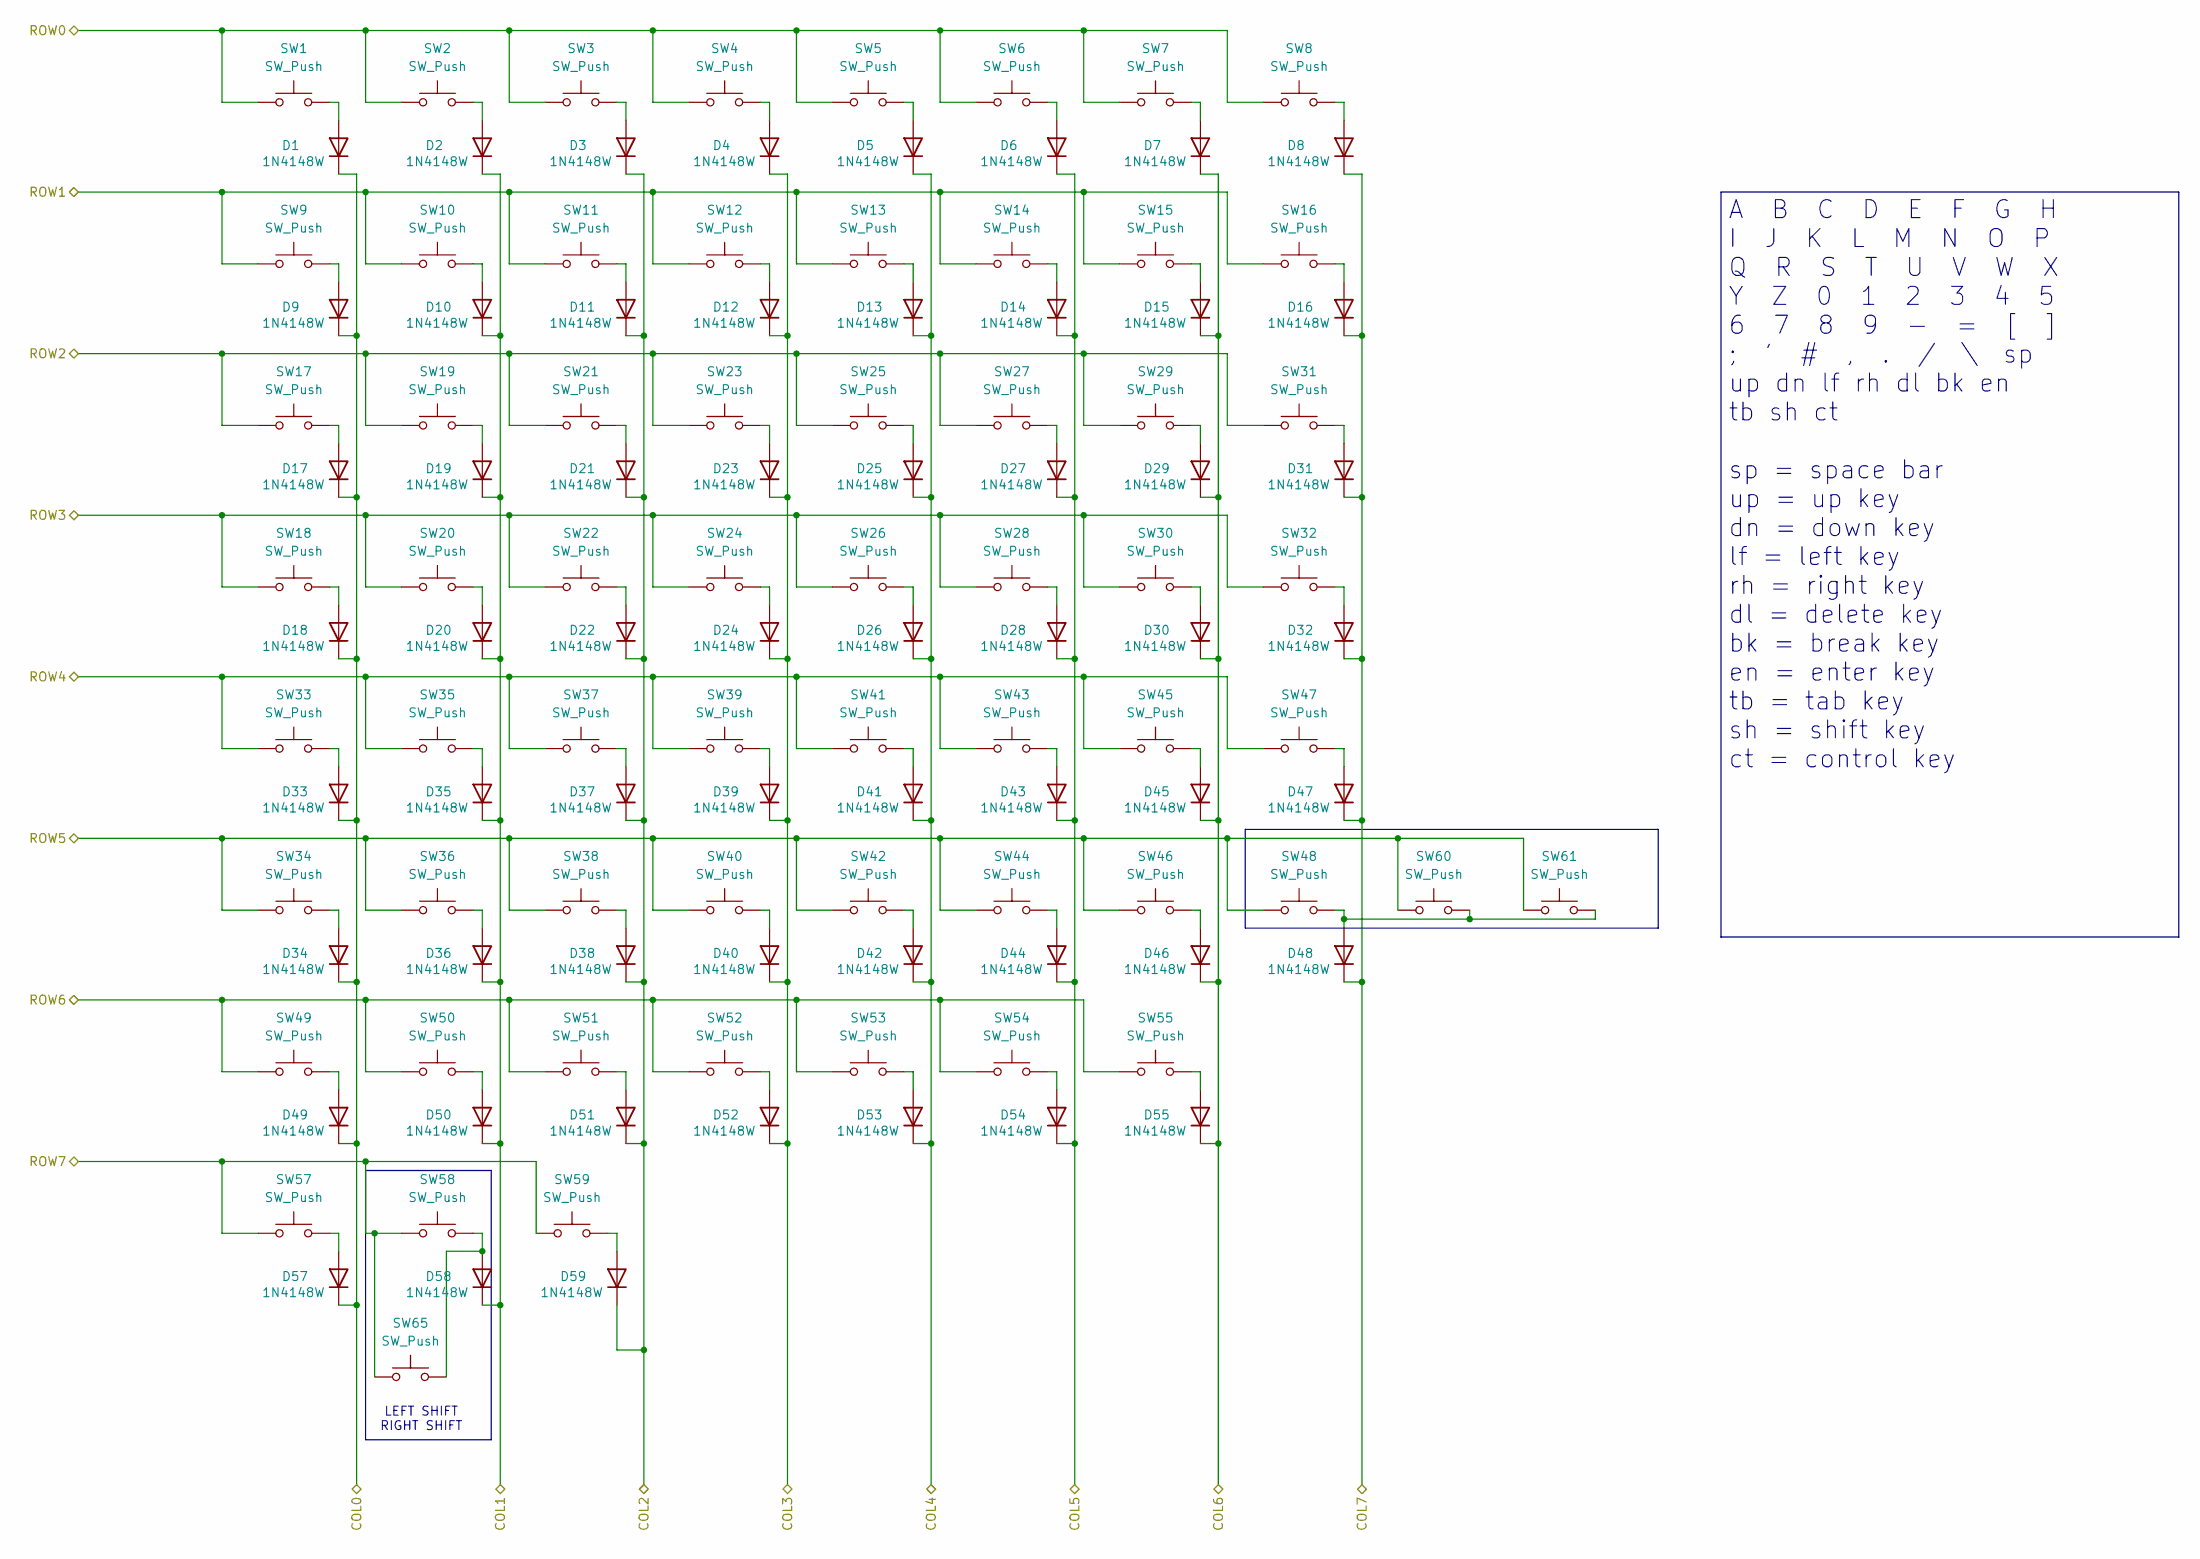
[picture p55: schematic KeyMatrix.kicad_sch]

Parts:
D1, D2, D3, D4, D5, D6, D7, D8, D9, D10, D11, D12, D13, D14, D15, D16, D17, D18, D19, D20, D21, D22, D23, D24, D25, D26, D27, D28, D29, D30, D31, D32, D33, D34, D35, D36, D37, D38, D39, D40, D41, D42, D43, D44, D45, D46, D47, D48, D49, D50, D51, D52, D53, D54, D55, D57, D58, D59: 1N4148W; D_SOD-123; LCSC C2099
SW1, SW2, SW3, SW4, SW5, SW6, SW7, SW8, SW9, SW10, SW11, SW12, SW13, SW14, SW15, SW16, SW17, SW18, SW19, SW20, SW21, SW22, SW23, SW24, SW25, SW26, SW27, SW28, SW29, SW30, SW31, SW32, SW33, SW34, SW35, SW36, SW37, SW38, SW39, SW40, SW41, SW42, SW43, SW44, SW45, SW46, SW47, SW48, SW49, SW50, SW51, SW52, SW53, SW54, SW55, SW57, SW58, SW59, SW60, SW61, SW65: SW_Push; SW_PG1350; LCSC DNF

Connections:
/KeyMatrix/COL0: D1.1 (K), D9.1 (K), D17.1 (K), D18.1 (K), D33.1 (K), D34.1 (K), D49.1 (K), D57.1 (K); also elsewhere on the board
/KeyMatrix/COL1: D2.1 (K), D10.1 (K), D19.1 (K), D20.1 (K), D35.1 (K), D36.1 (K), D50.1 (K), D58.1 (K); also elsewhere on the board
/KeyMatrix/COL2: D3.1 (K), D11.1 (K), D21.1 (K), D22.1 (K), D37.1 (K), D38.1 (K), D51.1 (K), D59.1 (K); also elsewhere on the board
/KeyMatrix/COL3: D4.1 (K), D12.1 (K), D23.1 (K), D24.1 (K), D39.1 (K), D40.1 (K), D52.1 (K); also elsewhere on the board
/KeyMatrix/COL4: D5.1 (K), D13.1 (K), D25.1 (K), D26.1 (K), D41.1 (K), D42.1 (K), D53.1 (K); also elsewhere on the board
/KeyMatrix/COL5: D6.1 (K), D14.1 (K), D27.1 (K), D28.1 (K), D43.1 (K), D44.1 (K), D54.1 (K); also elsewhere on the board
/KeyMatrix/COL6: D7.1 (K), D15.1 (K), D29.1 (K), D30.1 (K), D45.1 (K), D46.1 (K), D55.1 (K); also elsewhere on the board
/KeyMatrix/COL7: D8.1 (K), D16.1 (K), D31.1 (K), D32.1 (K), D47.1 (K), D48.1 (K); also elsewhere on the board
unnamed: D1.2 (A), SW1.2
unnamed: D2.2 (A), SW2.2
unnamed: D3.2 (A), SW3.2
unnamed: D4.2 (A), SW4.2
unnamed: D5.2 (A), SW5.2
unnamed: D6.2 (A), SW6.2
unnamed: D7.2 (A), SW7.2
unnamed: D8.2 (A), SW8.2
unnamed: D9.2 (A), SW9.2
unnamed: D10.2 (A), SW10.2
unnamed: D11.2 (A), SW11.2
unnamed: D12.2 (A), SW12.2
unnamed: D13.2 (A), SW13.2
unnamed: D14.2 (A), SW14.2
unnamed: D15.2 (A), SW15.2
unnamed: D16.2 (A), SW16.2
unnamed: D17.2 (A), SW17.2
unnamed: D18.2 (A), SW18.2
unnamed: D19.2 (A), SW19.2
unnamed: D20.2 (A), SW20.2
unnamed: D21.2 (A), SW21.2
unnamed: D22.2 (A), SW22.2
unnamed: D23.2 (A), SW23.2
unnamed: D24.2 (A), SW24.2
unnamed: D25.2 (A), SW25.2
unnamed: D26.2 (A), SW26.2
unnamed: D27.2 (A), SW27.2
unnamed: D28.2 (A), SW28.2
unnamed: D29.2 (A), SW29.2
unnamed: D30.2 (A), SW30.2
unnamed: D31.2 (A), SW31.2
unnamed: D32.2 (A), SW32.2
unnamed: D33.2 (A), SW33.2
unnamed: D34.2 (A), SW34.2
unnamed: D35.2 (A), SW35.2
unnamed: D36.2 (A), SW36.2
unnamed: D37.2 (A), SW37.2
unnamed: D38.2 (A), SW38.2
unnamed: D39.2 (A), SW39.2
unnamed: D40.2 (A), SW40.2
unnamed: D41.2 (A), SW41.2
unnamed: D42.2 (A), SW42.2
unnamed: D43.2 (A), SW43.2
unnamed: D44.2 (A), SW44.2
unnamed: D45.2 (A), SW45.2
unnamed: D46.2 (A), SW46.2
unnamed: D47.2 (A), SW47.2
unnamed: D48.2 (A), SW48.2, SW60.2, SW61.2
unnamed: D49.2 (A), SW49.2
unnamed: D50.2 (A), SW50.2
unnamed: D51.2 (A), SW51.2
unnamed: D52.2 (A), SW52.2
unnamed: D53.2 (A), SW53.2
unnamed: D54.2 (A), SW54.2
unnamed: D55.2 (A), SW55.2
unnamed: D57.2 (A), SW57.2
unnamed: D58.2 (A), SW58.2, SW65.2
unnamed: D59.2 (A), SW59.2
ROW0: SW1.1, SW2.1, SW3.1, SW4.1, SW5.1, SW6.1, SW7.1, SW8.1; also elsewhere on the board
ROW1: SW9.1, SW10.1, SW11.1, SW12.1, SW13.1, SW14.1, SW15.1, SW16.1; also elsewhere on the board
ROW2: SW17.1, SW19.1, SW21.1, SW23.1, SW25.1, SW27.1, SW29.1, SW31.1; also elsewhere on the board
ROW3: SW18.1, SW20.1, SW22.1, SW24.1, SW26.1, SW28.1, SW30.1, SW32.1; also elsewhere on the board
ROW4: SW33.1, SW35.1, SW37.1, SW39.1, SW41.1, SW43.1, SW45.1, SW47.1; also elsewhere on the board
ROW5: SW34.1, SW36.1, SW38.1, SW40.1, SW42.1, SW44.1, SW46.1, SW48.1, SW60.1, SW61.1; also elsewhere on the board
ROW6: SW49.1, SW50.1, SW51.1, SW52.1, SW53.1, SW54.1, SW55.1; also elsewhere on the board
ROW7: SW57.1, SW58.1, SW59.1, SW65.1; also elsewhere on the board

Notes on the sheet:
LEFT SHIFT RIGHT SHIFT
A B C D E F G H I J K L M N O P Q R S T U V W X Y Z 0 1 2 3 4 5 6 7 8 9 - = [ ] ; ' # , . / \ sp up dn lf rh dl bk en tb sh ct sp = space bar up = up key dn = down key lf = left key rh = right key dl = delete key bk = break key en = enter key tb = tab key sh = shift key ct = control key
