TechPaula/LT6502/Schematics/Keybed/LT6502_KEYBED.kicad_pcb

## KiCad design Schematics/Keybed/LT6502_KEYBED.kicad_pcb (continued)

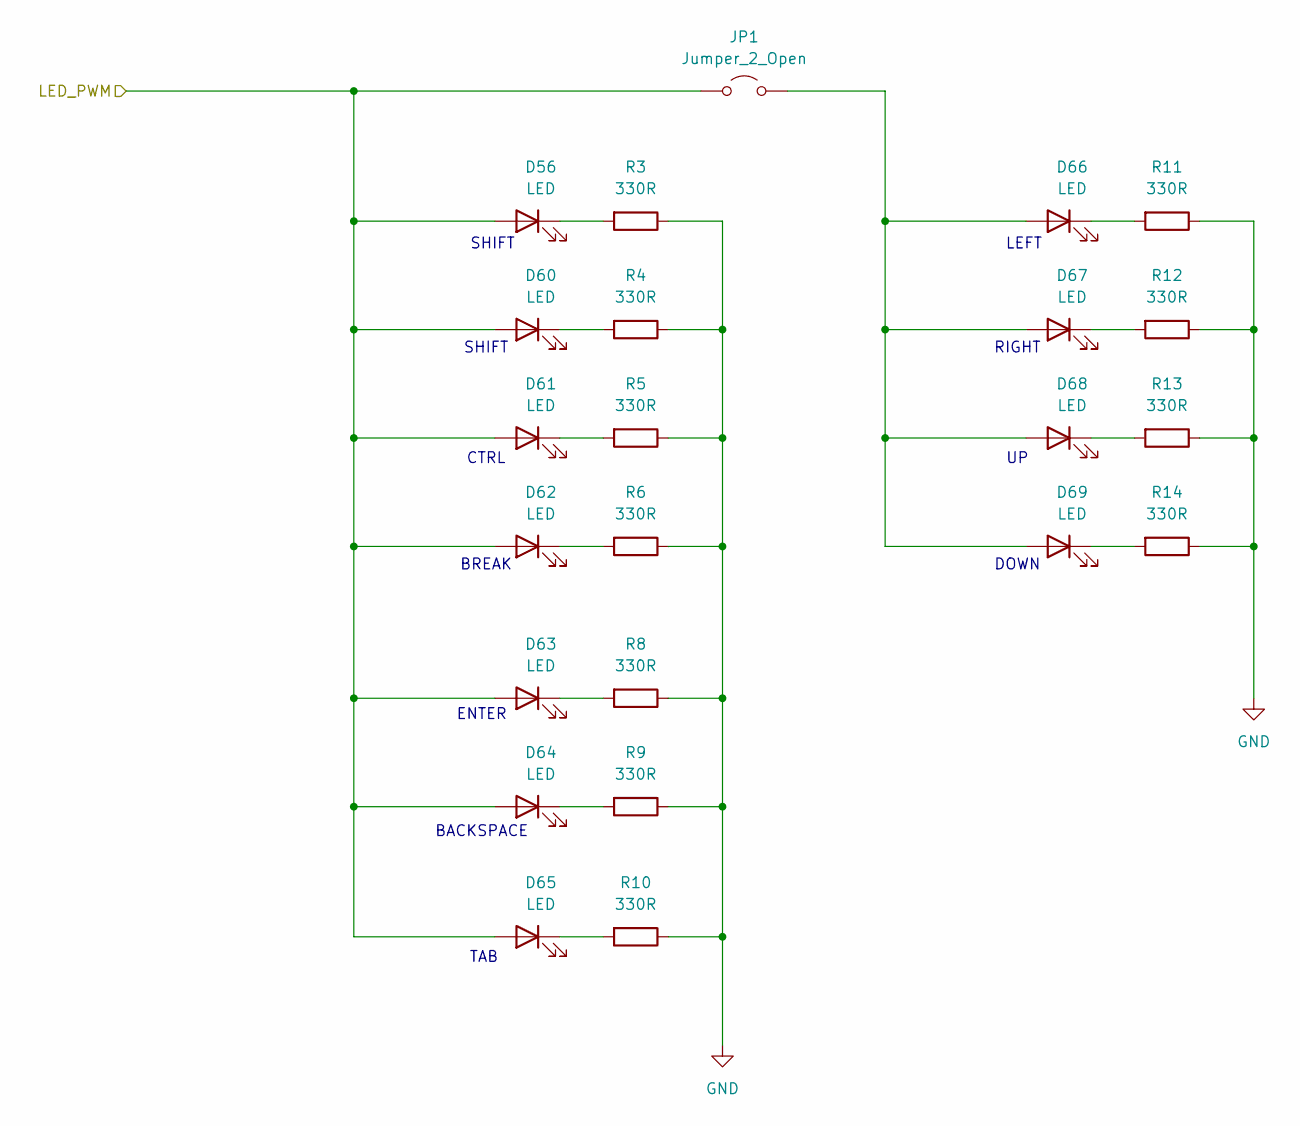
[picture p56: schematic keyleds.kicad_sch]

Parts:
D56, D60, D61, D62, D63, D64, D65, D66, D67, D68, D69: LED; LED_0603_1608Metric; LCSC C3030991
JP1: Jumper_2_Open; SolderJumper-2_P1.3mm_Open_TrianglePad1.0x1.5mm; LCSC DNF
R3, R4, R5, R6, R8, R9, R10, R11, R12, R13, R14: 330R; R_0603_1608Metric_Pad0.98x0.95mm_HandSolder; LCSC DNF

Connections:
/KEY_LEDs/LED_PWM: D56.2 (A), D60.2 (A), D61.2 (A), D62.2 (A), D63.2 (A), D64.2 (A), D65.2 (A), JP1.1 (A); also elsewhere on the board
GND: R3.1, R4.1, R5.1, R6.1, R8.1, R9.1, R10.1, R11.1, R12.1, R13.1, R14.1; also elsewhere on the board
unnamed: D56.1 (K), R3.2
unnamed: D60.1 (K), R4.2
unnamed: D61.1 (K), R5.2
unnamed: D62.1 (K), R6.2
unnamed: D63.1 (K), R8.2
unnamed: D64.1 (K), R9.2
unnamed: D65.1 (K), R10.2
unnamed: D66.2 (A), D67.2 (A), D68.2 (A), D69.2 (A), JP1.2 (B)
unnamed: D66.1 (K), R11.2
unnamed: D67.1 (K), R12.2
unnamed: D68.1 (K), R13.2
unnamed: D69.1 (K), R14.2

Notes on the sheet:
BREAK
TAB
SHIFT
DOWN
CTRL
LEFT
RIGHT
BACKSPACE
ENTER

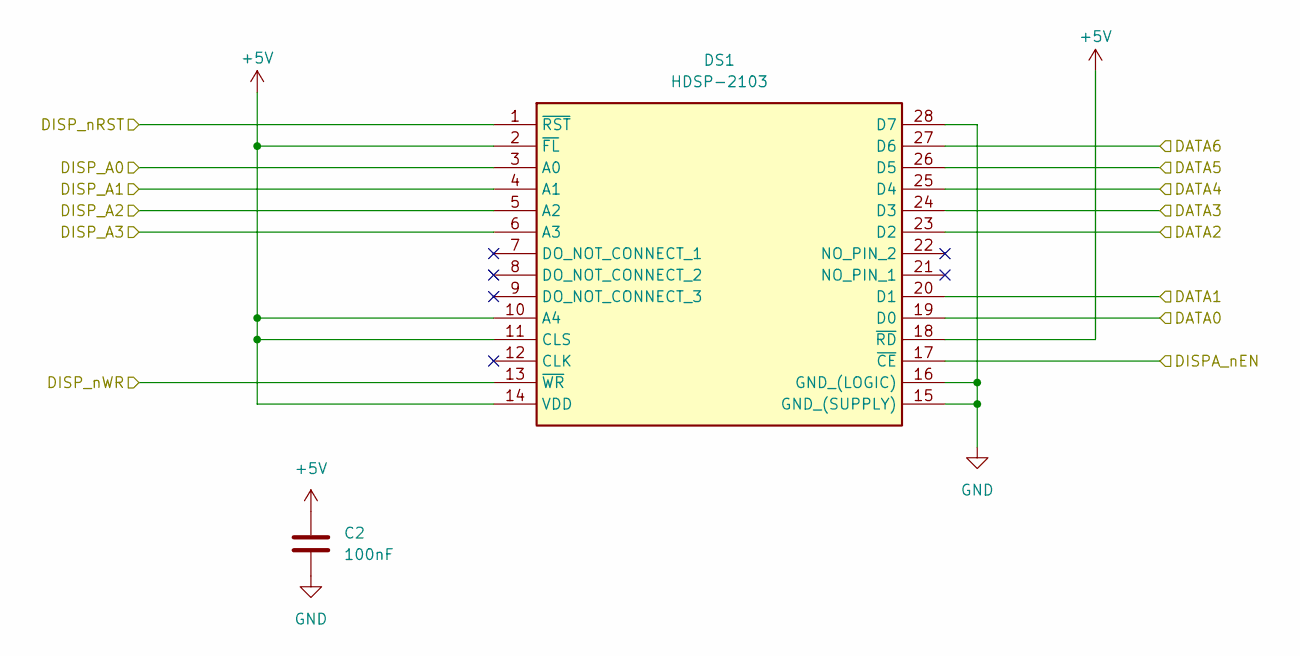
[picture p57: schematic Dual_QDSP-2118.kicad_sch]

Parts:
C2: 100nF; C_0805_2012Metric; LCSC C49678
DS1: HDSP-2103; DIPS1524W64P254L7087H685Q28N; Manufacturer_Part_Number HDSP-2503; Mouser Part Number 630-HDSP-2503

Connections:
+5V: C2.1, DS1.2 (~FL), DS1.10 (A4), DS1.11 (CLS), DS1.14 (VDD), DS1.18 (~RD); also elsewhere on the board
/DISPLAYs/DATA0: DS1.19 (D0); also elsewhere on the board
/DISPLAYs/DATA1: DS1.20 (D1); also elsewhere on the board
/DISPLAYs/DATA2: DS1.23 (D2); also elsewhere on the board
/DISPLAYs/DATA3: DS1.24 (D3); also elsewhere on the board
/DISPLAYs/DATA4: DS1.25 (D4); also elsewhere on the board
/DISPLAYs/DATA5: DS1.26 (D5); also elsewhere on the board
/DISPLAYs/DATA6: DS1.27 (D6); also elsewhere on the board
/DISPLAYs/DISPA_nEN: DS1.17 (~CE); also elsewhere on the board
/DISPLAYs/DISP_nRST: DS1.1 (~RST); also elsewhere on the board
/DISPLAYs/DISP_nWR: DS1.13 (~WR); also elsewhere on the board
AVR_TDO: DS1.6 (A3); also elsewhere on the board
DISP_A0: DS1.3 (A0); also elsewhere on the board
DISP_A1: DS1.4 (A1); also elsewhere on the board
DISP_A2: DS1.5 (A2); also elsewhere on the board
GND: C2.2, DS1.15 (GND_(SUPPLY)), DS1.16 (GND_(LOGIC)), DS1.28 (D7); also elsewhere on the board

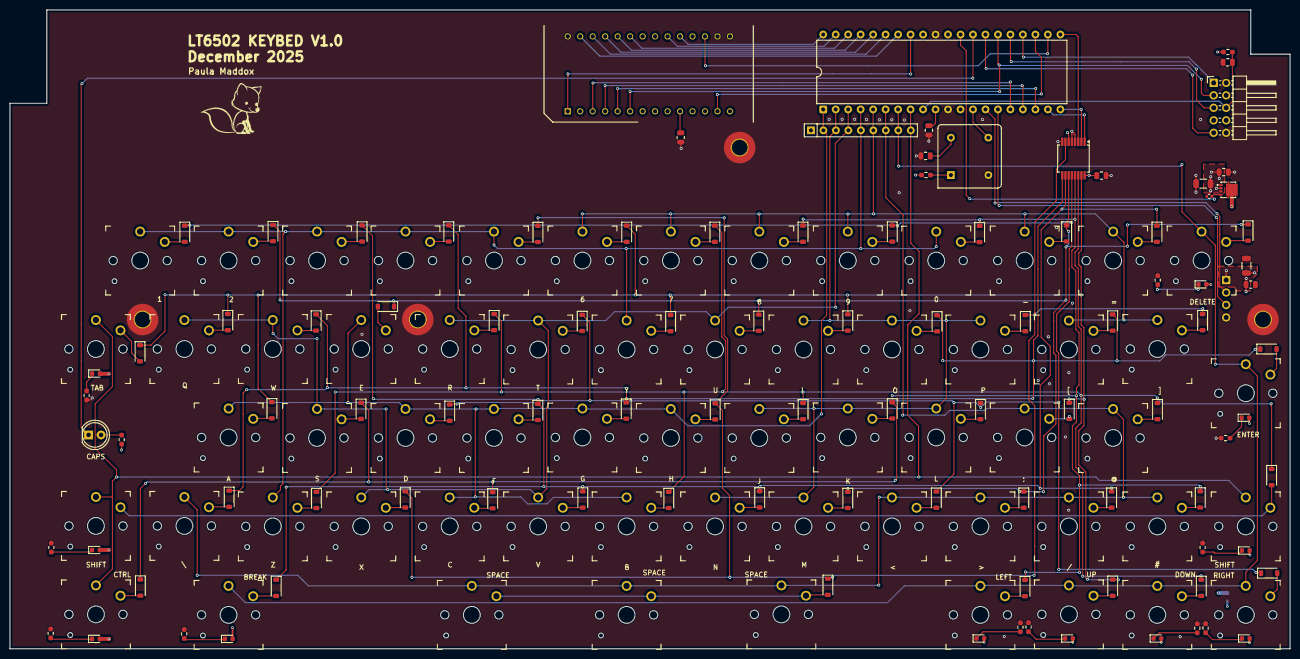
[picture p58: board LT6502_KEYBED.kicad_pcb from above]

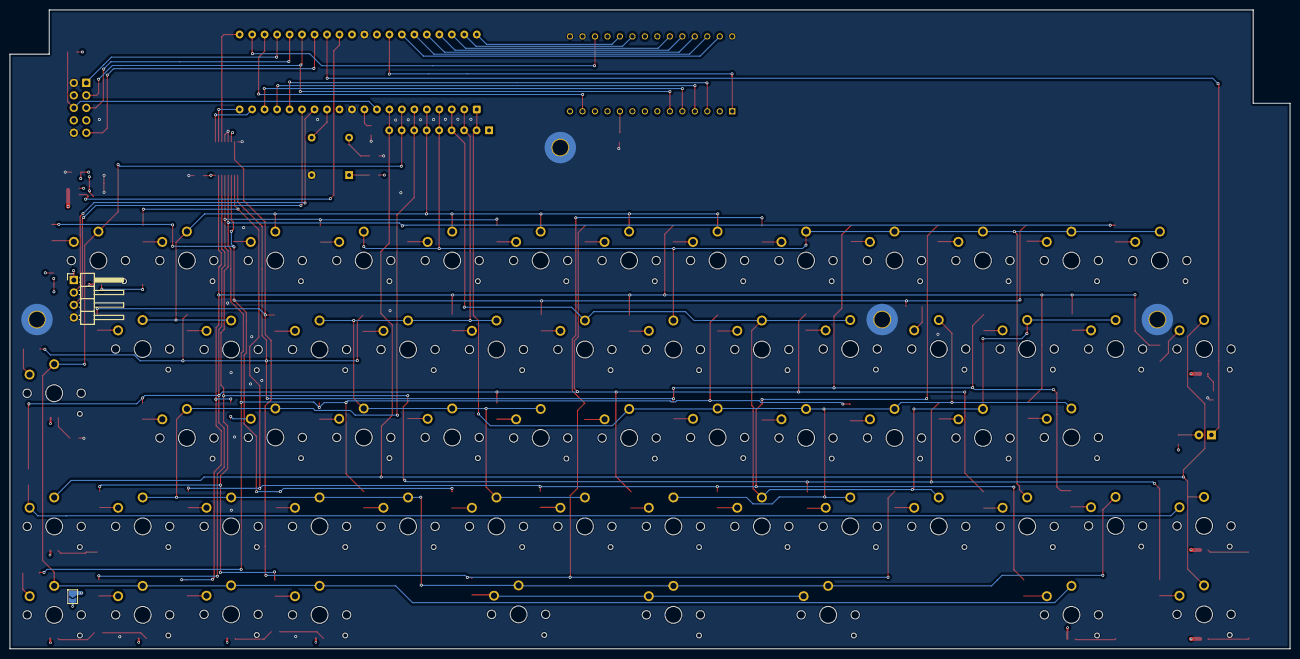
[picture p59: board LT6502_KEYBED.kicad_pcb from below]

Board: 4 copper layers, 260.5 x 130.0 mm, 169 parts (2 on the bottom side), 117 nets.
