TechPaula/LT6502/(commit log)

2025-11-12 Work in Progress
    Work in progress for Schematics and PCB
    [60FAKE50.kicad_sch, CompactFlash.kicad_sch, DisplayConnector.kicad_sch, Expansion.kicad_sch, Glue_Addr.kicad_sch, KeyboardIF.kicad_sch, LT6502.kicad_pcb, LT6502.kicad_sch]
2025-11-14 Tweaks to Schematics
    Shrunk main PCB
    [60FAKE50.kicad_sch, Expansion.kicad_sch, Glue_Addr.kicad_sch, LT6502.kicad_pcb, LT6502.kicad_sch, Power.kicad_sch]
2025-11-15 Further work on Schematics, All parts placed on PCB
    [60FAKE50.kicad_sch, CompactFlash.kicad_sch, DisplayConnector.kicad_sch, Glue_Addr.kicad_sch, KeyboardIF.kicad_sch, LT6502.kicad_sch, Power.kicad_sch]
2025-12-14 Updated main board and started keybed
    main board a bit wider due to keybed width
    created keybed, begun routing
    [60FAKE50.kicad_sch, CompactFlash.kicad_sch, DisplayConnector.kicad_sch, Dual_QDSP-2118.kicad_sch, Expansion.kicad_sch, Glue_Addr.kicad_sch, KeyMatrix.kicad_sch, KeyboardIF.kicad_sch]
2025-12-17 Added speaker
    Added a simple LM386/speaker and link to CPLD for simple audio.
    Updated step files
    [Audio.kicad_sch, Glue_Addr.kicad_sch, LT6502.kicad_pcb, LT6502.kicad_sch, LT6502_SIMPLE.step]
2025-12-17 Routing Completed
    Routing completed, removed silkscreen IDs for clarity
    [LT6502_KEYBED.kicad_pcb, LT6502_KEYBED.kicad_sch, LT6502_KEYBED.step]
2025-12-19 WIP images of case
2025-12-19 Updated step file for keybed
    [LT6502_KEYBED.kicad_pcb, LT6502_KEYBED.step]
2025-12-19 edited PCB dimensions
    Loved LHS in 0.5mm to ensure it clears the case edge
    [LT6502_KEYBED.kicad_pcb, LT6502_KEYBED.step]
2025-12-19 Early case design to test print
    [LT6502_BaseTop_20251219.stl, LT6502_base_20251219.stl]
2025-12-20 Updated BoMs ordered PCBs
    [60FAKE50.kicad_sch, Audio.kicad_sch, CompactFlash.kicad_sch, DisplayConnector.kicad_sch, Dual_QDSP-2118.kicad_sch, Expansion.kicad_sch, Glue_Addr.kicad_sch, KeyMatrix.kicad_sch]
2025-12-20 Added render of case with lid
2025-12-23 added 1st expansion card
    Created a PCB and mocked up parts to check fit in case
    [EXP-TRANSPUTER.kicad_pcb, EXP-TRANSPUTER.kicad_sch, EXP-TRANSPUTER.step, LT6502.kicad_pcb]
2025-12-23 EXP card, updated PCB dimensions
    [EXP-TRANSPUTER.kicad_pcb, EXP-TRANSPUTER.step]
2025-12-23 EXP Card, change to dimensions
    Brought dimensions in a little to ensure it fits within case.
    [EXP-TRANSPUTER.kicad_pcb, EXP-TRANSPUTER.step]
2025-12-23 Added image of expansion slot
2025-12-26 Added first draft of display bezel
    [LT6502_Display_Back_20251226.stl, LT6502_Display_Front_20251226.stl]
2025-12-26 Added test hinge
    Taken from here - https://www.printables.com/model/658393-friction-hinge-mechanism/comments#preview.file.aPNjd
    [TestHinge.3mf]
2025-12-26 Added separate STL files for hinge
    [HighBody_ptB.stl, HingeBody_ptA.stl, HingeBody_ptC.stl, HingeBody_ptD.stl, HingeSeatA.stl, HingeSeatB.stl]
2025-12-26 Added my own hinge
    [LT6502_HINGE_LHS.stl, LT6502_HINGE_LID.stl, LT6502_HINGE_RHS.stl, LT6502_THREAD_BARREL.stl]
2025-12-26 Compartment covers
    [BatteryCover.stl, ExpansionCover.stl]
2025-12-27 Case tweaks, rexport
    [BatteryCover.stl, EXP-TRANSPUTER.kicad_pcb, EXP-TRANSPUTER.step, ExpansionCover.stl, HighBody_ptB.stl, HingeBody_ptA.stl, HingeBody_ptC.stl, HingeBody_ptD.stl]
2025-12-27 Updated Expansion board
    [EXP-TRANSPUTER.step]
2025-12-28 Added print files for final case.
    [LT6502_BASE_HINGES_COVERS.3mf, LT6502_DISPLAY_CASE.3mf]
2025-12-30 shorten expansion cover to fit
    [ExpansionCover.stl]
2025-12-30 Updated 3D prints, added BoM info
    [Keybed_JLC_assembly_parts_bom.xls, LT6502_BASE.3mf, LT6502_BASETOP_HINGES_COVERS.3mf, LT6502_BASE_HINGES_COVERS.3mf, LT6502_DISPLAY_CASE.3mf, MainBoard_JLC_assembled_parts_bom.xls]
2025-12-31 Split Prints added BoM
    Split the base top (Keyboard surround) into it's own file to make printing easier.
    Added a list of parts needed for fixing the case together.
    [LT6502_BASETOP.3mf, LT6502_HINGES_COVERS.3mf]
2025-12-31 Added light pipe holes
    [LT6502_BASE_TOP.stl]
2025-12-31 Add power button
    [PowerButton.stl]
2025-12-31 added power button to print file
    [LT6502_BASETOP.3mf, LT6502_HINGES_COVERS.3mf]
2026-01-03 Added STUSB4500 program for Teensy
    Simple bit of code to configure the STUSB4500 to request only 5V voltages from a USB-PD capable supply.
2026-01-03 Auto stash before merge of "main" and "origin/main"
    [60FAKE50.kicad_sch, Audio.kicad_sch, CompactFlash.kicad_sch, DisplayConnector.kicad_sch, Expansion.kicad_sch, Glue_Addr.kicad_sch, KeyboardIF.kicad_sch, LT6502.kicad_pcb]
2026-01-03 Simple CPLD Glue working
    Basic CPLD glue logic working with same memory mac as PC6502)
2026-01-03 CPLD Glue
    Added 2nd RAM chip, extending the memory to almost 48K
2026-01-03 Firmware update
    Updated firmware (ROM) to fit new memory map and extra memory.
    [MemoryMap.ods, basic.cfg]
2026-01-03 Added enable for TXS0108 on data bus
    [DisplayConnector.kicad_sch, Glue_Addr.kicad_sch, LT6502.kicad_pcb, LT6502.kicad_sch]
2026-01-03 Updated Schematic/PCB with comments
    [LT6502.kicad_pcb, LT6502.kicad_sch]
2026-01-03 Updated memory map with beeper and gap
    [MemoryMap.ods]
2026-01-04 Updated Glue
2026-01-04 Updated ACIA test
    [LT6502_KEYBED.kicad_sch]
2026-01-05 Keyboard work/Images/schematic update
    min_mon.asm now has the required functions in to pass data from the keyboard TO basic!!
    I've added a few images of the build as I test things
    Added notes to Schematic
    [Expansion.kicad_sch, LT6502.kicad_pcb, LT6502.kicad_sch, basic.cfg]
2026-01-05 Updated Schematic/PCB
    Fixed battery connector polarity to save swapping wires.
    [LT6502.kicad_pcb, LT6502.kicad_sch, Power.kicad_sch]
2026-01-05 Expansion Template + Main Board update
    Created an expansion board template with main connector and correct PCB size
    Fixed bug with Charging circuit on main board that meant it wouldn't charge when off.
    [Connector.kicad_sch, Expansion-Template.kicad_pcb, Expansion-Template.kicad_sch, LT6502.kicad_pcb, LT6502.kicad_sch, Power.kicad_sch]
2026-01-08 Added beeper test code
    Built and programmed main glue
    Added basic beeper test
2026-01-09 LED value change, added fix for FTDI power
    [60FAKE50.kicad_sch, Audio.kicad_sch, LT6502.kicad_pcb, LT6502.kicad_sch, Power.kicad_sch]
2026-01-09 glue logic work (CF/Beeper)
2026-01-09 working on CF write
    CF reading is fine, writing is not
    [CompactFlash.kicad_sch]
2026-01-09 CF now read/writing
    Compact flash test code now writes and reads.
    [LT6502.kicad_pcb]
2026-01-16 Moved eWoz and Minmon
    Moved ewoz and minmon so I have extra space in the IOHANDLER (min_mon) to add in routines to configure screen and output to it.
    [basic.cfg]
2026-01-16 PCB/Schematic edits
    moved speaker hole a little
    made nRES resistor for display no fit (this upsets them for some reason)
    Added diodes to ensure USB Console chip is powered when nothing attached (this causes issues with booting.
    [60FAKE50.kicad_sch, DisplayConnector.kicad_sch, Glue_Addr.kicad_sch, LT6502.kicad_pcb, LT6502.kicad_sch, Power.kicad_sch]
2026-01-18 Begun work on transputer expansion board
    [Connector.kicad_sch, EXP-TRANSPUTER.kicad_pcb, EXP-TRANSPUTER.kicad_sch, EXP-TRANSPUTER.step, GLUE.kicad_sch, LinkAdapter.kicad_sch, TRAMOnBoard.kicad_sch]
2026-01-18 Added place holder for display init on power on
2026-01-18 Work on case
    [LT6502_BASE.3mf, LT6502_BASE.stl, LT6502_BASETOP.3mf, LT6502_BASE_LOWER.stl, LT6502_BASE_TOP.stl, LT6502_DISPLAY_CASE.3mf, LT6502_DISPLAY_FRONT.stl, LT6502_DISPLAY_REAR.stl]
2026-01-18 Glue edit
    trying to figure out why CF seems to cause errors
2026-01-18 New case printer files
    [LT6502_BASE_LOWER.3mf, LT6502_BASE_TOP.3mf]
2026-01-22 Add DIR
    Added DIR to EhBASIC which calls a minmon function, currently just "beeps" but it works!
2026-01-23 Glue update
    Updated Display pins and added missing logic
    Added simple SR latch for beeper.
2026-01-23 Found a bug with console input when Keyboard attached
    See comments on line 198 of min_mon.asm for outline of problem
2026-01-23 Updated Schematics
    Added bulk capacitance with higher ESR to help with display PLL starting
    [DisplayConnector.kicad_sch, Glue_Addr.kicad_sch, LT6502.kicad_pcb, LT6502.kicad_sch, Power.kicad_sch]
2026-01-23 GLUE updated to add DISP_nWT
    Added the DISP_nWT pin to D2 when read from the Display address+2 (or +3)
2026-01-24 Updated current limits
    Updated the current limits as we were pushing the previous limit (900mA) with display, keyboard and CF
    [LT6502.kicad_pcb, Power.kicad_sch]
2026-01-25 Added switch graphics mode
2026-01-30 Added beep
    Added variable pitch beep, slimmed down power on and error beeps
    only works with immediate values for now
2026-01-30 New base lower, base top and power button
    [LT6502_BASE_LOWER.stl, LT6502_BASE_TOP.stl, PowerButton.stl]
2026-02-02 saved lower case .3MF file
    [LT6502_BASE_LOWER.3mf]
2026-02-04 Updated case parts (lower)
    Updated case top/bottom/button and expansion cover
    [ExpansionCover.stl, LT6502_BASE_LOWER.stl, LT6502_BASE_TOP.stl, PowerButton.stl]
2026-02-06 Create screen and hinge parts
    [Hinge_Base_LHS.stl, Hinge_Base_RHS.stl, Hinge_LidPart.stl, Hinge_ThreadedHollowHex.stl, LT6502_DisplayBack.stl, LT6502_DisplayFront.stl]
2026-02-07 LOAD & SAVE WORKING
    Load and save using JUST a "slot" number works!!
2026-02-07 Added load error for blank slot
2026-02-08 Changed limit for DIR
    DIR now scans the first 2048 Slots only, it takes too long to do more.
2026-02-08 Updated parts for lid
    [Hinge_LidPart.stl, LT6502_DisplayFront.stl]
2026-02-08 Updated 3D print files.
    [LT6502_BASE_TOP.3mf, LT6502_DisplayBack.3mf]
2026-02-11 Resolve issue with Lid Hinge part
    [Hinge_LidPart.stl]
2026-02-11 Work on hinge parts
    [Hinge_LidPart.stl, Hinge_ThreadedHollowHex.stl]
2026-02-11 Updated Hinge & front bezel
    [Hinge_Base_LHS.stl, Hinge_Base_RHS.stl, Hinge_LidPart.stl, LT6502_DisplayFront.stl]
2026-02-14 Updated print files and added photos of assembled unit
    [HingeParts.3mf, LT6502_DisplayFront.3mf]
2026-02-21 Work on Expansion card
    I keep changing my mind what is on this, so who knows.
    [Connector.kicad_sch, FPU.kicad_sch, Glue.kicad_sch, LUT.kicad_sch, LinkAdapter.kicad_sch, Modem.kicad_sch, Multi-Ex.kicad_pcb, Multi-Ex.kicad_sch]
2026-02-22 Multi-expansion card routed.
    [Expansion-Template.step, FPU.kicad_sch, Glue.kicad_sch, Multi-Ex.kicad_pcb, Multi-Ex.kicad_sch]
